Roboparty/RP1_test/hardware/mechanical/手臂胸腔/共用资料/README.md

# 手臂与胸腔共用资料

| 目录 | 内容 |
| --- | --- |
| [manufacturing](manufacturing/) | CNC、型材与钣金的 PDF 加工图和 STEP 模型 |
| [bom](bom/) | 机械采购工作簿及分类采购表 |
| [architecture](architecture/README.md) | 全平台、肢体连接与单支路架构图 |

采购入口为 [机械采购表](bom/mechanical-procurement.csv)。采购以零件号、版本、对应工装与加工图为依据，避免重复统计总装和分类表中的相同零件。不同机器人型号的夹具不直接互换。
