Roboparty/RP1_test/hardware/mechanical/手臂胸腔/手臂测试平台/README.md

# 手臂测试平台

用于手臂总成固定与测试接口集成，采用 LS75 手臂工装。

| 资料 | 入口 |
|---|---|
| 工装加工图 | [PDF](<图纸/YCL.M000438 LS75手臂工装.PDF>) · [STEP](<图纸/YCL.M000438 LS75手臂工装.STEP>) |
| BOM 与通用加工资料 | [共用资料](../共用资料/README.md) |

手臂与胸腔的通用加工资料和采购表位于共用资料目录。安装前核对机器人型号、工装接口、反力矩与运动空间，设置线束固定、支撑和防护。
