Roboparty/RP1_test/hardware/mechanical/手臂胸腔/胸腔测试平台/README.md

# 胸腔测试平台

用于胸腔总成固定与测试接口集成。`图纸/` 包含胸腔底板、航插安装板、立柱及 LOGO 板的 PDF / STEP。

- [BOM 与通用加工资料](../共用资料/README.md)

胸腔与手臂的通用加工资料和采购表位于共用资料目录。安装前核对接口尺寸、总质量、重心、反力路径和布线空间；腰部夹具应按具体总成单独匹配。
