Roboparty/RP1_test/hardware/mechanical/腿部/腿部负载测试平台/README.md

# 腿部负载测试平台

用于腿部总成固定及加载机构集成。本目录提供平台采购工作簿。

| 资料 | 入口 |
| --- | --- |
| 机械 BOM | [腿部老化测试平台 BOM 20260601.xlsx](<bom/腿部老化测试平台 BOM 20260601.xlsx>) |

采购使用工作表 `腿部老化测试平台 项目结构件 BOM`，按零件号和版本核对采购规格。其他工作表不纳入台架采购。

加载装置、测量链、回馈处理、重力支撑与防护应按机器人型号及目标工况配置。连接方式见[机电集成说明](../../../docs/integration.md)。
