Roboparty/RP1_test/hardware/mechanical/手臂胸腔/共用资料/architecture/README.md

# 硬件架构图

| 图 | 内容 |
|---|---|
| [platform-overview.svg](platform-overview.svg) | 上位机、控制柜、机器人总成、机械台架与安全/能量系统 |
| [limb-connection.svg](limb-connection.svg) | 带驱动器总成的供电、CAN 节点及辅助接口 |
| [channel-wiring.svg](channel-wiring.svg) | 单支路保护、固态开关与电压电流采样 |

SVG 为可编辑图源，PNG 用于预览。架构图表达功能关系；施工接线应依据原理图、端子表和机器人厂家的接口定义。
