Roboparty/RP1_test/hardware/SOURCE_LICENSE.md

# 硬件资料许可

RoboParty 自有的测试台架机械、电气设计及对应制造图、原创 BOM 数据采用 [CERN-OHL-W-2.0](LICENSE)。文档、参考模型和第三方素材按以下范围分别处理，不能只根据所在目录判断许可。

## 台架设计

许可覆盖项目贡献者有权授权的台架设计部分，包括手臂、胸腔共用支架、对应工装及腿部负载测试平台设计。主要资料入口：

- [手臂、胸腔共用资料](mechanical/手臂胸腔/共用资料/)：YCL 工装与支架的制造文件、台架采购清单。
- [手臂测试平台](mechanical/手臂胸腔/手臂测试平台/)与[胸腔测试平台](mechanical/手臂胸腔/胸腔测试平台/)：相应工装、底板和安装件图纸。
- [腿部负载测试平台](mechanical/腿部/腿部负载测试平台/)：采购工作簿中记录的平台自有设计部分。
- [电气资料](electrical/)：本项目原创的系统 BOM 数据及随项目提供的自有电气设计。

装配体引用的供应商零件、机器人参考部件、标准件模型及附带素材不因进入上述装配体而改用 CERN 许可。料号或文件名也不能单独证明权利归属；当前未逐件确认所有参考模型和嵌入素材的来源与再分发授权，详见 [第三方资料](../THIRD_PARTY.md)。

设计源资料入口为 [Roboparty/rp1_test](https://github.com/Roboparty/rp1_test/tree/main/hardware)。分发适用 CERN 许可的产品或修改设计时，应按该许可提供相应版本的完整源资料和通知；采用链接提供源资料时，接收者需要能够取得这些资料。架构说明图不能代替实际制造、安装所需的工程源资料。

## 说明文档与既有 MIT 授权

原创 README、搭建说明、测试方法和解释性架构图采用 [CC-BY-SA-4.0](../LICENSES/CC-BY-SA-4.0.txt)。制造图和实际电气设计属于前述硬件设计范围。

此前已获 MIT 授权的本目录原创说明文档、架构图、模板及脚本继续保留该选择。文档和说明图可选 `MIT OR CC-BY-SA-4.0`；脚本可选 `MIT OR Apache-2.0`。[标准 MIT 全文](../LICENSES/MIT.txt)和[原版权通知及范围](../LICENSES/MIT-HARDWARE-NOTICE.txt)随仓库保留，既有授权权益不撤回。

## 参考资料与品牌

供应商 CAD、机器人模型、纹理、厂家手册和 SDK 按原权利人的条款使用。采购工作簿中的外部模板、供应商或客户信息、嵌入图片也不在本项目统一授权范围内。RoboParty 标识及产品名称的商标使用未由上述许可授予。
