Roboparty/RP1_test/LICENSES/MIT-HARDWARE-NOTICE.txt

MIT License

Copyright (c) 2026 Humanoid Module Test Platform contributors

Permission is hereby granted, free of charge, to any person obtaining a copy
of the original documentation, diagrams, templates, and scripts in this
directory (the "Materials"), to deal in the Materials without restriction,
including without limitation the rights to use, copy, modify, merge, publish,
distribute, sublicense, and/or sell copies of the Materials, and to permit
persons to whom the Materials are furnished to do so, subject to these conditions:

The above copyright notice and this permission notice shall be included in
all copies or substantial portions of the Materials.

THE MATERIALS ARE PROVIDED "AS IS", WITHOUT WARRANTY OF ANY KIND, EXPRESS OR
IMPLIED, INCLUDING BUT NOT LIMITED TO THE WARRANTIES OF MERCHANTABILITY,
FITNESS FOR A PARTICULAR PURPOSE AND NONINFRINGEMENT. IN NO EVENT SHALL THE
AUTHORS OR COPYRIGHT HOLDERS BE LIABLE FOR ANY CLAIM, DAMAGES OR OTHER
LIABILITY, WHETHER IN AN ACTION OF CONTRACT, TORT OR OTHERWISE, ARISING FROM,
OUT OF OR IN CONNECTION WITH THE MATERIALS OR THE USE OR OTHER DEALINGS IN
THE MATERIALS.

Third-party source archives, CAD, manufacturing drawings, workbooks, SDKs,
manufacturer documents, and reference assets are excluded. Their original
rights are unchanged. See SOURCE_LICENSE.md before redistribution.
