Roboparty/RP1_test/docs/README.md

# 文档导航

| 任务 | 入口 |
|---|---|
| 了解组件与连接 | [软件模块](../software/README.md) · [架构](architecture.md) |
| 安装、升级、备份、恢复或排障 | [安装与运维](../software/docs/operations.md) |
| 理解记录、归档、核实、审批和统计 | [数据流程](../software/docs/data-workflow.md) |
| 运行或构建上位机 | [HMI](../software/host/README.md) · [构建](../software/host/docs/build.md) |
| 核对 PLC 协议及故障准入 | [PLC 对接](../software/host/docs/plc-integration.md) |
| 开发与测试 | [开发指南](development.md) |
| 制造与搭建台架 | [硬件](../hardware/README.md) |
| 准备测试与执行记录 | [测试用例](../test-cases/README.md) |
| 查找截图、动图与许可 | [媒体](media/README.md) · [许可](../LICENSES.md) |

执行前需要确定的参数见 [参数清单](../test-cases/open-items.md)。
