Roboparty/RP1_test/data-analysis/examples/README.md

# 合成分析样例

[synthetic-run](synthetic-run) 包含 9 行单关节合成遥测、元数据、4 条事件和[独立预期值](synthetic-run/expected.json)。80 ℃和暂停时的 9 rad 误差为核对统计范围设置的合成值。

- 总时间 8 s；active 为 `[0,3)` 和 `[5,8)`，共 6 s。
- active 采样点为 0、1、2、5、6、7 s；6 s 的位置缺失，剩余误差为 0.1、0.2、−0.3、−0.1、0 rad。
- RMS 为 `sqrt((0.01+0.04+0.09+0.01+0)/5)`，约 0.173205 rad；绝对峰值 0.3 rad。
- 暂停时的 9 rad 误差不计入 active 统计；暂停时 80 ℃仍是全程温度峰值。环境温度 25 ℃，温升 55 ℃。
- 4 s 温度缺失；温度有效样本 8 个。NaN 不补零。

运行命令见[分析入口](../README.md)。`expected.json` 保存人工核对的关键指标，测试校验这些预期值及缺失区间、重复时间等边界。

这组样例数据采用 [CC0-1.0](../../LICENSES.md)；脚本和说明文档的许可分别见仓库许可范围。
