Roboparty/RP1_test/data-analysis/docs/README.md

# 数据采集与分析指导

本目录解释从测试目的到分析结论的过程，帮助使用者接入自己的机器人数据。**当前仅有本说明；下列专题文档待编写，文件名为计划。**

## 计划文档

| 文档 | 重点 |
|---|---|
| `architecture.md` | 上位机、Service、PostgreSQL、InfluxDB、Grafana与离线分析的分工 |
| `data-format.md` | 遥测、事件、运行元数据、单位、时间关联和缺失值 |
| `collection-guide.md` | 基线、配置快照、采样、任务区间与异常前后记录 |
| `analysis-guide.md` | 按用例选择指标，同工况比较与结论边界 |
| `platform-integration.md` | 文件导出、Service接入、离线缓存、补传与运行编号关联 |

输入是 [测试用例](../../test-cases/README.md)、机器人配置及采集记录；输出是指标定义、采集要求和结果解释步骤。系统范围见 [software](../../software/README.md)，采集与接入分别见 [上位机](../../software/host/README.md) 和 [Service](../../software/service/README.md)。

## 从用例选指标

| 用例方向 | 重点观察 |
|---|---|
| 001/003站立 | 温升是否收敛、负载如何影响误差、有效时长是否达到目标 |
| 002/016行走 | 相同路线和负载下的温升、误差、保护与试后性能变化 |
| 004～009环境/存储 | 恢复后与基线的差异、异常是否在相同条件重复 |
| 012热保护 | 告警→降额→停机的顺序、触发条件和响应时间 |
| 020/021动态与操作任务 | 中断动作段、成功/失败、重试、人工接管及节拍变化 |

## 共同约定

先确认 active intervals，再计算有效任务时长；换电、检查、冷却和异常暂停分别保留。跟随误差按同动作、负载和阶段的 active 样本比较，报告峰值与均方根。温度统计保留全程，有环境温度时才计算温升。

缺失值保持未知，断采期间不外推正常运行。里程、制动距离和抓取成功率需要对应任务记录；能耗需要电压、电流及时间，不能以关节扭矩代替。异常信号、故障确认、根因和复测结论分开描述；单次运行不推 MTBF，脚本不自动判 PASS。

**完成条件：** 每篇指导均说明必要输入、计算范围、输出和不足条件，并能带读者完成 [合成示例](../examples/README.md)；计划文件发布后再加入直接链接和运行命令。
