Roboparty/RP1_test/software/host/DELIVERY.md

# RP1 TEST HMI 交付入口

本版为 2.0.4、Ubuntu 24.04 amd64。请使用 [完整新机部署说明](../README.md) 和 [当前上位机构建与配置说明](docs/LOCAL_CONTROL_BUILD.md)。

协议模式为 `reliability_v1`；`legacy` 仅保留旧客户端兼容源码，不是本仓库平台协议。测试数据审批尚未实现。
