Roboparty/RP1_test/docs/media/factory-hmi.jpg

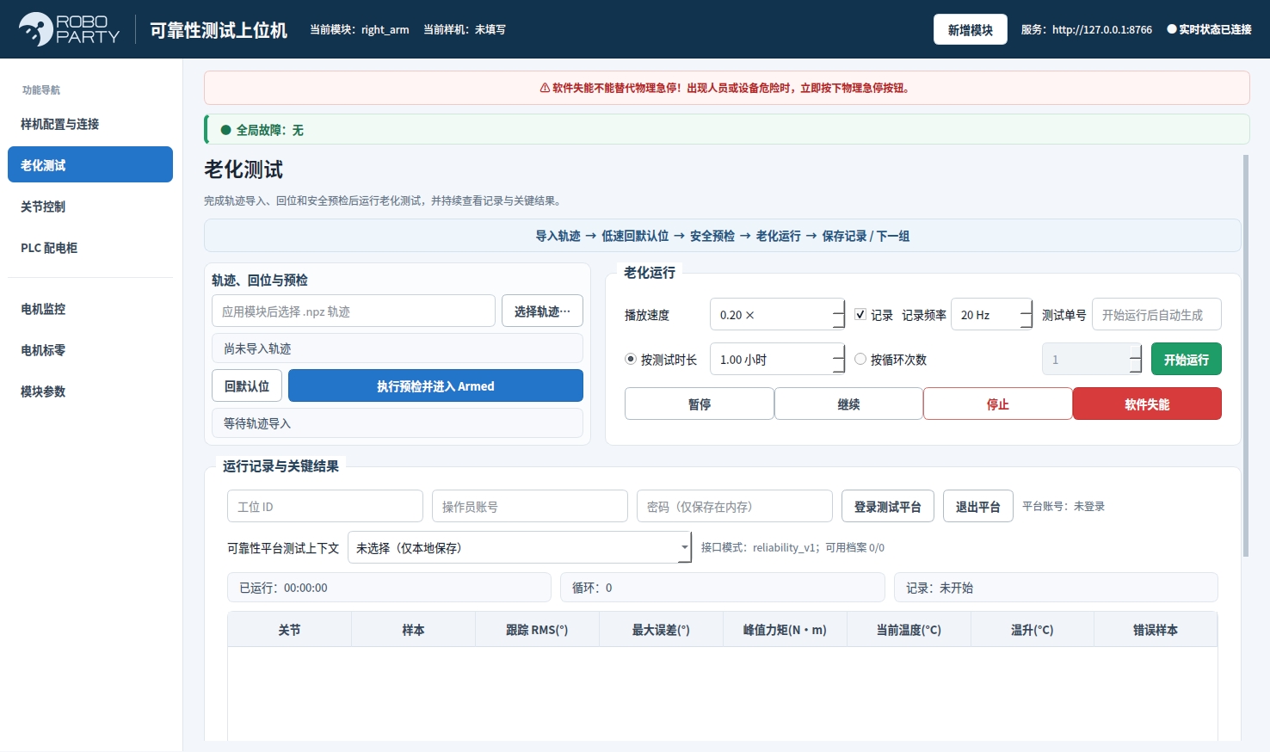
docs/media/factory-hmi.jpg
