Roboparty/RP1_test/docs/media/showcase/upper-body-dynamic-side.gif

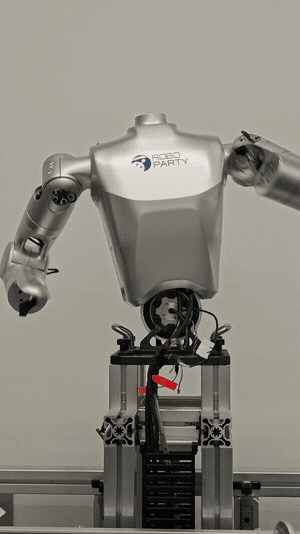
docs/media/showcase/upper-body-dynamic-side.gif
