Roboparty/RP1_test/hardware/mechanical/手臂胸腔/共用资料/cad/solidworks/20260625-103359.png

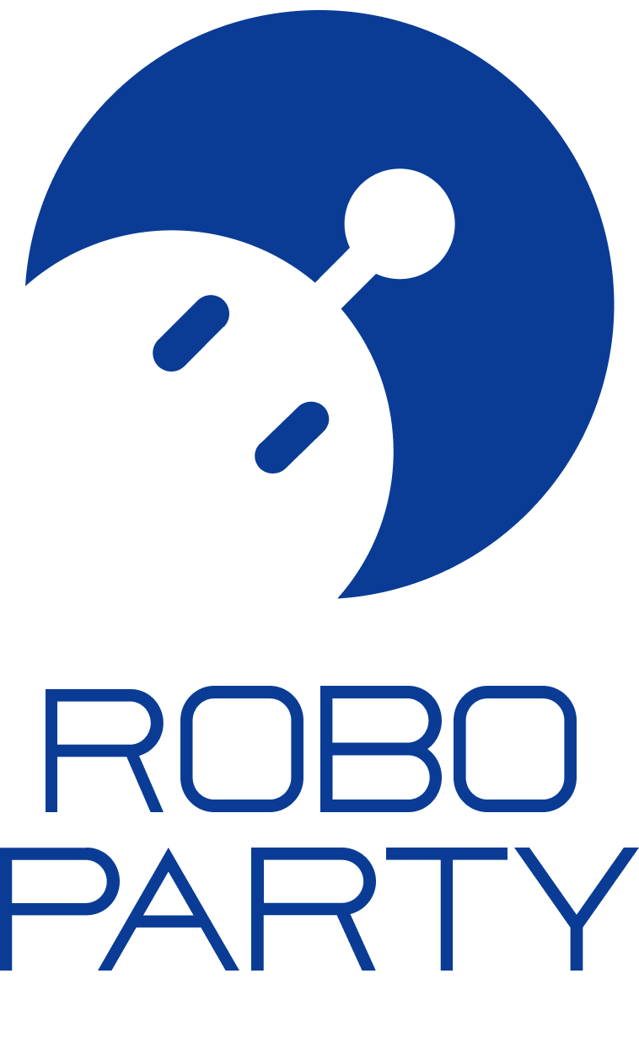
hardware/mechanical/手臂胸腔/共用资料/cad/solidworks/20260625-103359.png
