Roboparty/RP1_test/hardware/mechanical/腿部/腿部负载测试平台/cad/solidworks/grid10.jpg

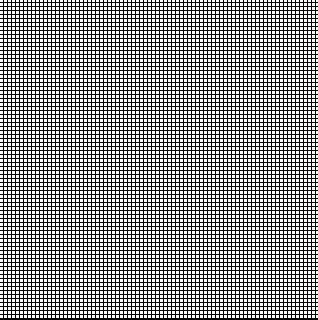
hardware/mechanical/腿部/腿部负载测试平台/cad/solidworks/grid10.jpg
