Roboparty/RP1_test/hardware/mechanical/手臂胸腔/共用资料/bom/standard-parts-procurement.csv

source_workbook | source_worksheet | source_excel_row | classification | item_no | part_no | revision | description | quantity_as_source | quantity_unit | material | heat_treatment | surface_treatment | single_weight_kg | machining_info | design_status_as_source | purchase_status_as_source | notes_as_source | review_flags | order_status | selection_gate
bom/老化简易测试架 标准件清单 20260716.xlsx | 胸腔老化测试架 标准件清单 | 5 | standard-parts | 1 |  |  | 耐高温脚轮C-HTB100-N_ | 8 | TBD-source-not-declared |  |  |  |  |  |  |  |  | supplier-model-only-no-internal-part-number;cached-reference-image-error | source-reference-not-approved-for-order | Confirm rig allocation; drawing revision; quantities; supplier; fit and safety before purchase
bom/老化简易测试架 标准件清单 20260716.xlsx | 胸腔老化测试架 标准件清单 | 6 | standard-parts | 2 |  |  | 脚杯E-LWAD32-D148-M30-L200 | 8 | TBD-source-not-declared |  |  |  |  |  |  |  |  | supplier-model-only-no-internal-part-number;cached-reference-image-error | source-reference-not-approved-for-order | Confirm rig allocation; drawing revision; quantities; supplier; fit and safety before purchase
bom/老化简易测试架 标准件清单 20260716.xlsx | 胸腔老化测试架 标准件清单 | 7 | standard-parts | 3 |  |  | 把手C-NUHFNS66 | 6 | TBD-source-not-declared |  |  |  |  |  |  |  |  | supplier-model-only-no-internal-part-number;cached-reference-image-error | source-reference-not-approved-for-order | Confirm rig allocation; drawing revision; quantities; supplier; fit and safety before purchase
bom/老化简易测试架 标准件清单 20260716.xlsx | 胸腔老化测试架 标准件清单 | 8 | standard-parts | 4 |  |  | 梅花螺丝E-LHAT12-M6-D25-L25 | 4 | TBD-source-not-declared |  |  |  |  |  |  |  |  | supplier-model-only-no-internal-part-number;cached-reference-image-error | source-reference-not-approved-for-order | Confirm rig allocation; drawing revision; quantities; supplier; fit and safety before purchase
bom/老化简易测试架 标准件清单 20260716.xlsx | 胸腔老化测试架 标准件清单 | 9 | standard-parts | 5 |  |  | 把手AKL13-130 | 3 | TBD-source-not-declared |  |  |  |  |  |  |  |  | supplier-model-only-no-internal-part-number;cached-reference-image-error | source-reference-not-approved-for-order | Confirm rig allocation; drawing revision; quantities; supplier; fit and safety before purchase
bom/老化简易测试架 标准件清单 20260716.xlsx | 胸腔老化测试架 标准件清单 | 10 | standard-parts | 6 |  |  | 水平仪BME31-D32 | 1 | TBD-source-not-declared |  |  |  |  |  |  |  |  | supplier-model-only-no-internal-part-number;cached-reference-image-error | source-reference-not-approved-for-order | Confirm rig allocation; drawing revision; quantities; supplier; fit and safety before purchase
bom/老化简易测试架 标准件清单 20260716.xlsx | 胸腔老化测试架 标准件清单 | 11 | standard-parts | 7 |  |  | 型材角码ABC03-5010-80B-40 | 8 | TBD-source-not-declared |  |  |  |  |  |  |  |  | supplier-model-only-no-internal-part-number;cached-reference-image-error | source-reference-not-approved-for-order | Confirm rig allocation; drawing revision; quantities; supplier; fit and safety before purchase
bom/老化简易测试架 标准件清单 20260716.xlsx | 胸腔老化测试架 标准件清单 | 12 | standard-parts | 8 |  |  | 磁铁 直径20厚度8孔6 | 2 | TBD-source-not-declared |  |  |  |  |  |  |  |  | supplier-model-only-no-internal-part-number;cached-reference-image-error | source-reference-not-approved-for-order | Confirm rig allocation; drawing revision; quantities; supplier; fit and safety before purchase
bom/老化简易测试架 标准件清单 20260716.xlsx | 胸腔老化测试架 标准件清单 | 13 | standard-parts | 9 |  |  | 磁铁 长20宽10厚5 | 2 | TBD-source-not-declared |  |  |  |  |  |  |  |  | supplier-model-only-no-internal-part-number;cached-reference-image-error | source-reference-not-approved-for-order | Confirm rig allocation; drawing revision; quantities; supplier; fit and safety before purchase
bom/老化简易测试架 标准件清单 20260716.xlsx | 胸腔老化测试架 标准件清单 | 14 | standard-parts | 10 |  |  | T型螺母 40型-M6 | 200 | TBD-source-not-declared |  |  |  |  |  |  |  |  | supplier-model-only-no-internal-part-number | source-reference-not-approved-for-order | Confirm rig allocation; drawing revision; quantities; supplier; fit and safety before purchase
bom/老化简易测试架 标准件清单 20260716.xlsx | 胸腔老化测试架 标准件清单 | 15 | standard-parts | 11 |  |  | 内六角螺丝M6*16 | 100 | TBD-source-not-declared |  |  |  |  |  |  |  |  | supplier-model-only-no-internal-part-number | source-reference-not-approved-for-order | Confirm rig allocation; drawing revision; quantities; supplier; fit and safety before purchase
bom/老化简易测试架 标准件清单 20260716.xlsx | 胸腔老化测试架 标准件清单 | 16 | standard-parts | 12 |  |  | 内六角螺丝M6*20 | 100 | TBD-source-not-declared |  |  |  |  |  |  |  |  | supplier-model-only-no-internal-part-number | source-reference-not-approved-for-order | Confirm rig allocation; drawing revision; quantities; supplier; fit and safety before purchase
bom/老化简易测试架 标准件清单 20260716.xlsx | 胸腔老化测试架 标准件清单 | 17 | standard-parts | 13 |  |  | 内六角螺丝M6*22 | 100 | TBD-source-not-declared |  |  |  |  |  |  |  |  | supplier-model-only-no-internal-part-number | source-reference-not-approved-for-order | Confirm rig allocation; drawing revision; quantities; supplier; fit and safety before purchase
bom/老化简易测试架 标准件清单 20260716.xlsx | 胸腔老化测试架 标准件清单 | 18 | standard-parts | 14 |  |  | 平圆头内六角螺丝M6*10 | 20 | TBD-source-not-declared |  |  |  |  |  |  |  |  | supplier-model-only-no-internal-part-number | source-reference-not-approved-for-order | Confirm rig allocation; drawing revision; quantities; supplier; fit and safety before purchase
bom/老化简易测试架 标准件清单 20260716.xlsx | 胸腔老化测试架 标准件清单 | 19 | standard-parts | 15 |  |  | 平头内六角螺丝M5*20 | 20 | TBD-source-not-declared |  |  |  |  |  |  |  |  | supplier-model-only-no-internal-part-number | source-reference-not-approved-for-order | Confirm rig allocation; drawing revision; quantities; supplier; fit and safety before purchase
