Roboparty/RP1_test/hardware/electrical/system-bom.csv

id | tag | category | quantity | unit | item | reference_model | use | selection_gate | source | status | notes
B001 | QF0 | project-reference | 1 | 只 | 交流进线剩余电流及过流保护 | Schneider A9DC3625 | 保护交流进线及下游配电 | 核对现场供电制式和可用短路电流及电源厂家要求；型号适用性与额定由工程师复核 | LFD835 V1.9 四通道电气参考配置 | DESIGN_REFERENCE_NOT_PURCHASE_APPROVED | 参考1P+N C25 30mA；供电和保护条件按应用确定
B002 | QF0-AUX | project-reference | 1 | 只 | 总保护器辅助触点 | Schneider A9A26914 | 向PLC提供QF0辅助状态 | 核对与QF0兼容性及低电平触点接线；辅助状态不等于安全隔离证明 | LFD835 V1.9 四通道电气参考配置 | DESIGN_REFERENCE_NOT_PURCHASE_APPROVED | 现参考11COM/12NC/14NO；不同产品不得套用针号
B003 | QF1 | project-reference | 1 | 只 | 直流源交流支路保护 | Schneider A9F18225 | 保护PS1交流输入支路 | 按PS1实际输入电流及冲击电流与线路及上级保护协调 | LFD835 V1.9 四通道电气参考配置 | DESIGN_REFERENCE_NOT_PURCHASE_APPROVED | 参考AC 2P C25；选择性与短路能力应协调
B004 | QF24 | project-reference | 1 | 只 | 控制电源交流支路保护 | Schneider A9F18206 | 保护PS24及H0交流支路 | 核对PS24启动冲击及全部细支线短路耐受；H0单独保护方案待复核 | LFD835 V1.9 四通道电气参考配置 | DESIGN_REFERENCE_NOT_PURCHASE_APPROVED | 参考AC 2P C6；H0细支线需按导线与负载匹配保护
B005 | KM0 | project-reference | 1 | 只 | PS1交流输入主接触器 | Schneider LC1D25BD | 由K0许可控制PS1交流输入并回传辅助反馈 | 核对单相负载使用方式及电源冲击电流及线圈保护；不宣称功能安全 | LFD835 V1.9 四通道电气参考配置 | DESIGN_REFERENCE_NOT_PURCHASE_APPROVED | 24VDC线圈；主接触器断开不证明直流母线已经无电
B006 | PS1 | project-reference | 1 | 台 | 可编程直流源 | 6236-60-60 | 为四工位公共直流母线供电并限制总输出电流 | 取得准确厂家型号及输入条件及0-60V/60A/3600W适用范围；取得回灌能力书面数据并完成DUT预算 | LFD835 V1.9 四通道电气参考配置 | DESIGN_REFERENCE_REGEN_UNVERIFIED | 48V时60A对应2.88kW；60V额定与100V传感器量程都不等于DUT允许电压
B007 | PS24 | project-reference | 1 | 台 | 柜内24V控制电源 | MEAN WELL HDR-100-24N | 供PLC及继电器及柜内变送器与CAN辅助电源 | 按连续及吸合峰值负载预算并核对供货数据表及降额 | LFD835 V1.9 四通道电气参考配置 | DESIGN_REFERENCE_NOT_PURCHASE_APPROVED | 控制电源容量不默认覆盖肢体抱闸或额外逻辑负载；接地端形式按完整型号核对
B008 | PLC1 | project-reference | 1 | 台 | 柜内控制器 | Siemens 6ES7214-1AH50-0XB0 CPU1214C G2 | 通断联锁及状态采集及上位机Modbus TCP | 核对硬件与固件及TIA版本；普通PLC不作为安全PLC | LFD835 V1.9 四通道电气参考配置 | DESIGN_REFERENCE_NOT_PURCHASE_APPROVED | 定义启动、失联与供电恢复时的输出状态；设置防自动重启
B009 | AI1 | project-reference | 1 | 台 | 八路模拟量输入模块 | Siemens 6ES7231-4HF50-0XB0 SM1231 AI8 | 采集VS1-4及IS1-4的0-10V信号 | 核对量程及差分接法及共模限制及硬件地址；每通道独立校准 | LFD835 V1.9 四通道电气参考配置 | DESIGN_REFERENCE_ALL_8_CHANNELS_ALLOCATED | 八路已全部分配；新增扭矩或温度不能默认占用现有空余AI
B010 | CM1 | project-reference | 1 | 块 | RS485通信板 | Siemens 6ES7241-1CA50-0XB0 CB1241 RS485 | PLC与PS1之间Modbus RTU | 核对准确订货号及A/B及信号参考端定义和PS1手册；确认通信参数一致性及超时处理 | LFD835 V1.9 四通道电气参考配置 | DESIGN_REFERENCE_BACKPLANE_POWERED | 背板供电；信号参考端与电源M及屏蔽不得混用
B011 | CAN1 | project-reference | 1 | 台 | 四路USB-CAN接口 | ZLG USBCANFD-400U | Linux主机与四个工位的CAN网络交换报文 | 按供货硬件版本核对端口及Linux/CPU架构SDK与经典CAN/FD及隔离要求 | LFD835 V1.9 四通道电气参考配置 | TBD_HARDWARE_FIRMWARE_AND_SDK_COMPATIBILITY | 不是四只单路适配器；支持CAN FD不等于DUT允许使用FD模式
B012 | K0/K2-K5 | project-reference | 5 | 套 | 中间继电器及底座 | Schneider RXM2AB2BD + RXZE1M2C | K0控制KM0；K2-K5控制四路SSR许可 | 核对24VDC线圈和底座及触点负载及感性抑制附件；避免重复安装保护模块 | LFD835 V1.9 四通道电气参考配置 | DESIGN_REFERENCE_NOT_PURCHASE_APPROVED | K0及K2-K5共五套中间继电器
B013 | QFDC1-4 | project-reference | 4 | 只 | 双极直流支路保护器件 | Schneider A9N18225 | 分断各工位正负两极并保护支路 | 必须取得本项目直流额定及分断能力及极性/方向及两极接法依据；与PS1限流及导线协调 | LFD835 V1.9 四通道电气参考配置 | TBD_DC_APPLICABILITY_AND_POLARITY | 参考DC 2P C25；隔离适用性另行核对；无辅助反馈时不能据电压读数推断机械触点状态
B014 | KD1-4 | project-reference | 4 | 套 | 直流SSR及匹配散热安装附件 | CHINT ZTP-60DD | 按人工许可及PLC许可开关各工位正极 | 核对实际负载及温升降额及漏电及失效短路和厂家接线；不得替代机械隔离 | LFD835 V1.9 四通道电气参考配置 | DESIGN_REFERENCE_THERMAL_VALIDATION_REQUIRED | 针脚按准确厂家图核对；SSR额定电流需结合温升与安装条件
B015 | IS1-4 | project-reference | 4 | 只 | 穿孔式电流变送器 | Vadias VD-D14-15 | 采集每工位直流输入电流 | 核对实际0-50A到0-10V量程及方向及供电及准确针号并用已知电流校准 | LFD835 V1.9 四通道电气参考配置 | DESIGN_REFERENCE_UNIDIRECTIONAL_RANGE | 不能称为双向电流测量；整肢体母线电流不是单关节相电流或直接扭矩
B016 | VS1-4 | project-reference | 4 | 只 | 隔离电压变送器 | Vadias VD-D13U定制规格；完整订货号TBD | 测量各工位输出端电压 | 逐只核对真实量程及三方隔离及耐压与实物针号；同步PLC及通信编码并校准 | LFD835 V1.9 四通道电气参考配置 | TBD_ACTUAL_RANGE_PINOUT_AND_SCALING | 目标规格0-100V到0-10V；实际量程、隔离、针脚、PLC换算与通信编码逐通道一致
B017 | XD24-1 | project-reference | 1 | 只 | 柜内0V分配模块 | 现有1进30出DIN分线模块；准确型号TBD | 分配柜内24V控制0V | 取得额定及导线范围及端口允许导线数量及安装要求 | LFD835 V1.9 四通道电气参考配置 | TBD_PORT_RATING | 0V控制公共端不等于PE或浮地动力DC负极
B018 | XD24-2/3 | project-reference | 2 | 只 | 常供及复位后24V分配模块 | 现有1进8出DIN分线模块；准确型号TBD | 分别分配常供24V和SRESET后PLC/AI供电 | 取得额定与双线端子能力；不允许菊花链双线时重设计分配点 | LFD835 V1.9 四通道电气参考配置 | TBD_PORT_RATING | SRESET后供电范围不得误写为整柜或DUT全断电
B019 | X48+/X48- | project-reference | 2 | 只 | 公共直流大电流分配块 | 1进6出；准确型号TBD | 将PS1公共母线分配至四支路 | 按总连续/峰值电流及导线截面与温升选型；取得额定及接线范围 | LFD835 V1.9 四通道电气参考配置 | TBD_RATING_AND_TERMINALS | 参考设计要求连续至少60A；X48-绿色壳体需永久标DC-/非PE
B020 | XPE | project-reference | 1 | 套 | 保护接地排及屏蔽夹 | 侧装铜排及360度屏蔽夹；准确型号TBD | 柜体及门板及电源机壳等电位与屏蔽连接 | 核对至少20个独立落点及保护连接能力；区分保护接地和屏蔽功能 | LFD835 V1.9 四通道电气参考配置 | TBD_CAPACITY_AND_INSTALLATION | PE不经过QF或SSR；不得以屏蔽代替保护导体
B021 | X1-4 | project-reference | 4 | 套 | 柜侧四线工位出口 | 准确连接器型号TBD | 柜侧约定DC+/DC-/CAN_H/CAN_L | 按整肢体母线电流及电压及线径与防错插要求选型；DUT端针脚另冻结 | LFD835 V1.9 四通道电气参考配置 | TBD_CONNECTOR_RATING | 柜侧1/2/3/4不是机器人通用针脚；不可带载插拔；无PE或CAN参考专用针脚
B022 | S1-4 | project-reference | 4 | 只 | 人工工位许可开关 | 保持型开关；具体型号TBD | 硬接线许可与PLC支路命令形成许可条件 | 核对硬接线许可的实现及触点额定；按控制需求配置辅助反馈 | LFD835 V1.9 四通道电气参考配置 | REFERENCE_HARD_PERMISSION_WITH_SEPARATE_FEEDBACK | 人工硬接线许可与辅助反馈分别设计；未配置反馈时不宣称具备开关位置反馈
B023 | SRESET | project-reference | 1 | 只 | PLC控制供电复位按钮 | 瞬时常闭触点；具体型号TBD | 仅切断PLC/AI控制供电用于重新启动 | 按实际切断范围及触点直流容量接线并加准确标识 | LFD835 V1.9 四通道电气参考配置 | DESIGN_REFERENCE_NOT_EMERGENCY_STOP | 不是急停；PS24及IS/VS及CAN和DUT母线不因此全部隔离
B024 | H0/H1 | project-reference | 1+1 | 套 | 交流存在灯及三色塔灯 | H0为230VAC；H1为24V共阴极；具体型号TBD | 交流状态及软件运行/通信/故障提示 | 核对工作电压及灯电流及H0细支线保护；灯色不作为验电依据 | LFD835 V1.9 四通道电气参考配置 | DESIGN_REFERENCE_NOT_SAFETY_INDICATION | H0位于QF24下游；灯灭不能证明柜内无电
B025 | CABINET | project-reference | 1 | 套 | 柜体及安装板与导轨线槽 | V1.9安装板700x650mm；柜体准确型号TBD | 强弱电分区及器件安装与维护 | 按电源尺寸及风道及SSR损耗及环境和维护间距复核；不直接复制外形 | LFD835 V1.9 四通道电气参考配置 | DESIGN_REFERENCE_THERMAL_VALIDATION_REQUIRED | 布局按器件尺寸、强弱电分区、散热及维护空间确定
B026 | WIRE-CAB | project-reference | TBD | 套 | 柜内导线端头标识及屏蔽通信线 | 参考主干16mm2及支路4mm2；实际规格TBD | 柜内动力控制模拟量PE通信连接 | 按长度及敷设及成束温度及端子及保护校核后统计长度；准确线材规格待冻结 | LFD835 V1.9 四通道电气参考配置 | TBD_CABLE_SELECTION_AND_QUANTITY | 不可把16mm2/4mm2推广为任意60A/25A工况通用选择
B027 | PC1 | required-new | 1 | 台 | Linux上位机 | 型号TBD | 运行柜控制客户端及DUT协议适配与记录 | 确认CPU架构及Linux版本和CAN SDK及Ethernet/USB口数及记录容量；已有合格设备可复用 | docs/hardware-build-manual.md | TBD_HOST_AND_SDK | 不是实时伺服驱动器或安全控制器；不得直接旁路柜内许可
B028 | NET1 | required-new | 1 | 套 | 控制网线及所需网络连接附件 | 型号及长度TBD | Linux与PLC的隔离控制网络 | 确认唯一IP及子网及物理接口与工业环境；多设备时选择合适交换机而非堆叠同IP | docs/hardware-build-manual.md | TBD_NETWORK_PLAN | Modbus TCP不提供认证加密；不得直接暴露公网
B029 | USB1 | required-new | 1 | 根 | PC到CAN接口卡USB线 | 与供货设备匹配的屏蔽成品线；长度TBD | Linux与USBCANFD-400U数据连接 | 核对接口类型及长度和供电要求；固定防拉脱 | docs/hardware-build-manual.md | TBD_CABLE_AND_ROUTE | CAN接口卡辅助电源范围以该供货版本手册为准
B030 | HARNESS1-4 | required-new | 4 | 套 | 柜出口至已带驱动总成的专用线束 | 按DUT接口图定制；型号TBD | 传输各工位DC动力与CAN并按需增加其它独立接口 | 取得双方针脚及电流及CAN线规和屏蔽要求；完成断电逐芯核对及极性检验 | docs/hardware-build-manual.md | TBD_DUT_PINOUT_AND_LOAD | 四工位是示例；不直接再买每关节伺服驱动；POWER与CAN用途标签必须明确
B031 | MATE1-4 | required-new | 4 | 套 | DUT对接插头及护套锁紧应力释放附件 | 按DUT准确连接器订货号采购 | 制作专用线束并防错插及固定线缆 | 冻结公母及触点及额定电压/电流及压接工艺和DUT端针号 | DUT厂家接口图 | TBD_MATING_CONNECTOR | 与HARNESS项属于线束装配分项；汇总采购时避免重复计入整套线束价格或数量
B032 | FIXTURE1-4 | required-new | 4 | 套 | 肢体固定夹具及安装底座 | 按实际总成设计；型号TBD | 固定臂/腿并承受重力及反作用力矩 | 取得质量重心及最大关节转矩及运动范围并完成结构复核；机械限位及防坠独立于软件 | docs/hardware-build-manual.md | TBD_MECHANICAL_DESIGN | 四套只是四工位示例；不得将带电肢体放置在不固定的桌面上运动
B033 | GUARD | required-new | TBD | 套 | 运动区域防护及防坠/支撑措施 | 按风险评估设计；型号TBD | 限制人员接触运动危险区域并防重力坠落 | 运动测试前由专业人员完成风险评估及机械防护和安全功能验收 | docs/hardware-build-manual.md | TBD_RISK_ASSESSMENT | 支撑/防护不能以CAN停止报文或电源断开替代；不声明安全等级
B034 | CAN-REF | conditional | TBD | 套 | CAN信号参考及额外接口线束 | 按两端手册；型号TBD | 在接口共模或厂商要求需要时提供CAN参考 | 若任何一端要求参考导体则必须新增准确接口并校核共模及隔离；不得用屏蔽代替 | DUT厂家手册 | TBD_REFERENCE_REQUIREMENT | 现四芯柜口没有专用CAN参考针脚；不得随意并到DC-或PE
B035 | AUX-DUT | conditional | TBD | 套 | DUT独立逻辑/辅助电源及支路保护 | 额定及型号TBD | 总成需要独立逻辑/传感器供电时使用 | 取得DUT电压电流及隔离/共地要求；重算24V预算或新增供电并保护细支线 | DUT厂家手册 | TBD_AUX_POWER_REQUIREMENT | 不默认可直接从现柜PS24取电；也不默认必须24V
B036 | BRAKE-DUT | conditional | TBD | 套 | 抱闸供电与控制及必要反馈 | 额定及型号TBD | 有外接抱闸或厂家要求独立控制时使用 | 按厂家抱闸电压电流及释放/制动时间和驱动接口设计；与防坠及停机时序协调 | DUT厂家抱闸与驱动手册 | TBD_BRAKE_REQUIREMENT | 失电抱闸及普通驱动DO不自动具有安全保持能力；有些DO不输出电源电压
B037 | SAFE-CHAIN | conditional | TBD | 套 | 独立急停/门联锁及安全控制与输出链 | 按风险评估选安全继电器或安全PLC及配套输出 | 在存在运动或其它危险的工况下实现经过验证的安全功能 | 运动前冻结停机方式及STO/能量切断/抱闸策略和故障检测并专业验收 | docs/hardware-build-manual.md | TBD_SAFETY_DESIGN_REQUIRED_BEFORE_MOTION | conditional表示具体架构依风险选择不是可以省略安全；现柜SRESET不承担此功能
B038 | PRECHARGE | conditional | TBD | 套 | 预充/上电冲击限制模块 | 按DUT厂家要求选型；型号TBD | 多个内置驱动或大输入电容导致冲击时限制启动电流 | 取得总电容及允许充电曲线和上电时序；校核开关额定与旁路和失败处理 | DUT及PS1厂家手册 | TBD_INRUSH_AND_CAPACITANCE | 不得假定SSR可以代替合规预充或允许任意热插拔
B039 | REGEN | conditional | TBD | 套 | 反向能量吸收/消纳系统 | 再生电源或经确认的制动吸收系统；型号TBD | 测试工况产生回灌且现电源能力不足或未知时处理能量 | 冻结最大反向电流及功率及单次能量/占空比和过压阈值；完成热与电气安全设计 | DUT回馈工况与PS1厂家吸收能力参数 | TBD_REGEN_CAPABILITY | 反灌阻断不等于吸收；在关闭此门禁前禁止回灌加载工况
B040 | LIMB-DIST | conditional | TBD | 套 | 柜外总成动力分配及子支路保护盒 | 按总成接口及内部配电设计；型号TBD | 总成没有已核验内部配电时分配到多个驱动节点 | 确认每条细支线的保护与总成电流及接插件能力；公共C25不能直接证明内部细线受保护 | DUT配电图 | TBD_INTERNAL_DISTRIBUTION | 已带驱动器不等于已具备符合测试工况的总成配电
B041 | DUT-GW | conditional | TBD | 台 | 与DUT协议匹配的通信接口或网关 | 按OEM接口；型号TBD | 总成不是CAN入口或含专用控制器时适配通信 | 确认EtherCAT/Ethernet/串口等真实入口与Linux接口及实时要求；不得猜测CAN报文 | DUT通信协议 | TBD_TRANSPORT_AND_PROTOCOL | CAN口不是所有已带驱动肢体的通用入口；可能需更换测试对象侧通信架构
B042 | DAQ-EXT | optional | TBD | 台 | 性能测量采集与信号调理模块 | 量程及采样率与接口TBD | 扩展扭矩/位置/温度等独立测量链 | 按同步误差及带宽及电压/电桥/编码器接口和隔离选型并校准 | docs/hardware-build-manual.md | TBD_PERFORMANCE_TEST_SPEC | PLC慢速V/I监测不等于高速功率或转矩波形采集
B043 | TORQUE | optional | TBD | 套 | 校准扭矩或末端力/力矩测量链 | 传感器与匹配评价器；量程TBD | 测实际机械输出而不是用母线电流直接推算 | 按工位最大转矩及速度及过载及带宽与机械接口选择；取得校准与调理要求 | https://www.kistler.com.cn/en/testing-electric-motors/testing-electric-motors/C00000159 | TBD_MEASUREMENT_ARCHITECTURE | 旋转单轴与多关节肢体需不同加载/测量结构；不默认0-10V可接现AI
B044 | LOAD-RIG | optional | TBD | 套 | 机械加载装置及其驱动/电源 | 测功机或末端加载机构；参数TBD | 受控加载及效率/耐久性能测试 | 按转矩速度功率及运动行程和能量去向设计；完成防护与同步测量 | docs/hardware-build-manual.md | TBD_LOAD_AND_ENERGY_DESIGN | 电子电阻负载不能直接给肢体机械输出施加受控转矩
B045 | POSITION | optional | TBD | 套 | 独立位置/转速与温度测量链 | 传感器及采集接口TBD | 需要独立验证精度/热状态时使用 | 按量程及安装与带宽及校准决定；先评估OEM回传是否满足目标 | docs/hardware-build-manual.md | TBD_ACCURACY_AND_SAMPLING | OEM角度/电流遥测不是已校准的独立真值；柜内AI无空余
B046 | TEST-TOOLS | required-new | 1 | 套 | 装配检验及校准测试工具 | 工具量程及类别TBD | 逐芯/极性/保护连接检查及已知点对比和故障检验 | 由专业人员选择适用仪表及测试方法；绝缘测试须隔离不耐压电子器件 | docs/hardware-build-manual.md | TBD_TEST_PLAN_AND_QUALIFICATION | 至少覆盖电压/电流对比及接线检查；不提供未经核对的绝缘试验电压或直接短路试验
