Roboparty/RP1_test/hardware/mechanical/手臂胸腔/共用资料/bom/profiles-procurement.csv

source_workbook | source_worksheet | source_excel_row | classification | item_no | part_no | revision | description | quantity_as_source | quantity_unit | material | heat_treatment | surface_treatment | single_weight_kg | machining_info | design_status_as_source | purchase_status_as_source | notes_as_source | review_flags | order_status | selection_gate
manufacturing/profiles/老化简易测试架 型材件清单 20260716.xlsx | 胸腔老化测试架 型材件清单 | 5 | profiles | 1 | YCL.M000689 | 01 | 测试底座支架 | 2 | TBD-source-not-declared |  |  |  |  |  |  |  | 见图纸 | cached-reference-image-error | source-reference-not-approved-for-order | Confirm rig allocation; drawing revision; quantities; supplier; fit and safety before purchase
manufacturing/profiles/老化简易测试架 型材件清单 20260716.xlsx | 胸腔老化测试架 型材件清单 | 6 | profiles | 2 | YCL.M000691 | 01 | 80立柱 | 1 | TBD-source-not-declared |  |  |  |  |  |  |  | 见图纸 | cached-reference-image-error | source-reference-not-approved-for-order | Confirm rig allocation; drawing revision; quantities; supplier; fit and safety before purchase
manufacturing/profiles/老化简易测试架 型材件清单 20260716.xlsx | 胸腔老化测试架 型材件清单 | 7 | profiles | 3 | YCL.M000696 | 01 | 胸腔立柱 | 1 | TBD-source-not-declared |  |  |  |  |  |  |  | 见图纸 | cached-reference-image-error | source-reference-not-approved-for-order | Confirm rig allocation; drawing revision; quantities; supplier; fit and safety before purchase
