Roboparty/RP1_test/hardware/mechanical/手臂胸腔/共用资料/bom/sheet-metal-procurement.csv

source_workbook | source_worksheet | source_excel_row | classification | item_no | part_no | revision | description | quantity_as_source | quantity_unit | material | heat_treatment | surface_treatment | single_weight_kg | machining_info | design_status_as_source | purchase_status_as_source | notes_as_source | review_flags | order_status | selection_gate
manufacturing/sheet-metal/老化简易测试架 钣金件加工清单 20260716.xlsx | 老化简易测试架 CNC件加工清单 | 5 | sheet-metal | 1 | YCL.M000692 | 01 | 支架L件 | 8 | TBD-source-not-declared | Q235 |  | 烤漆白色 |  |  |  |  |  | cached-reference-image-error | source-reference-not-approved-for-order | Confirm rig allocation; drawing revision; quantities; supplier; fit and safety before purchase
manufacturing/sheet-metal/老化简易测试架 钣金件加工清单 20260716.xlsx | 老化简易测试架 CNC件加工清单 | 6 | sheet-metal | 2 | YCL.M000694 | 01 | LOGO板 | 1 | TBD-source-not-declared | Q235 |  | 烤漆白色 |  |  |  |  |  | cached-reference-image-error | source-reference-not-approved-for-order | Confirm rig allocation; drawing revision; quantities; supplier; fit and safety before purchase
manufacturing/sheet-metal/老化简易测试架 钣金件加工清单 20260716.xlsx | 老化简易测试架 CNC件加工清单 | 7 | sheet-metal | 3 | YCL.M000699 | 01 | LOGO板（胸腔） | 1 | TBD-source-not-declared | Q235 |  | 烤漆白色 |  |  |  |  |  | cached-reference-image-error | source-reference-not-approved-for-order | Confirm rig allocation; drawing revision; quantities; supplier; fit and safety before purchase
manufacturing/sheet-metal/老化简易测试架 钣金件加工清单 20260716.xlsx | 老化简易测试架 CNC件加工清单 | 8 | sheet-metal | 4 | YCL.M000701 | 01 | 罩壳 | 1 | TBD-source-not-declared | AL6061 |  | 烤漆白色 |  |  |  |  |  | cached-reference-image-error | source-reference-not-approved-for-order | Confirm rig allocation; drawing revision; quantities; supplier; fit and safety before purchase
