Roboparty/RP1_test/software/database/imports/test_cases_202609181013.csv

id | name | module | priority | preconditions | expected_result | pass_criteria | owner | enabled | source | created_at | updated_at
SYS-REL-001 | 整机站立老化测试 | SYS 整机 | P0 |  |  |  |  | 1 | csv-import | 2026-08-04T23:16:19.838717+08:00 | 2026-08-04T23:16:19.838717+08:00
SYS-REL-002 | 整机行走循环老化测试 | SYS 整机 | P0 |  |  |  |  | 1 | csv-import | 2026-08-04T23:16:19.846727+08:00 | 2026-08-04T23:16:19.846727+08:00
SYS-REL-003 | 整机额定速度MTBF测试 | SYS 整机 | P0 |  |  |  |  | 1 | csv-import | 2026-08-04T23:16:19.853818+08:00 | 2026-08-04T23:16:19.853818+08:00
SYS-REL-004 | 整机高温运行测试 | SYS 整机 | P0 |  |  |  |  | 1 | csv-import | 2026-08-04T23:16:19.859857+08:00 | 2026-08-04T23:16:19.859857+08:00
SYS-REL-005 | 整机低温启动测试 | SYS 整机 | P0 |  |  |  |  | 1 | csv-import | 2026-08-04T23:16:19.866339+08:00 | 2026-08-04T23:16:19.866339+08:00
SYS-REL-006 | 整机高低温循环测试 | SYS 整机 | P0 |  |  |  |  | 1 | csv-import | 2026-08-04T23:16:19.873745+08:00 | 2026-08-04T23:16:19.873745+08:00
SYS-REL-007 | 整机湿热测试 | SYS 整机 | P0 |  |  |  |  | 1 | csv-import | 2026-08-04T23:16:19.879762+08:00 | 2026-08-04T23:16:19.879762+08:00
SYS-REL-008 | 整机高温存储后功能复测 | SYS 整机 | P1 |  |  |  |  | 1 | csv-import | 2026-08-04T23:16:19.885676+08:00 | 2026-08-04T23:16:19.885676+08:00
SYS-REL-009 | 整机低温存储后功能复测 | SYS 整机 | P1 |  |  |  |  | 1 | csv-import | 2026-08-04T23:16:19.891665+08:00 | 2026-08-04T23:16:19.891665+08:00
SYS-REL-010 | 整机振动测试 | SYS 整机 | P0 |  |  |  |  | 1 | csv-import | 2026-08-04T23:16:19.897935+08:00 | 2026-08-04T23:16:19.897935+08:00
SYS-REL-011 | 整机冲击测试 | SYS 整机 | P0 |  |  |  |  | 1 | csv-import | 2026-08-04T23:16:19.904711+08:00 | 2026-08-04T23:16:19.904711+08:00
REL-SARM-001 | 单臂模块空载连续摆动老化测试 | MOD 模块 | P0 | 单臂测试支架、可调直流源、自动化动作脚本、温度/电流采集、模拟负载、螺丝扭矩工具、视频记录设备 | 无结构损坏、无过温、无异常噪声、无通信丢包和紧固件松动。 | 无结构损坏、无过温、无异常噪声、无通信丢包和紧固件松动。 |  | 1 | csv-import | 2026-08-04T23:16:19.912011+08:00 | 2026-08-05 08:09:30.735528+00
REL-SARM-002 | 单臂模块带载连续摆动老化测试 | MOD 模块 | P0 | 单臂测试支架、末端模拟负载/砝码、法兰转接板、自动化动作脚本、温度/电流采集、模拟负载、螺丝扭矩工具、视频记录设备 | 无结构损坏、无过温、无异常噪声、无通信丢包和紧固件松动。 | 无结构损坏、无过温、无异常噪声、无通信丢包和紧固件松动。 |  | 1 | csv-import | 2026-08-04T23:16:19.918685+08:00 | 2026-08-05 08:09:30.735528+00
REL-SARM-003 | 单臂高温运行测试 | MOD 模块 | P0 | 高低温试验箱、单臂测试支架、末端模拟负载、法兰转接板、温度传感器、可调直流源、视频记录设备 | 高温下可启动/运行,温升受控,无热保护误触发或不可恢复故障。 | 高温下可启动/运行,温升受控,无热保护误触发或不可恢复故障。 |  | 1 | csv-import | 2026-08-04T23:16:19.924808+08:00 | 2026-08-05 08:09:30.735528+00
REL-SARM-004 | 单臂低温启动测试 | MOD 模块 | P0 | 高低温试验箱、单臂测试支架、末端模拟负载、法兰转接板、温度传感器、可调直流源、视频记录设备 | 低温可启动,动作无严重卡滞,恢复常温后无功能退化。 | 低温可启动,动作无严重卡滞,恢复常温后无功能退化。 |  | 1 | csv-import | 2026-08-04T23:16:19.931837+08:00 | 2026-08-05 08:09:30.735528+00
REL-SARM-005 | 单臂高低温循环测试 | MOD 模块 | P0 | 高低温试验箱、单臂测试支架、末端模拟负载、法兰转接板、温度传感器、可调直流源、视频记录设备 | 无开裂、松动、凝露导致的短路或不可恢复功能异常。 | 无开裂、松动、凝露导致的短路或不可恢复功能异常。 |  | 1 | csv-import | 2026-08-04T23:16:19.937893+08:00 | 2026-08-05 08:09:30.735528+00
REL-SARM-006 | 单臂湿热测试 | MOD 模块 | P0 | 高低温试验箱、单臂测试支架、末端模拟负载、法兰转接板、温湿度记录仪、可调直流源、视频记录设备 | 无进水/凝露导致的短路,无明显腐蚀,功能复测通过。 | 无进水/凝露导致的短路,无明显腐蚀,功能复测通过。 |  | 1 | csv-import | 2026-08-04T23:16:19.943900+08:00 | 2026-08-05 08:09:30.735528+00
REL-SARM-007 | 单臂高温存储后功能复测 | MOD 模块 | P1 |  |  |  |  | 1 | csv-import | 2026-08-04T23:16:19.949780+08:00 | 2026-08-05 08:09:30.735528+00
REL-SARM-008 | 单臂低温存储后功能复测 | MOD 模块 | P1 |  |  |  |  | 1 | csv-import | 2026-08-04T23:16:19.954640+08:00 | 2026-08-05 08:09:30.735528+00
REL-SARM-009 | 单臂振动测试 | MOD 模块 | P0 |  |  |  |  | 1 | csv-import | 2026-08-04T23:16:19.960698+08:00 | 2026-08-05 08:09:30.735528+00
REL-SARM-010 | 单臂冲击测试 | MOD 模块 | P0 |  |  |  |  | 1 | csv-import | 2026-08-04T23:16:19.968508+08:00 | 2026-08-05 08:09:30.735528+00
REL-SLEG-001 | 单腿模块空载连续摆动老化测试 | MOD 模块 | P0 | 单腿刚性测试台架、脚底力传感器、配重/电子负载、自动化动作脚本、温度/电流采集、模拟负载、螺丝扭矩工具、视频记录设备 | 无结构损坏、无过温、无异常噪声、无通信丢包和紧固件松动。 | 无结构损坏、无过温、无异常噪声、无通信丢包和紧固件松动。 |  | 1 | csv-import | 2026-08-04T23:16:19.975651+08:00 | 2026-08-05 08:09:30.735528+00
REL-SLEG-002 | 单腿模块带载连续摆动老化测试 | MOD 模块 | P0 | 单腿刚性测试台架、脚底力传感器、配重/电子负载、自动化动作脚本、温度/电流采集、模拟负载、螺丝扭矩工具、视频记录设备 | 无结构损坏、无过温、无异常噪声、无通信丢包和紧固件松动。 | 无结构损坏、无过温、无异常噪声、无通信丢包和紧固件松动。 |  | 1 | csv-import | 2026-08-04T23:16:19.981791+08:00 | 2026-08-05 08:09:30.735528+00
REL-SLEG-003 | 单腿高温运行测试 | MOD 模块 | P0 |  |  |  |  | 1 | csv-import | 2026-08-04T23:16:19.987943+08:00 | 2026-08-05 08:09:30.735528+00
REL-SLEG-004 | 单腿低温启动测试 | MOD 模块 | P0 |  |  |  |  | 1 | csv-import | 2026-08-04T23:16:19.994708+08:00 | 2026-08-05 08:09:30.735528+00
REL-SLEG-005 | 单腿高低温循环测试 | MOD 模块 | P0 |  |  |  |  | 1 | csv-import | 2026-08-04T23:16:20.000989+08:00 | 2026-08-05 08:09:30.735528+00
REL-SLEG-006 | 单腿湿热测试 | MOD 模块 | P0 |  |  |  |  | 1 | csv-import | 2026-08-04T23:16:20.006700+08:00 | 2026-08-05 08:09:30.735528+00
REL-SLEG-007 | 单腿高温存储后功能复测 | MOD 模块 | P1 |  |  |  |  | 1 | csv-import | 2026-08-04T23:16:20.011512+08:00 | 2026-08-05 08:09:30.735528+00
REL-SLEG-008 | 单腿低温存储后功能复测 | MOD 模块 | P1 |  |  |  |  | 1 | csv-import | 2026-08-04T23:16:20.018171+08:00 | 2026-08-05 08:09:30.735528+00
REL-SLEG-009 | 单腿振动测试 | MOD 模块 | P0 |  |  |  |  | 1 | csv-import | 2026-08-04T23:16:20.024846+08:00 | 2026-08-05 08:09:30.735528+00
REL-SLEG-010 | 单腿冲击测试 | MOD 模块 | P0 |  |  |  |  | 1 | csv-import | 2026-08-04T23:16:20.030699+08:00 | 2026-08-05 08:09:30.735528+00
REL-CHEST-005 | 胸腔高低温循环测试 | MOD 模块 | P0 |  |  |  |  | 1 | csv-import | 2026-08-04T23:16:20.057661+08:00 | 2026-09-11T16:51:24.951687+08:00
REL-UPPER-001 | 上肢模块（腰部+双臂）空载连续摆动老化测试 | MOD 模块 | P0 | 单臂测试支架、可调直流源、自动化动作脚本、温度/电流采集、模拟负载、螺丝扭矩工具、视频记录设备 | 无结构损坏、无过温、无异常噪声、无通信丢包和紧固件松动。 | 无结构损坏、无过温、无异常噪声、无通信丢包和紧固件松动。 |  | 1 | platform-migration | 2026-08-05 08:09:30.735528+00 | 2026-08-05 08:09:30.735528+00
REL-UPPER-002 | 上肢模块（腰部+双臂）带载连续摆动老化测试 | MOD 模块 | P0 | 单臂测试支架、末端模拟负载/砝码、法兰转接板、自动化动作脚本、温度/电流采集、模拟负载、螺丝扭矩工具、视频记录设备 | 无结构损坏、无过温、无异常噪声、无通信丢包和紧固件松动。 | 无结构损坏、无过温、无异常噪声、无通信丢包和紧固件松动。 |  | 1 | platform-migration | 2026-08-05 08:09:30.735528+00 | 2026-08-05 08:09:30.735528+00
REL-UPPER-003 | 上肢高温运行测试 | MOD 模块 | P0 | 高低温试验箱、单臂测试支架、末端模拟负载、法兰转接板、温度传感器、可调直流源、视频记录设备 | 高温下可启动/运行,温升受控,无热保护误触发或不可恢复故障。 | 高温下可启动/运行,温升受控,无热保护误触发或不可恢复故障。 |  | 1 | platform-migration | 2026-08-05 08:09:30.735528+00 | 2026-08-05 08:09:30.735528+00
REL-UPPER-004 | 上肢低温启动测试 | MOD 模块 | P0 | 高低温试验箱、单臂测试支架、末端模拟负载、法兰转接板、温度传感器、可调直流源、视频记录设备 | 低温可启动,动作无严重卡滞,恢复常温后无功能退化。 | 低温可启动,动作无严重卡滞,恢复常温后无功能退化。 |  | 1 | platform-migration | 2026-08-05 08:09:30.735528+00 | 2026-08-05 08:09:30.735528+00
REL-UPPER-005 | 上肢高低温循环测试 | MOD 模块 | P0 | 高低温试验箱、单臂测试支架、末端模拟负载、法兰转接板、温度传感器、可调直流源、视频记录设备 | 无开裂、松动、凝露导致的短路或不可恢复功能异常。 | 无开裂、松动、凝露导致的短路或不可恢复功能异常。 |  | 1 | platform-migration | 2026-08-05 08:09:30.735528+00 | 2026-08-05 08:09:30.735528+00
REL-UPPER-006 | 上肢湿热测试 | MOD 模块 | P0 | 高低温试验箱、单臂测试支架、末端模拟负载、法兰转接板、温湿度记录仪、可调直流源、视频记录设备 | 无进水/凝露导致的短路,无明显腐蚀,功能复测通过。 | 无进水/凝露导致的短路,无明显腐蚀,功能复测通过。 |  | 1 | platform-migration | 2026-08-05 08:09:30.735528+00 | 2026-08-05 08:09:30.735528+00
REL-UPPER-007 | 上肢高温存储后功能复测 | MOD 模块 | P1 |  |  |  |  | 1 | platform-migration | 2026-08-05 08:09:30.735528+00 | 2026-08-05 08:09:30.735528+00
REL-UPPER-008 | 上肢低温存储后功能复测 | MOD 模块 | P1 |  |  |  |  | 1 | platform-migration | 2026-08-05 08:09:30.735528+00 | 2026-08-05 08:09:30.735528+00
REL-UPPER-009 | 上肢振动测试 | MOD 模块 | P0 |  |  |  |  | 1 | platform-migration | 2026-08-05 08:09:30.735528+00 | 2026-08-05 08:09:30.735528+00
REL-UPPER-010 | 上肢冲击测试 | MOD 模块 | P0 |  |  |  |  | 1 | platform-migration | 2026-08-05 08:09:30.735528+00 | 2026-08-05 08:09:30.735528+00
REL-LOWER-001 | 下肢模块（双腿+腰部）空载连续摆动老化测试 | MOD 模块 | P0 | 单腿刚性测试台架、脚底力传感器、配重/电子负载、自动化动作脚本、温度/电流采集、模拟负载、螺丝扭矩工具、视频记录设备 | 无结构损坏、无过温、无异常噪声、无通信丢包和紧固件松动。 | 无结构损坏、无过温、无异常噪声、无通信丢包和紧固件松动。 |  | 1 | platform-migration | 2026-08-05 08:09:30.735528+00 | 2026-08-05 08:09:30.735528+00
REL-LOWER-002 | 下肢模块（双腿+腰部）带载连续摆动老化测试 | MOD 模块 | P0 | 单腿刚性测试台架、脚底力传感器、配重/电子负载、自动化动作脚本、温度/电流采集、模拟负载、螺丝扭矩工具、视频记录设备 | 无结构损坏、无过温、无异常噪声、无通信丢包和紧固件松动。 | 无结构损坏、无过温、无异常噪声、无通信丢包和紧固件松动。 |  | 1 | platform-migration | 2026-08-05 08:09:30.735528+00 | 2026-08-05 08:09:30.735528+00
REL-LOWER-003 | 下肢高温运行测试 | MOD 模块 | P0 |  |  |  |  | 1 | platform-migration | 2026-08-05 08:09:30.735528+00 | 2026-08-05 08:09:30.735528+00
REL-LOWER-004 | 下肢低温启动测试 | MOD 模块 | P0 |  |  |  |  | 1 | platform-migration | 2026-08-05 08:09:30.735528+00 | 2026-08-05 08:09:30.735528+00
REL-LOWER-005 | 下肢高低温循环测试 | MOD 模块 | P0 |  |  |  |  | 1 | platform-migration | 2026-08-05 08:09:30.735528+00 | 2026-08-05 08:09:30.735528+00
REL-LOWER-006 | 下肢湿热测试 | MOD 模块 | P0 |  |  |  |  | 1 | platform-migration | 2026-08-05 08:09:30.735528+00 | 2026-08-05 08:09:30.735528+00
REL-LOWER-007 | 下肢高温存储后功能复测 | MOD 模块 | P1 |  |  |  |  | 1 | platform-migration | 2026-08-05 08:09:30.735528+00 | 2026-08-05 08:09:30.735528+00
REL-LOWER-008 | 下肢低温存储后功能复测 | MOD 模块 | P1 |  |  |  |  | 1 | platform-migration | 2026-08-05 08:09:30.735528+00 | 2026-08-05 08:09:30.735528+00
REL-LOWER-009 | 下肢振动测试 | MOD 模块 | P0 |  |  |  |  | 1 | platform-migration | 2026-08-05 08:09:30.735528+00 | 2026-08-05 08:09:30.735528+00
REL-LOWER-010 | 下肢冲击测试 | MOD 模块 | P0 |  |  |  |  | 1 | platform-migration | 2026-08-05 08:09:30.735528+00 | 2026-08-05 08:09:30.735528+00
REL-CHEST-001 | 胸腔连续摆动老化测试 | MOD 模块 | P0 |  |  |  |  | 1 | csv-import | 2026-08-04T23:16:20.037892+08:00 | 2026-09-11T16:51:24.951687+08:00
REL-CHEST-003 | 胸腔高温运行测试 | MOD 模块 | P0 |  |  |  |  | 1 | csv-import | 2026-08-04T23:16:20.044782+08:00 | 2026-09-11T16:51:24.951687+08:00
REL-CHEST-004 | 胸腔低温启动测试 | MOD 模块 | P0 |  |  |  |  | 1 | csv-import | 2026-08-04T23:16:20.052081+08:00 | 2026-09-11T16:51:24.951687+08:00
REL-CHEST-006 | 胸腔湿热测试 | MOD 模块 | P0 |  |  |  |  | 1 | csv-import | 2026-08-04T23:16:20.063768+08:00 | 2026-09-11T16:51:24.951687+08:00
REL-CHEST-007 | 胸腔高温存储后功能复测 | MOD 模块 | P1 |  |  |  |  | 1 | csv-import | 2026-08-04T23:16:20.070732+08:00 | 2026-09-11T16:51:24.951687+08:00
REL-CHEST-008 | 胸腔低温存储后功能复测 | MOD 模块 | P1 |  |  |  |  | 1 | csv-import | 2026-08-04T23:16:20.076589+08:00 | 2026-09-11T16:51:24.951687+08:00
REL-CHEST-009 | 胸腔振动测试 | MOD 模块 | P0 |  |  |  |  | 1 | csv-import | 2026-08-04T23:16:20.084775+08:00 | 2026-09-11T16:51:24.951687+08:00
REL-CHEST-010 | 胸腔冲击测试 | MOD 模块 | P0 |  |  |  |  | 1 | csv-import | 2026-08-04T23:16:20.090818+08:00 | 2026-09-11T16:51:24.951687+08:00
