Roboparty/RP1_test/hardware/mechanical/腿部/腿部负载测试平台/cad/solidworks/LS97腿部工装装配体.SLDASM

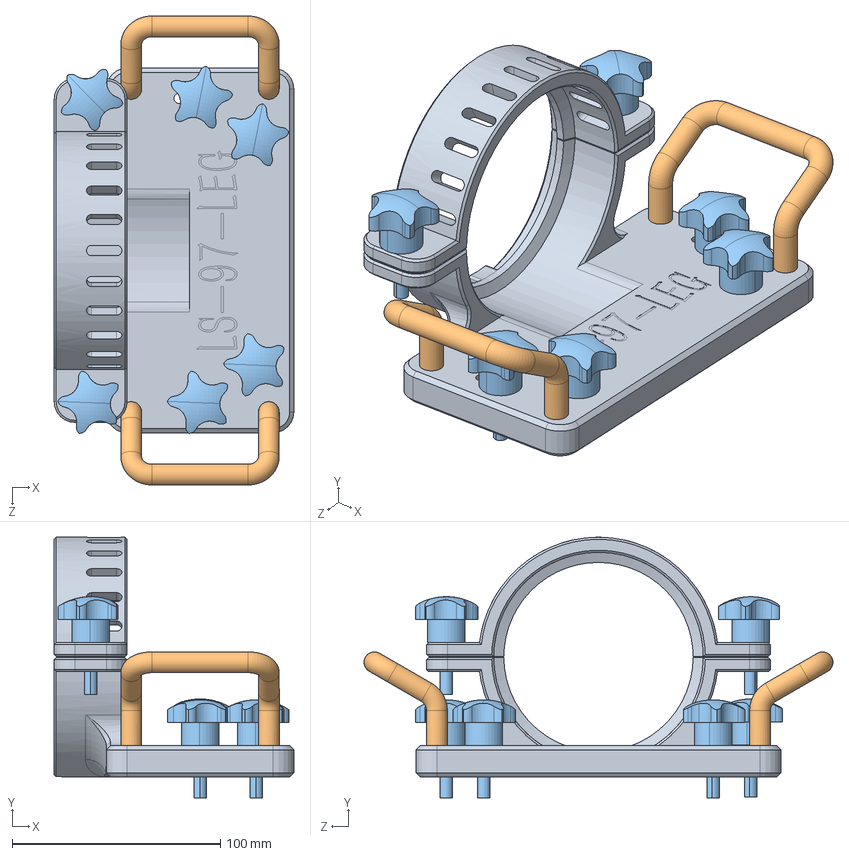
[picture p23: CAD file, 2026-10-06]
hardware/mechanical/腿部/腿部负载测试平台/cad/solidworks/LS97腿部工装装配体.SLDASM
115.0 x 125.0 x 225.0 mm
RB000365 LS97腿部工装
把手C-NUHFNS66 x 2
E-LHAT12-M6-D25-L25 x 6
