Roboparty/RP1_test/hardware/mechanical/手臂胸腔/共用资料/cad/solidworks/框架装配体.SLDASM

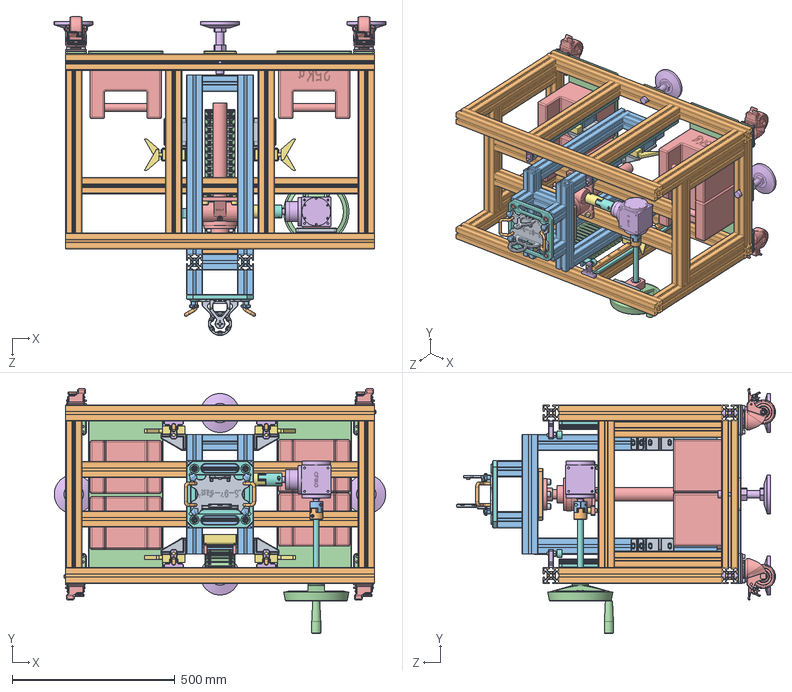
[picture p24: CAD file, 2026-10-06]
hardware/mechanical/手臂胸腔/共用资料/cad/solidworks/框架装配体.SLDASM
1020.0 x 754.0 x 981.5 mm
内六角圆柱头螺钉 M8x12 x 16
内六角圆柱头螺钉 M6x8 x 32
内六角圆柱头螺钉 M6x15 x 16
内六角圆柱头螺钉 M3x30 x 4
内六角圆柱头螺钉 M12x16 x 4
内六角圆柱头螺钉 M5x12 x 6
内六角圆柱头螺钉 M12x20 x 4
内六角圆柱头螺钉 M6x12 x 4
内六角圆柱头螺钉 M12x25 x 4
RB000406 型材主框架
RB000407 型材升降架
RB000408 脚轮安装板 x 4
E-CLHS75-N x 4
E-LWAD32-D120-M24-L200 x 4
RB000409 脚杯安装板 x 4
RB000416 直线导轨安装板 x 4
RB000418 滑块连接 x 4
GUIDE_C-ELG25-500 x 4
SLIDER_C-ELG25-500 x 4
PART_C-ELG25-500 x 4
SWL2.5-1AⅡ-250-CZ
HD090-(CD)(1)
BODY-L_E-LMPJC40L55-16-18
BODY-R_E-LMPJC40L55-16-18
NEZI-L_E-LMPJC40L55-16-18
NEZI-R_E-LMPJC40L55-16-18
BODY1_E-LMPJC40L55-16-18
双辐条型标准握柄手轮[CTH302A-200]
E-BHF56-6004DD-h50-001
E-BHF56-6004DD-h50-003 x 2
E-BHF56-6004DD-h50-002
RB000419 轴1
RB000420 轴承座安装板
BODY-L_E-LMPJC40L55-18-18
BODY-R_E-LMPJC40L55-18-18
NEZI-L_E-LMPJC40L55-18-18
NEZI-R_E-LMPJC40L55-18-18
BODY1_E-LMPJC40L55-18-18
EGH25钳制器 x 4
RB000421 工装底板
RB000422 钳制器连接块 x 4
RB000423 丝杆顶升板
VBW11-2280-R35-N30-VEW11-005
VBW11-2280-R35-N30-VEW11-003 x 37
VBW11-2280-R35-N30-VEW11-001
VBW11-2280-R35-N30-VEW11-007 x 2
RB000424 拖链钣金
RB000425 拖链钣金2
RB000426 LS-97-Waist工装
把手C-NUHFNS66 x 2
E-LHAT12-M5-D25-L20 x 4
RB000427 型材底板 x 2
25Kg砝码 x 4
RB000428 缓冲器安装座 x 4
NEZI_C-UNCH10-30 x 4
CUP_C-UNCH10-30 x 4
NAT_C-UNCH10-30 x 4
