Roboparty/RP1_test/hardware/mechanical/腿部/腿部负载测试平台/cad/solidworks/J-WJG12-1425.SLDASM

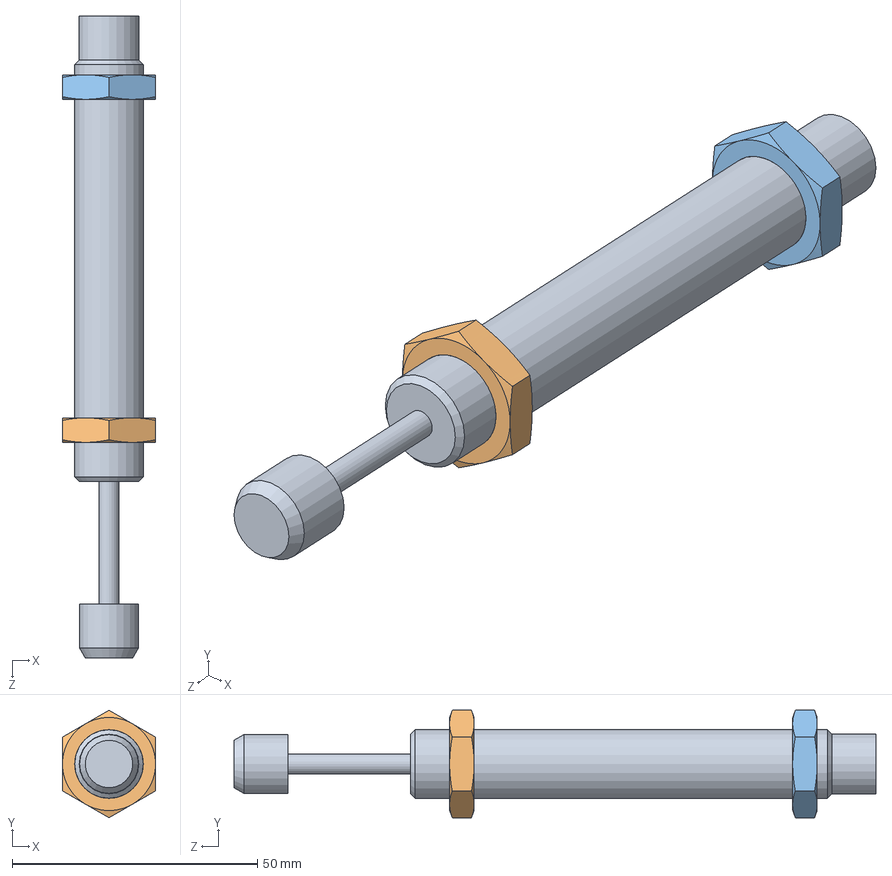
[picture p25: CAD file, 2026-10-06]
hardware/mechanical/腿部/腿部负载测试平台/cad/solidworks/J-WJG12-1425.SLDASM
19.0 x 21.9 x 131.0 mm
J-WJG12-1425-001
J-WJG12-1425-002
J-WJG12-1425-003
