Roboparty/RP1_test/hardware/mechanical/腿部/腿部负载测试平台/cad/solidworks/C-HLGW30-1400（左）.SLDASM

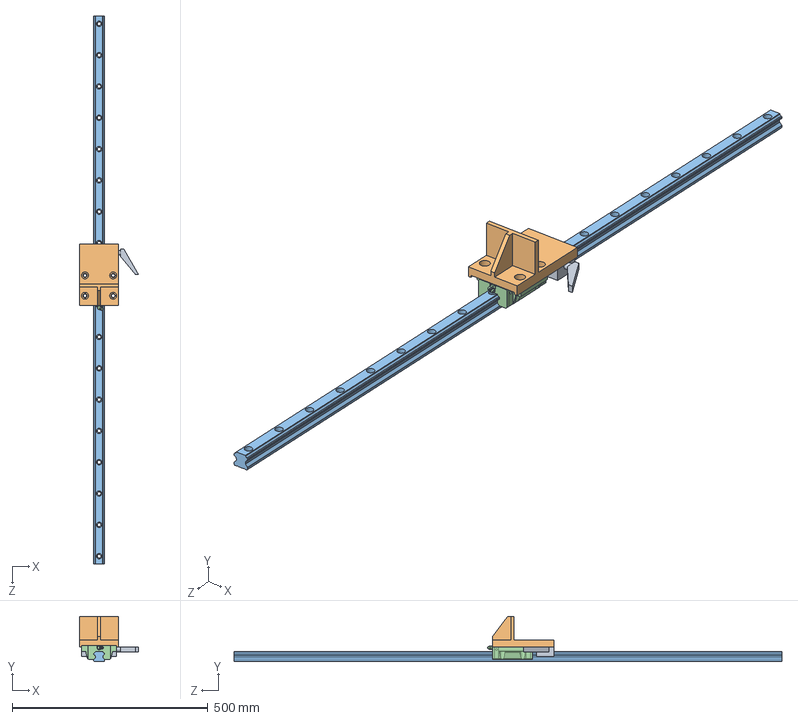
[picture p26: CAD file, 2026-10-06]
hardware/mechanical/腿部/腿部负载测试平台/cad/solidworks/C-HLGW30-1400（左）.SLDASM
150.5 x 116.0 x 1400.0 mm
HGW30钳制器
滑块安装板
C-HLGW30-1400_r
C-HLGWB30
