Roboparty/RP1_test/hardware/mechanical/腿部/腿部负载测试平台/cad/solidworks/大腿下装配体-测试.SLDASM

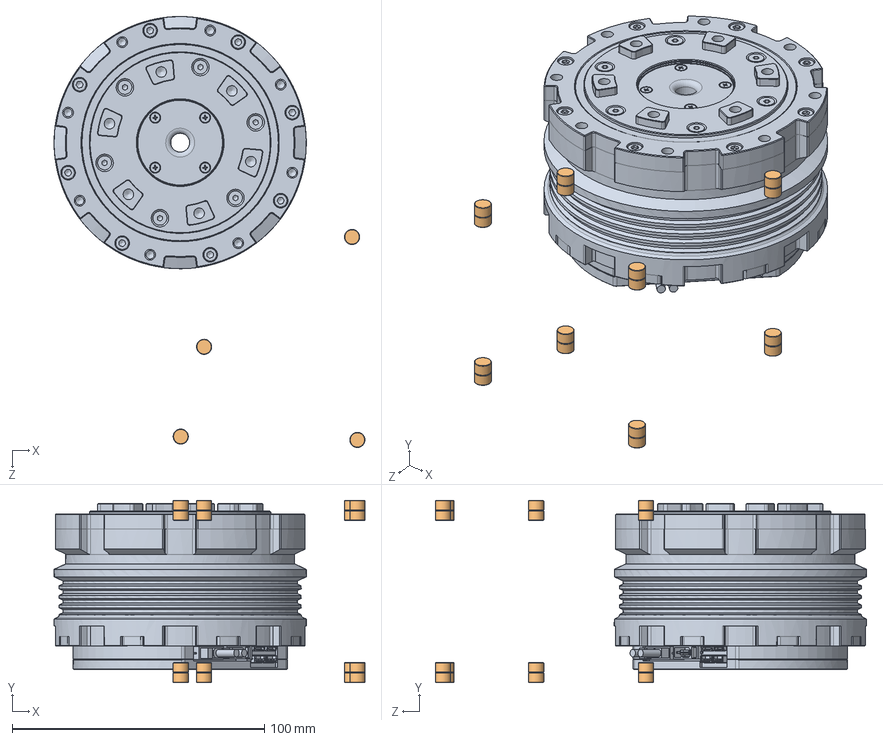
[picture p28: CAD file, 2026-10-06]
hardware/mechanical/腿部/腿部负载测试平台/cad/solidworks/大腿下装配体-测试.SLDASM
123.2 x 72.3 x 170.8 mm
钕磁铁-测试 x 16
PJ3-97-8-测试
