Roboparty/RP1_test/hardware/mechanical/腿部/腿部负载测试平台/cad/solidworks/VBW21-2850-R55-N70-VEW21.SLDASM

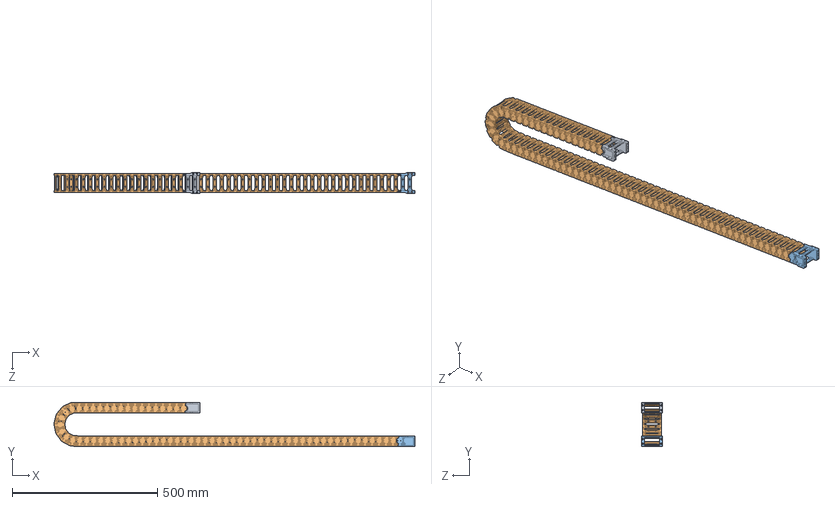
[picture p29: CAD file, 2026-10-06]
hardware/mechanical/腿部/腿部负载测试平台/cad/solidworks/VBW21-2850-R55-N70-VEW21.SLDASM
1244.3 x 153.2 x 74.0 mm
VBW21-2850-R55-N70-VEW21-005
VBW21-2850-R55-N70-VEW21-003 x 69
VBW21-2850-R55-N70-VEW21-001
VBW21-2850-R55-N70-VEW21-007 x 2
