Roboparty/RP1_test/hardware/mechanical/腿部/腿部负载测试平台/cad/solidworks/上框架装配体.SLDASM

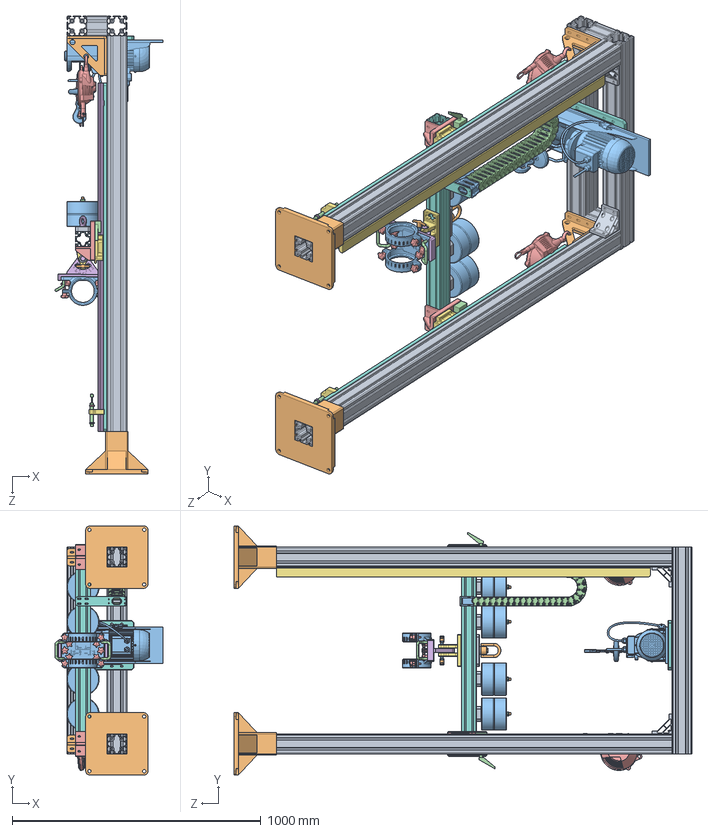
[picture p30: CAD file, 2026-10-06]
hardware/mechanical/腿部/腿部负载测试平台/cad/solidworks/上框架装配体.SLDASM
434.8 x 1000.0 x 1840.0 mm
型材架
AFT15-TY-80260 x 2
电动葫芦
HGW30钳制器 x 2
滑块安装板 x 2
C-HLGW30-1400_r x 2
C-HLGWB30 x 2
直线导轨安装板 x 2
BRACKET_LBLUS8080B-70 x 2
型材钣金支架 x 2
RB000365 LS97腿部工装 x 2
把手C-NUHFNS66 x 4
E-LHAT12-M6-D25-L25 x 12
旋转主板1
旋转主板2
60型材
吊环板
TCC16-0_7T
VBW21-2850-R55-N70-VEW21-005
VBW21-2850-R55-N70-VEW21-003 x 69
VBW21-2850-R55-N70-VEW21-001
VBW21-2850-R55-N70-VEW21-007 x 2
拖链槽
拖链钣金
交叉滚子轴承RBH208UUCC0P4 x 2
ZAU40-M12-d6-S9-001 x 2
ZAU40-12-6-9-002 x 2
J-WJG12-1425-001 x 2
J-WJG12-1425-002 x 2
J-WJG12-1425-003 x 2
缓冲器安装座 x 2
电动葫芦安装板
砝码座 x 6
M10螺杆 x 4
圆饼砝码5KG x 8
六角螺母 M10 x 4
平衡器 x 2
TBF07-M10 x 2
