Roboparty/RP1_test/hardware/mechanical/腿部/腿部负载测试平台/cad/solidworks/腿部老化测试平台总装.SLDASM

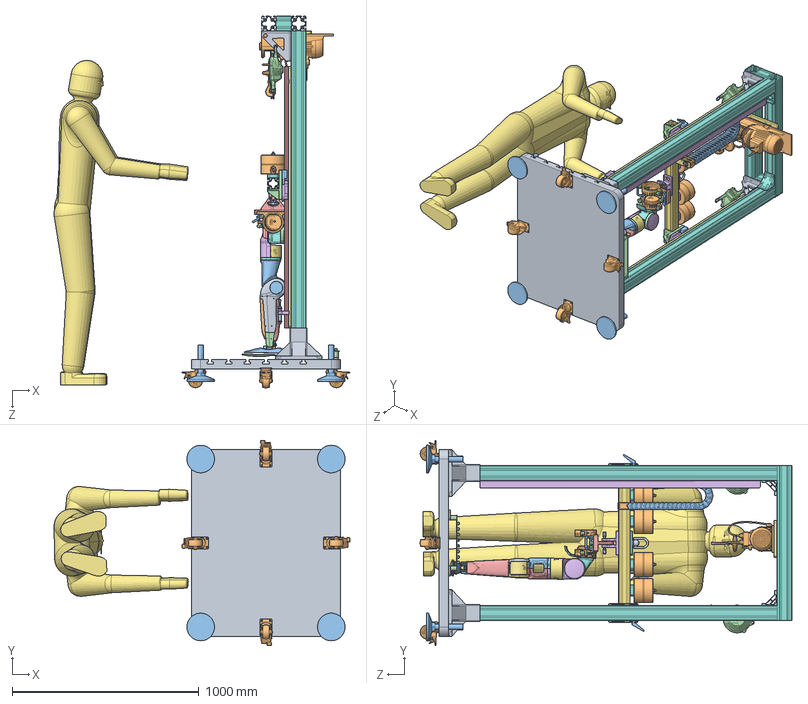
[picture p31: CAD file, 2026-10-06]
hardware/mechanical/腿部/腿部负载测试平台/cad/solidworks/腿部老化测试平台总装.SLDASM
1586.5 x 1100.5 x 1991.5 mm
RB000377 铁平台
E-CLHS75-N x 4
E-LWAD32-D148-M30-L200 x 4
接地铜排
接地铜排支架 x 2
RB000272 脚底十字轴-测试
RB000273 脚底固定一号-测试
RB000274 脚底固定二号-测试
铜轴套2-测试
铜轴套3-测试
RB000276 脚面-测试
RB000277 鞋垫-测试
RB000245 大腿橡胶垫-测试
RB000246 大腿本体-测试
RB000247 大腿抱箍-测试
RB000248 Roll限位-测试
RB000249 Yaw限位3-测试
RB000250 压线块1-测试
钕磁铁4×4-测试 x 6
RB000251 大腿下本体右-测试
RB000252 大腿卡箍右-测试
RB000253 大腿下电机抱箍-测试
RB000254 大腿卡箍左-测试
RB000255 大腿下盖板左-测试
RB000256 大腿下盖板右-测试
RB000257 大腿下本体左-测试
RB000259 Yaw限位4-测试
钕磁铁-测试 x 16
RB000292 膝盖轴承座-测试
RB000260 小腿电机分离块-测试
RB000261 小腿本体右-测试
RB000262 小腿本体左-测试
RB000263 小腿前盖板-测试
RB000264 小腿盖板-测试
RB000265 小腿脚踝分离块-测试
RB000266 小腿后盖板-测试
RB000267 脚踝输出法兰-测试 x 2
RB000268 长连杆-测试
球轴承GE8C-测试 x 4
RB000269 短连杆-测试
圆柱销 5×45-测试
铜轴套（65）-测试 x 2
两面带密封圈（接触式）的深沟球轴承[60000-2RS]61804-2RS]_0224-测试
RB000270 小腿压线块2-测试
孔用钢丝挡圈16-测试 x 2
RB000231_02_髋关节左（LS版）
RB000239_01_髋关节左抱箍
PJ3-97-8 x 2
RB000234_02_髋关节限位环（LS版）
RB000237_02_髋关节电机盖板
M_CAP_V1.0
RB000290_01_髋关节橡胶盖板
假人
型材架
AFT15-TY-80260 x 2
电动葫芦
HGW30钳制器 x 2
滑块安装板 x 2
C-HLGW30-1400_r x 2
C-HLGWB30 x 2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
