Roboparty/RP1_test/hardware/mechanical/腿部/腿部负载测试平台/cad/solidworks/下平台装配体.SLDASM

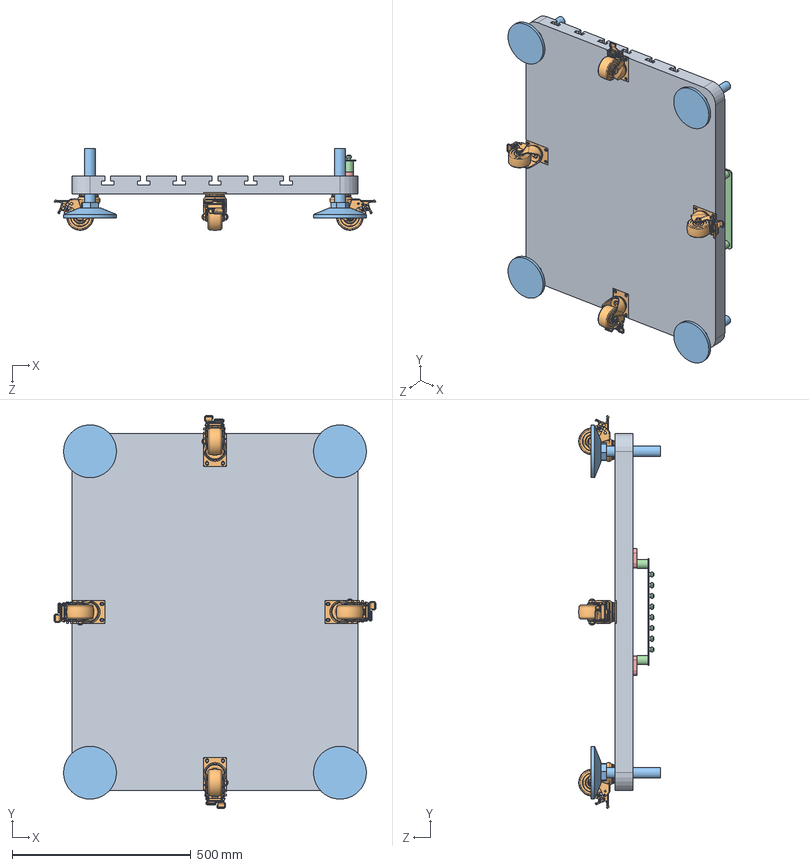
[picture p32: CAD file, 2026-10-06]
hardware/mechanical/腿部/腿部负载测试平台/cad/solidworks/下平台装配体.SLDASM
900.5 x 1100.5 x 228.5 mm
RB000377 铁平台
E-CLHS75-N x 4
E-LWAD32-D148-M30-L200 x 4
接地铜排
接地铜排支架 x 2
