Roboparty/RP1_test/hardware/mechanical/腿部/腿部负载测试平台/cad/solidworks/LBLUS8080B-70.SLDASM

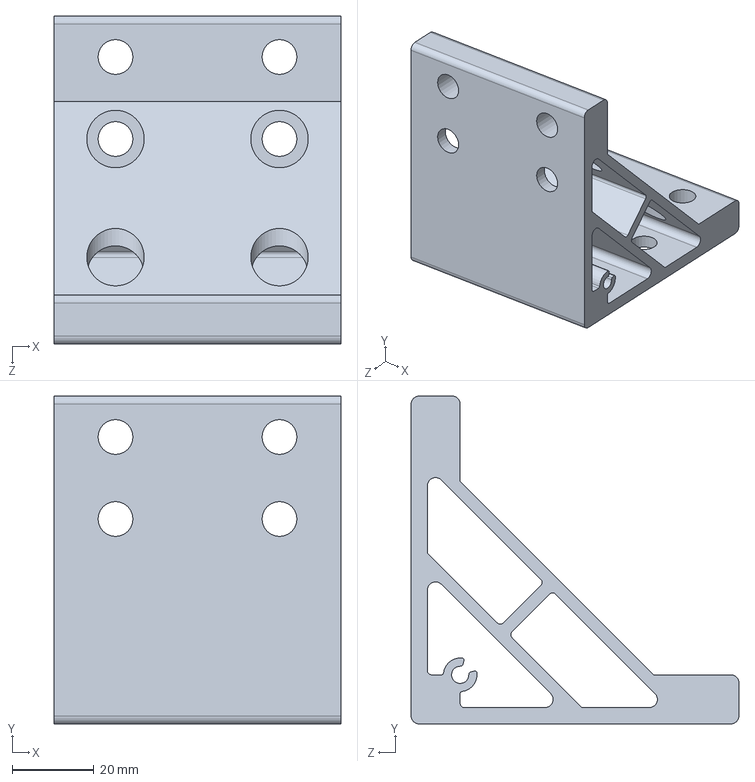
[picture p33: CAD file, 2026-10-06]
hardware/mechanical/腿部/腿部负载测试平台/cad/solidworks/LBLUS8080B-70.SLDASM
70.0 x 80.0 x 80.0 mm
