Roboparty/RP1_test/hardware/mechanical/手臂胸腔/共用资料/cad/solidworks/磁铁（长方形）.SLDPRT

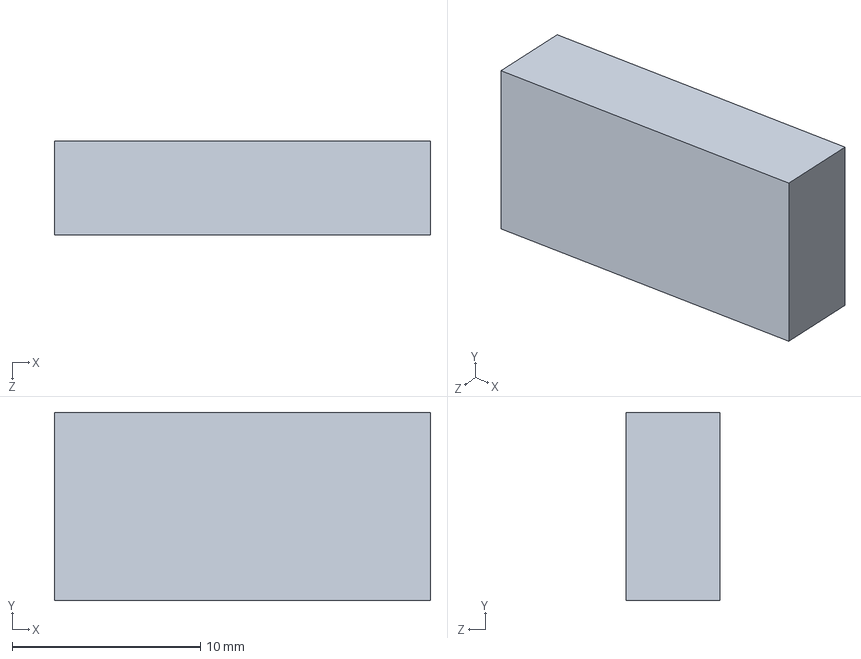
[picture p34: CAD file, 2026-10-06]
hardware/mechanical/手臂胸腔/共用资料/cad/solidworks/磁铁（长方形）.SLDPRT
20.0 x 10.0 x 5.00 mm
