Roboparty/RP1_test/hardware/mechanical/手臂胸腔/共用资料/manufacturing/cnc/YCL.M000426 LS-97-Waist工装.STEP

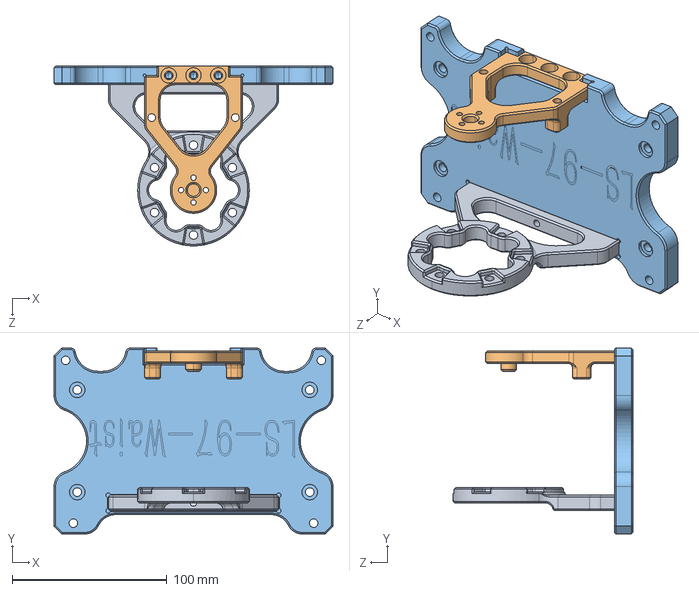
[picture p35: CAD file, 2026-10-06]
hardware/mechanical/手臂胸腔/共用资料/manufacturing/cnc/YCL.M000426 LS-97-Waist工装.STEP
180.0 x 120.0 x 116.0 mm
