Roboparty/RP1_test/hardware/mechanical/手臂胸腔/共用资料/manufacturing/profiles/YCL.M000691 80立柱.STEP

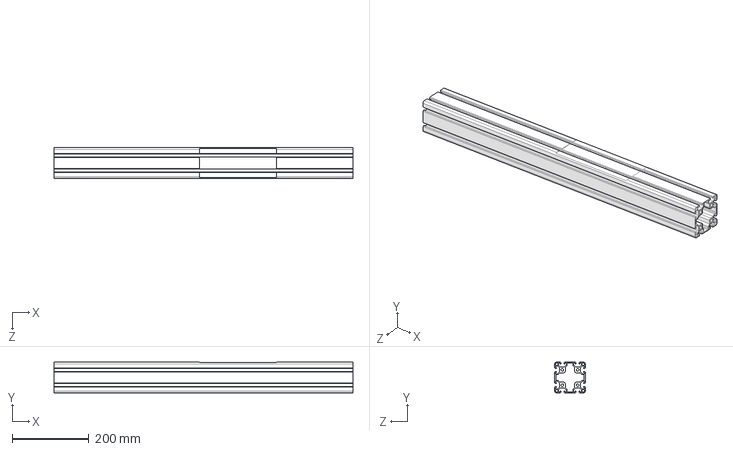
[picture p36: CAD file, 2026-10-06]
hardware/mechanical/手臂胸腔/共用资料/manufacturing/profiles/YCL.M000691 80立柱.STEP
780.0 x 80.0 x 80.0 mm
