Roboparty/RP1_test/hardware/mechanical/手臂胸腔/共用资料/manufacturing/sheet-metal/YCL.M000694 LOGO板.STEP

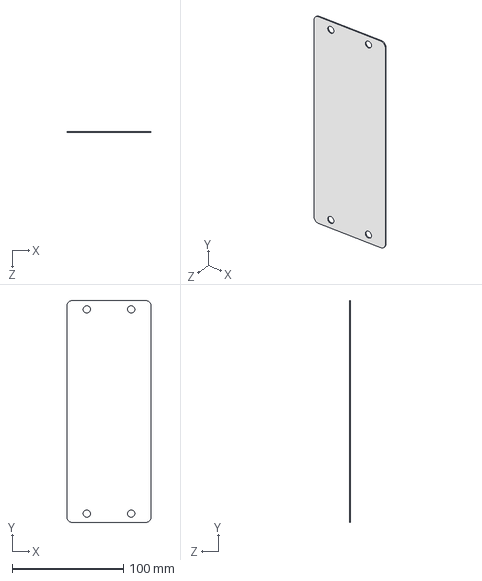
[picture p37: CAD file, 2026-10-06]
hardware/mechanical/手臂胸腔/共用资料/manufacturing/sheet-metal/YCL.M000694 LOGO板.STEP
76.0 x 200.0 x 1.00 mm
