Roboparty/RP1_test/hardware/mechanical/手臂胸腔/手臂测试平台/图纸/YCL.M000438 LS75手臂工装.STEP

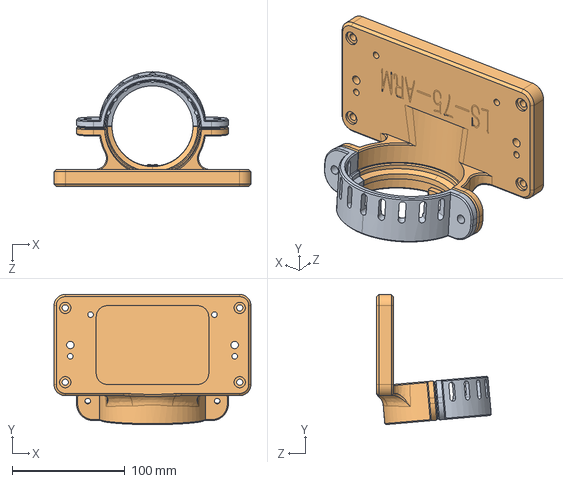
[picture p38: CAD file, 2026-10-06]
hardware/mechanical/手臂胸腔/手臂测试平台/图纸/YCL.M000438 LS75手臂工装.STEP
175.0 x 115.7 x 101.8 mm
