Roboparty/RP1_test/hardware/mechanical/手臂胸腔/胸腔测试平台/图纸/YCL.M000700 航插安装板（胸腔）.STEP

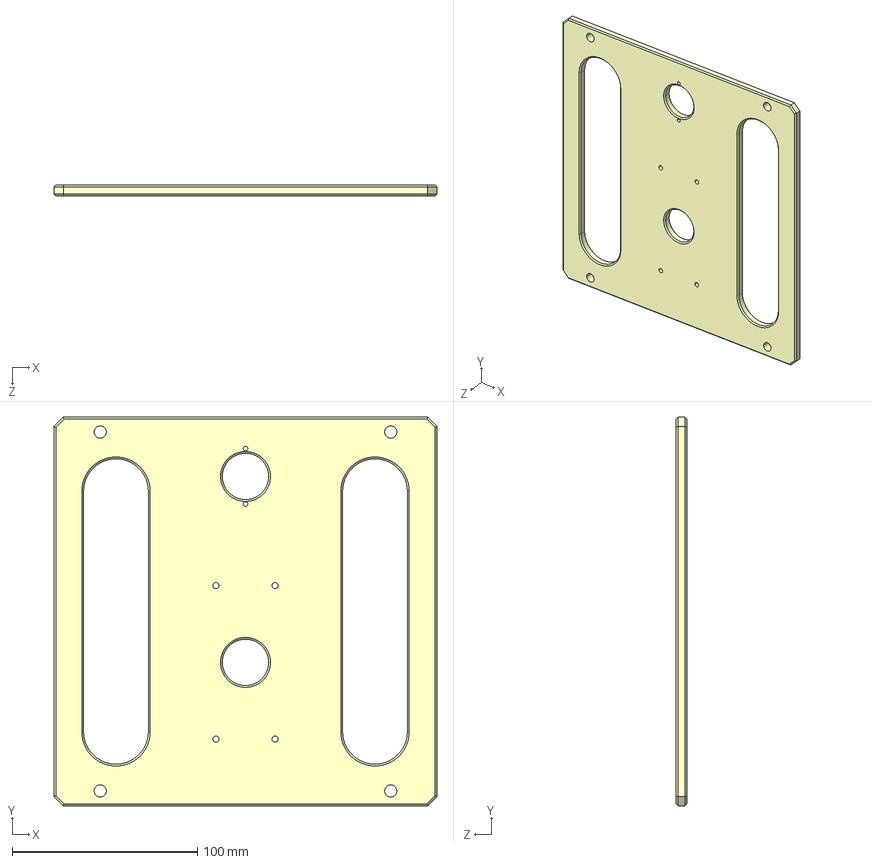
[picture p39: CAD file, 2026-10-06]
hardware/mechanical/手臂胸腔/胸腔测试平台/图纸/YCL.M000700 航插安装板（胸腔）.STEP
207.0 x 210.0 x 6.00 mm
