Roboparty/RP1_test/hardware/mechanical/手臂胸腔/共用资料/cad/solidworks/YCL.M000698 接线盒安装板.SLDPRT

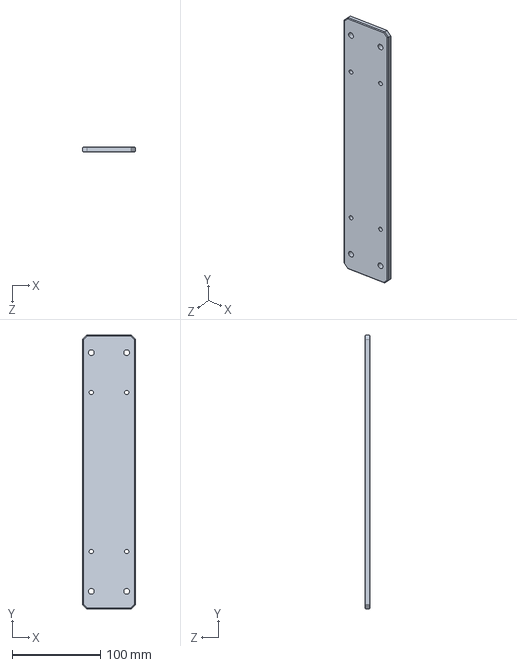
[picture p40: CAD file, 2026-10-06]
hardware/mechanical/手臂胸腔/共用资料/cad/solidworks/YCL.M000698 接线盒安装板.SLDPRT
60.0 x 310.0 x 6.00 mm
