Roboparty/RP1_test/hardware/mechanical/手臂胸腔/共用资料/manufacturing/cnc/YCL.M000421 工装底板.STEP

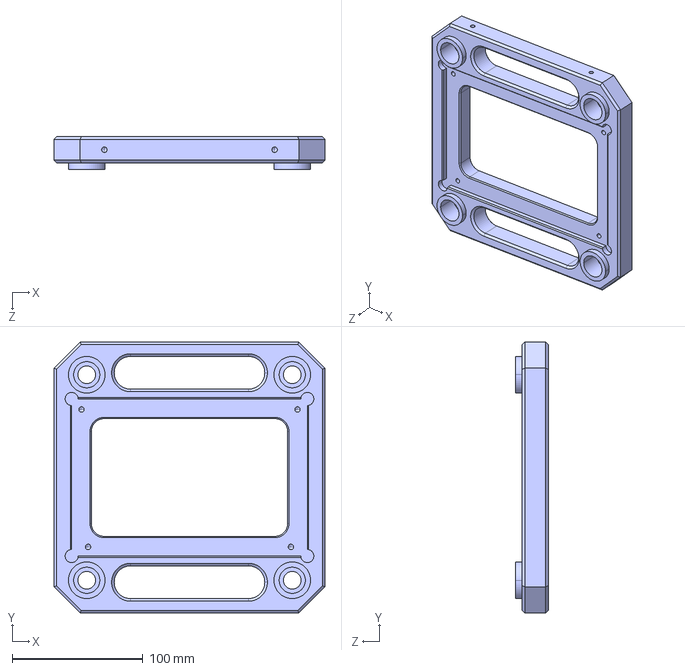
[picture p41: CAD file, 2026-10-06]
hardware/mechanical/手臂胸腔/共用资料/manufacturing/cnc/YCL.M000421 工装底板.STEP
207.0 x 207.0 x 25.0 mm
