Roboparty/RP1_test/hardware/mechanical/手臂胸腔/共用资料/manufacturing/profiles/YCL.M000689 测试底座支架.STEP

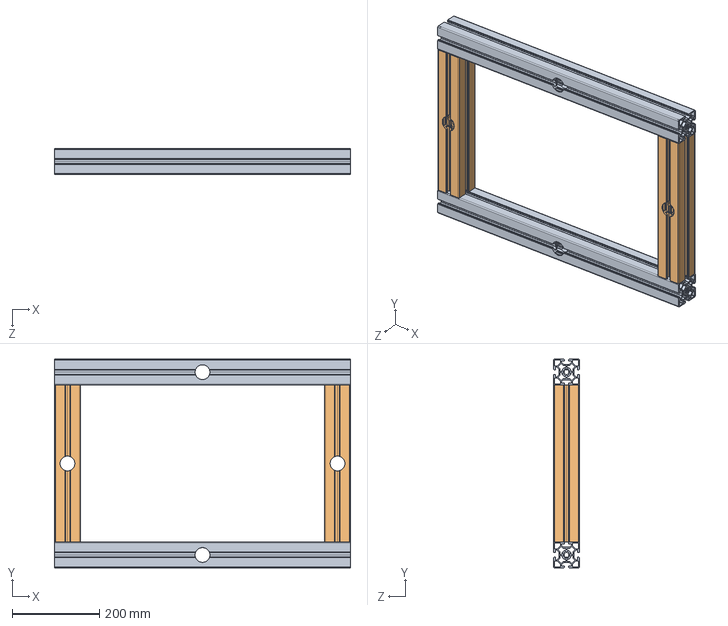
[picture p42: CAD file, 2026-10-06]
hardware/mechanical/手臂胸腔/共用资料/manufacturing/profiles/YCL.M000689 测试底座支架.STEP
680.0 x 480.0 x 60.0 mm
