Roboparty/RP1_test/hardware/mechanical/手臂胸腔/共用资料/manufacturing/sheet-metal/YCL.M000692 支架L件.STEP

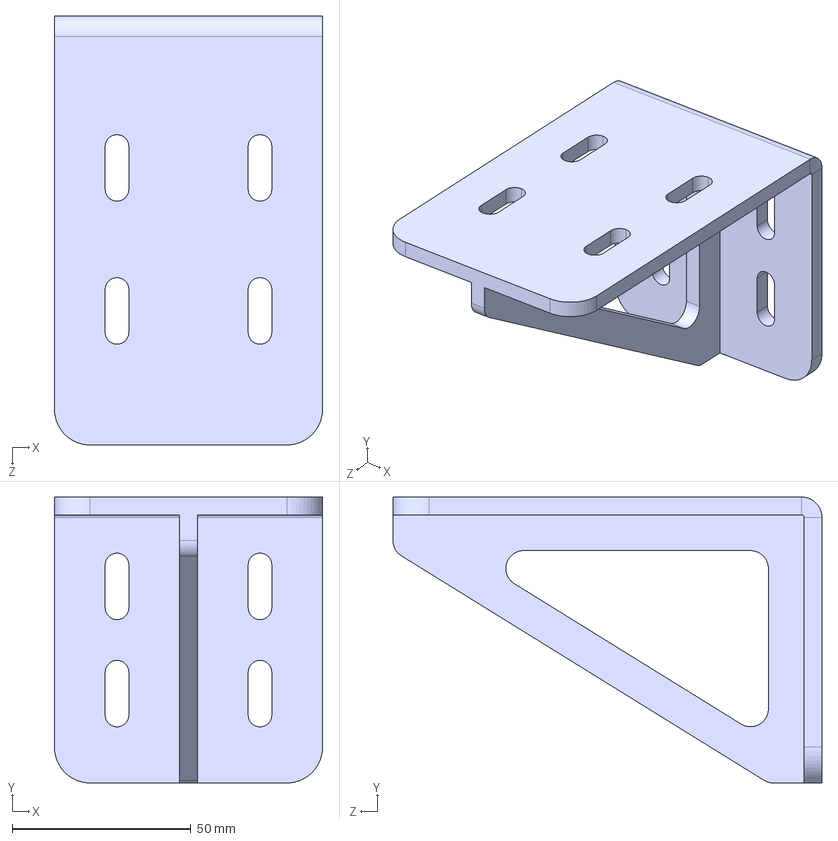
[picture p43: CAD file, 2026-10-06]
hardware/mechanical/手臂胸腔/共用资料/manufacturing/sheet-metal/YCL.M000692 支架L件.STEP
75.0 x 80.0 x 120.0 mm
