Roboparty/RP1_test/hardware/mechanical/手臂胸腔/胸腔测试平台/图纸/YCL.M000697 胸腔底板.STEP

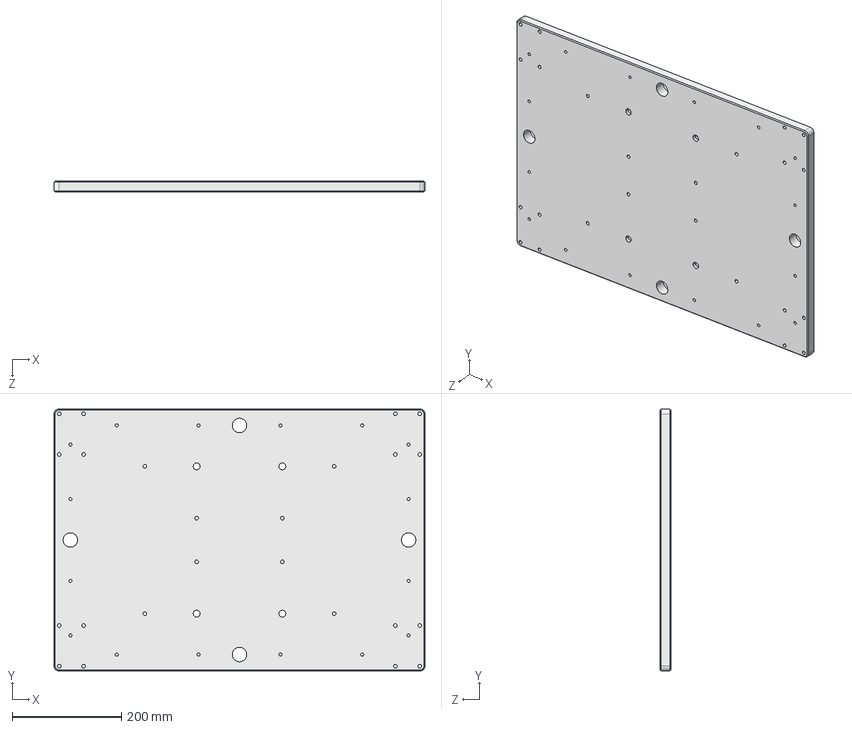
[picture p44: CAD file, 2026-10-06]
hardware/mechanical/手臂胸腔/胸腔测试平台/图纸/YCL.M000697 胸腔底板.STEP
680.0 x 480.0 x 20.0 mm
