Roboparty/RP1_test/hardware/mechanical/手臂胸腔/共用资料/cad/solidworks/YCL.M000426 LS-97-Waist工装.SLDPRT

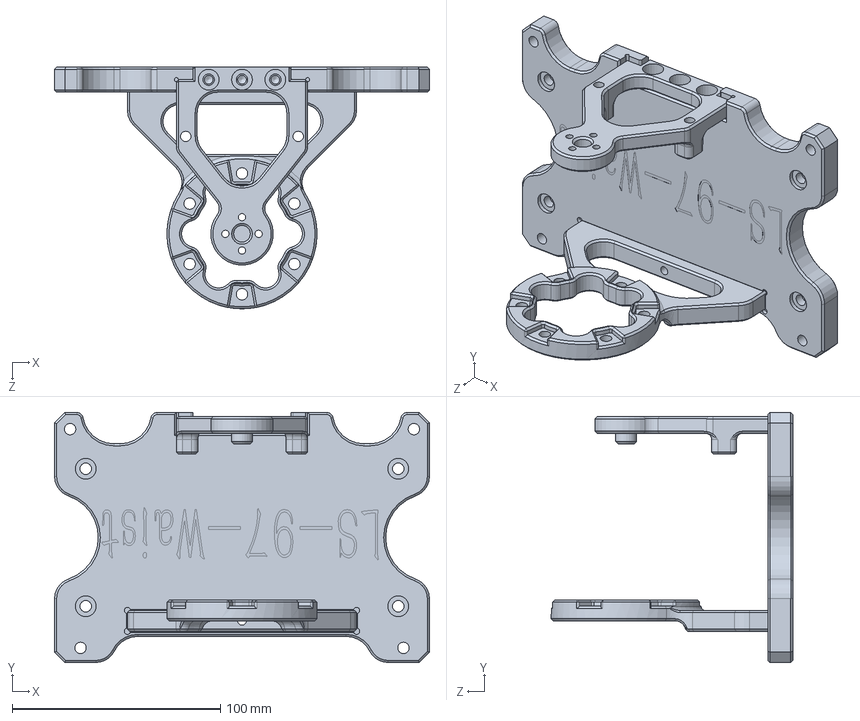
[picture p46: CAD file, 2026-10-06]
hardware/mechanical/手臂胸腔/共用资料/cad/solidworks/YCL.M000426 LS-97-Waist工装.SLDPRT
180.0 x 120.0 x 116.0 mm
