Roboparty/RP1_test/hardware/mechanical/手臂胸腔/共用资料/manufacturing/cnc/YCL.M000693 上工装.STEP

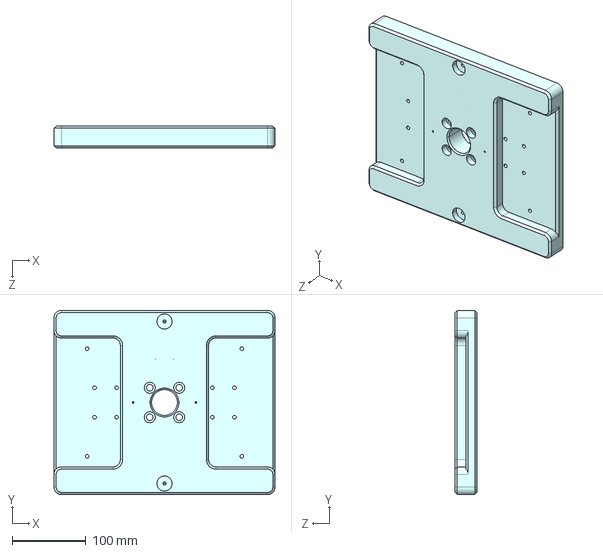
[picture p47: CAD file, 2026-10-06]
hardware/mechanical/手臂胸腔/共用资料/manufacturing/cnc/YCL.M000693 上工装.STEP
300.0 x 250.0 x 30.0 mm
