Roboparty/RP1_test/hardware/mechanical/手臂胸腔/共用资料/manufacturing/sheet-metal/YCL.M000701 罩壳.STEP

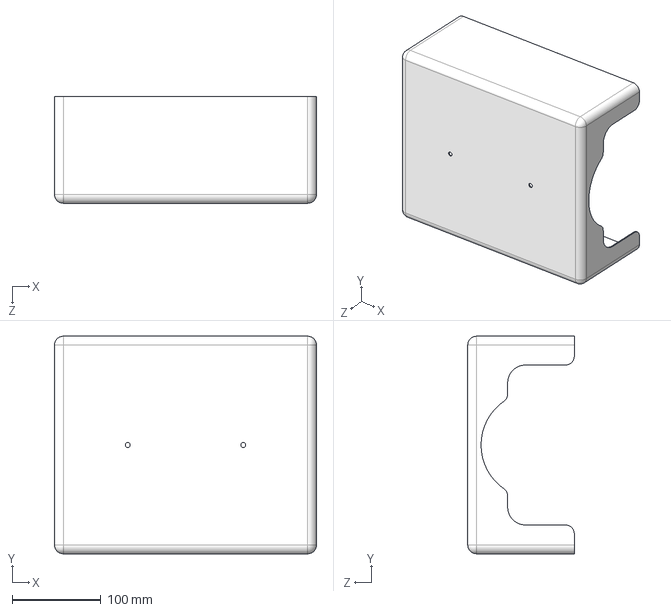
[picture p48: CAD file, 2026-10-06]
hardware/mechanical/手臂胸腔/共用资料/manufacturing/sheet-metal/YCL.M000701 罩壳.STEP
295.0 x 245.0 x 120.0 mm
