Roboparty/RP1_test/hardware/mechanical/手臂胸腔/胸腔测试平台/图纸/YCL.M000699 LOGO板（胸腔）.STEP

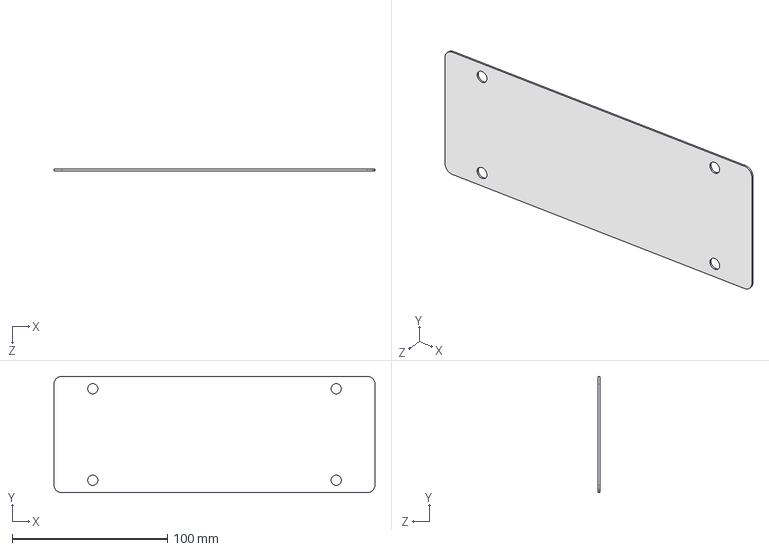
[picture p49: CAD file, 2026-10-06]
hardware/mechanical/手臂胸腔/胸腔测试平台/图纸/YCL.M000699 LOGO板（胸腔）.STEP
207.0 x 75.0 x 1.00 mm
