Roboparty/RP1_test/hardware/mechanical/腿部/腿部负载测试平台/cad/solidworks/C-HLGWB30.sldprt

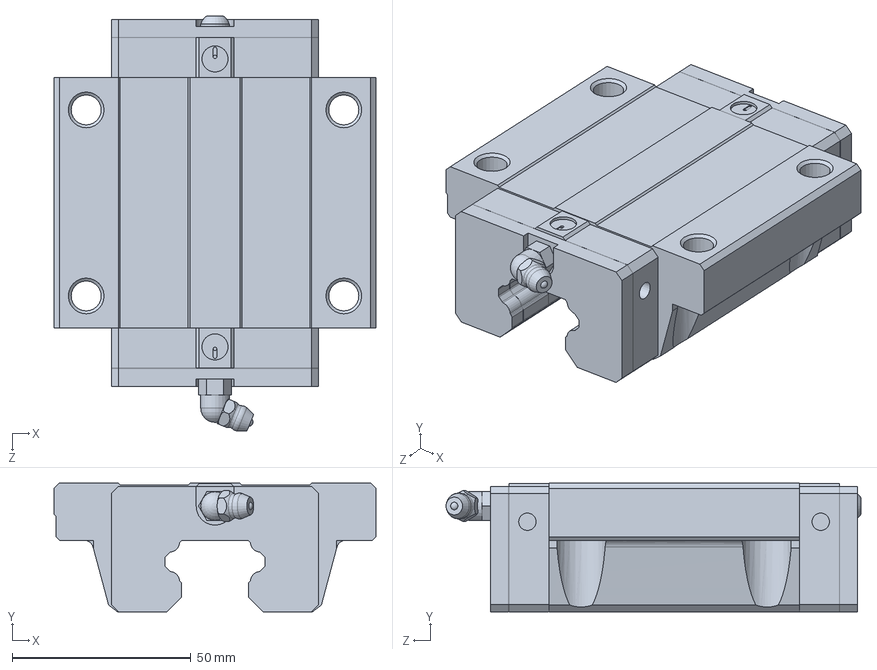
[picture p50: CAD file, 2026-10-06]
hardware/mechanical/腿部/腿部负载测试平台/cad/solidworks/C-HLGWB30.sldprt
90.0 x 36.0 x 116.0 mm
