Roboparty/RP1_test/hardware/mechanical/手臂胸腔/共用资料/cad/solidworks/C-HTB100-N_214.SLDPRT

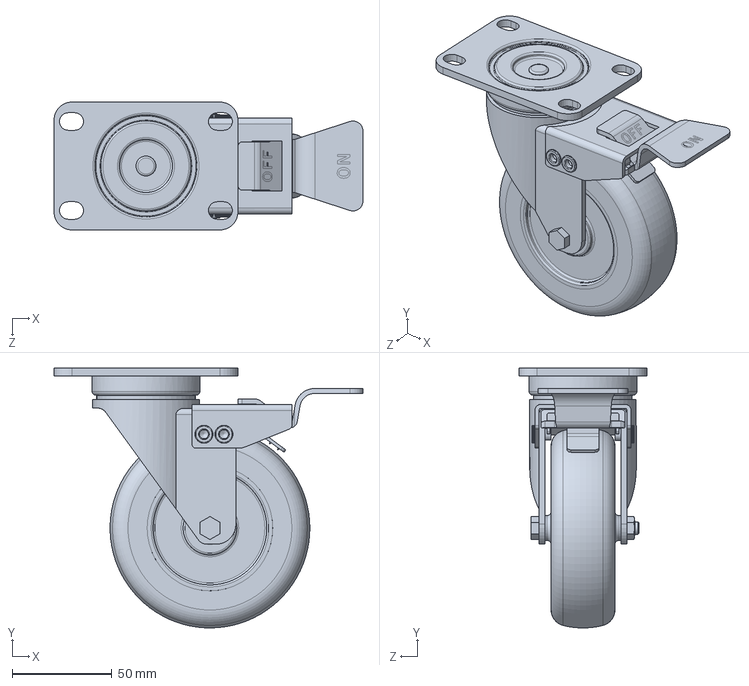
[picture p51: CAD file, 2026-10-06]
hardware/mechanical/手臂胸腔/共用资料/cad/solidworks/C-HTB100-N_214.SLDPRT
154.5 x 130.0 x 64.0 mm
