Roboparty/RP1_test/hardware/mechanical/手臂胸腔/共用资料/manufacturing/cnc/YCL.M000695 航插安装板.STEP

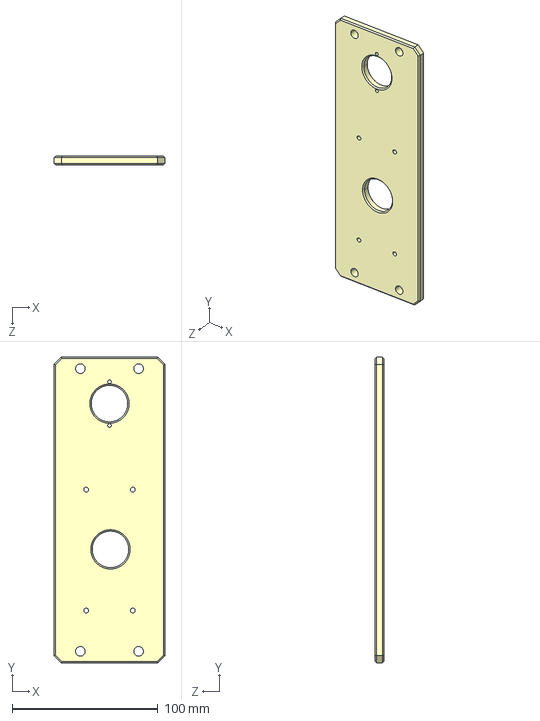
[picture p52: CAD file, 2026-10-06]
hardware/mechanical/手臂胸腔/共用资料/manufacturing/cnc/YCL.M000695 航插安装板.STEP
76.0 x 210.0 x 6.00 mm
