Roboparty/RP1_test/hardware/mechanical/手臂胸腔/胸腔测试平台/图纸/YCL.M000696 胸腔立柱.STEP

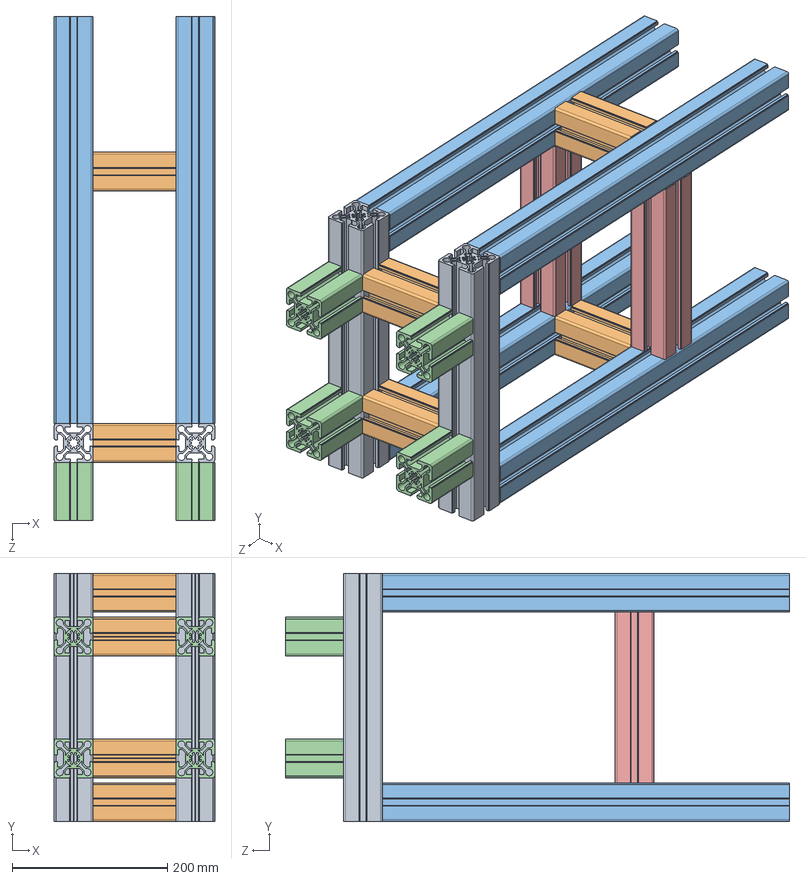
[picture p53: CAD file, 2026-10-06]
hardware/mechanical/手臂胸腔/胸腔测试平台/图纸/YCL.M000696 胸腔立柱.STEP
207.0 x 320.0 x 650.0 mm
