Roboparty/RP1_test/hardware/mechanical/手臂胸腔/共用资料/cad/solidworks/YCL.M000438 LS75手臂工装.SLDPRT

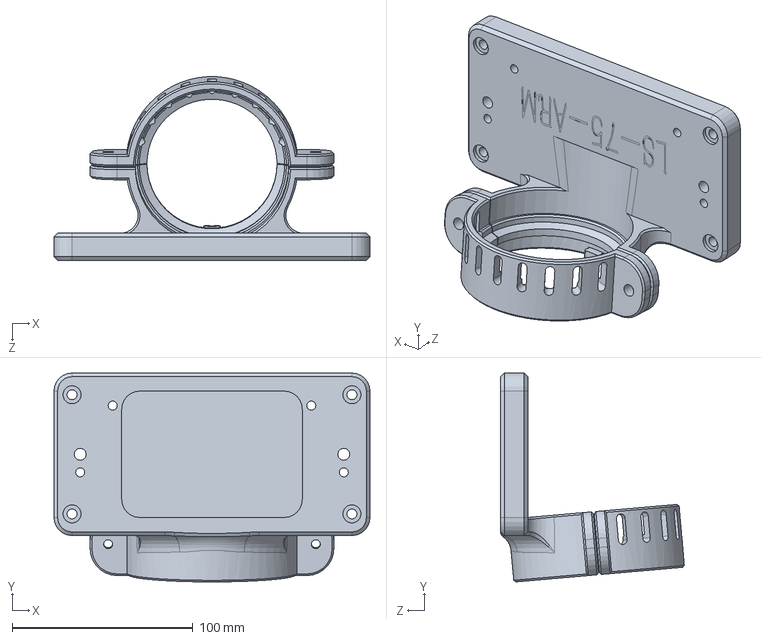
[picture p54: CAD file, 2026-10-06]
hardware/mechanical/手臂胸腔/共用资料/cad/solidworks/YCL.M000438 LS75手臂工装.SLDPRT
175.0 x 115.7 x 101.7 mm
