Roboparty/RP1_test/hardware/mechanical/手臂胸腔/共用资料/manufacturing/cnc/YCL.M000365 LS97腿部工装.STEP

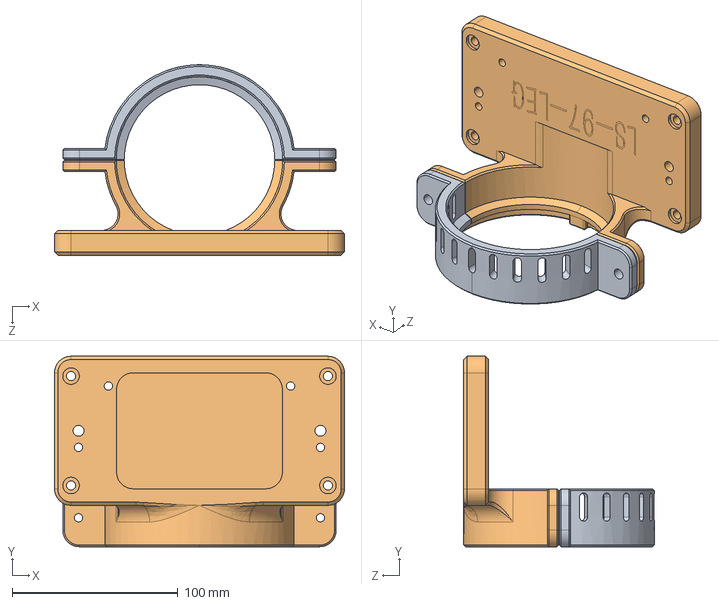
[picture p55: CAD file, 2026-10-06]
hardware/mechanical/手臂胸腔/共用资料/manufacturing/cnc/YCL.M000365 LS97腿部工装.STEP
175.0 x 115.0 x 115.0 mm
