Roboparty/RP1_test/hardware/mechanical/腿部/腿部负载测试平台/cad/solidworks/两面带密封圈（接触式）的深沟球轴承[60000-2RS]61804-2RS]_0224-测试.SLDPRT

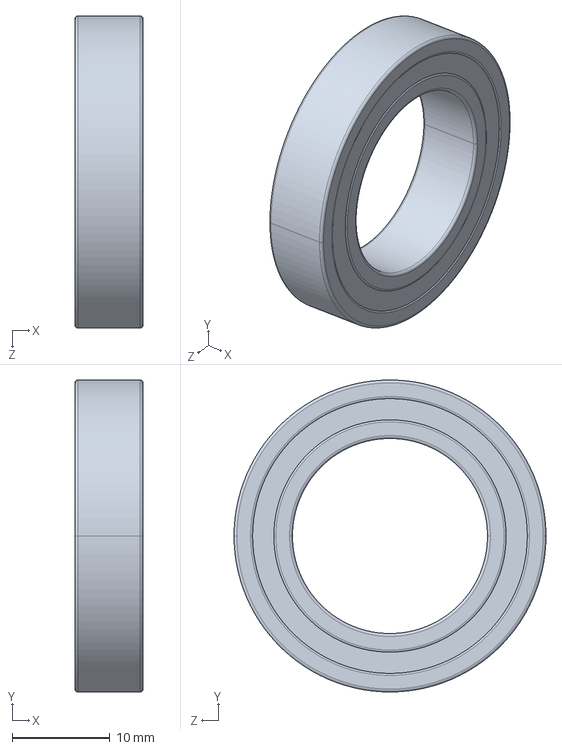
[picture p56: CAD file, 2026-10-06]
hardware/mechanical/腿部/腿部负载测试平台/cad/solidworks/两面带密封圈（接触式）的深沟球轴承[60000-2RS]61804-2RS]_0224-测试.SLDPRT
7.00 x 32.0 x 32.0 mm
