Roboparty/RP1_test/hardware/mechanical/手臂胸腔/共用资料/manufacturing/cnc/YCL.M000690 手腿底板.STEP

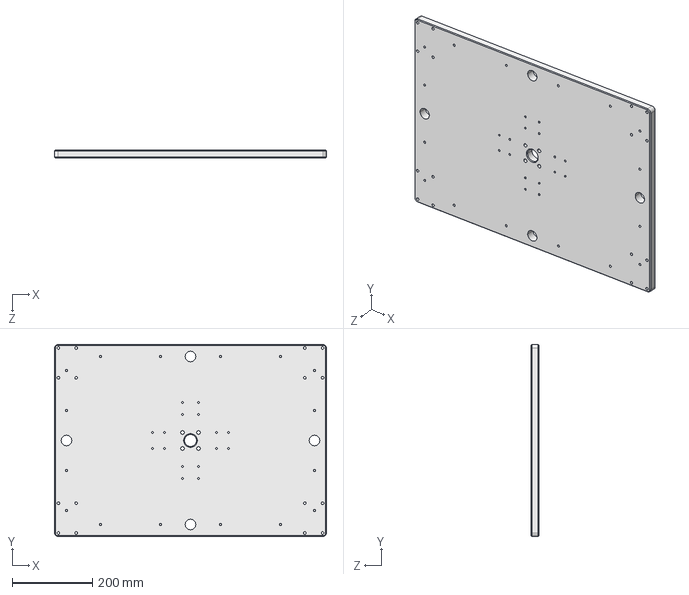
[picture p57: CAD file, 2026-10-06]
hardware/mechanical/手臂胸腔/共用资料/manufacturing/cnc/YCL.M000690 手腿底板.STEP
680.0 x 480.0 x 20.0 mm
