Roboparty/RP1_test/hardware/mechanical/手臂胸腔/共用资料/cad/solidworks/顶出上壳.SLDPRT

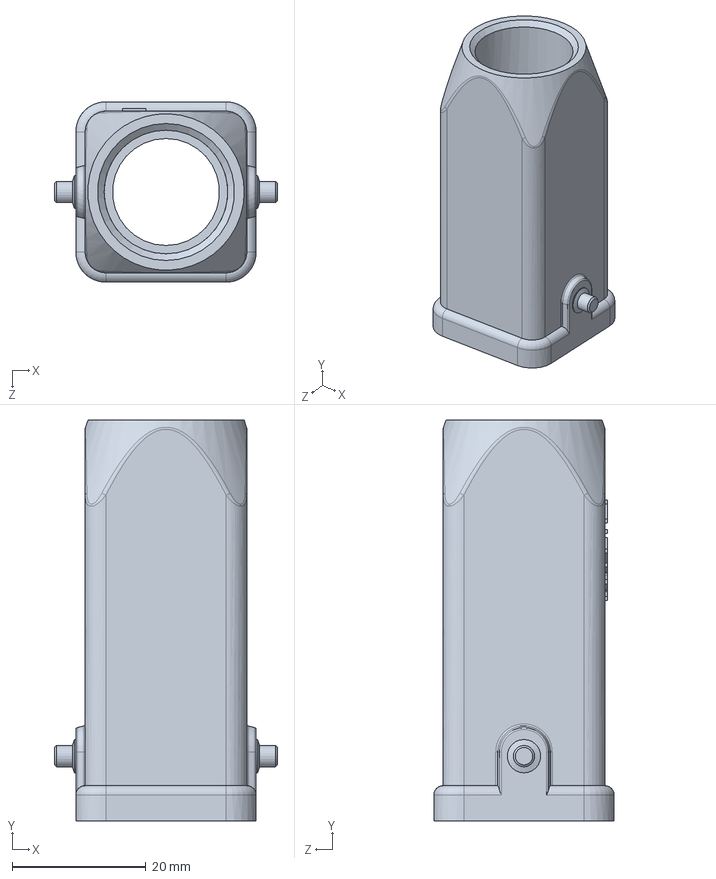
[picture p59: CAD file, 2026-10-06]
hardware/mechanical/手臂胸腔/共用资料/cad/solidworks/顶出上壳.SLDPRT
33.4 x 60.0 x 27.0 mm
