Roboparty/RP1_test/hardware/mechanical/腿部/腿部负载测试平台/cad/solidworks/吊环板.SLDPRT

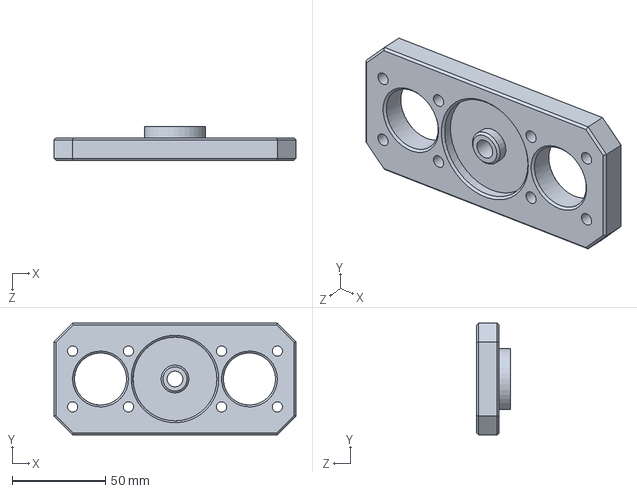
[picture p60: CAD file, 2026-10-06]
hardware/mechanical/腿部/腿部负载测试平台/cad/solidworks/吊环板.SLDPRT
130.0 x 60.0 x 18.0 mm
