Roboparty/RP1_test/hardware/mechanical/手臂胸腔/共用资料/cad/solidworks/25Kg砝码.SLDPRT

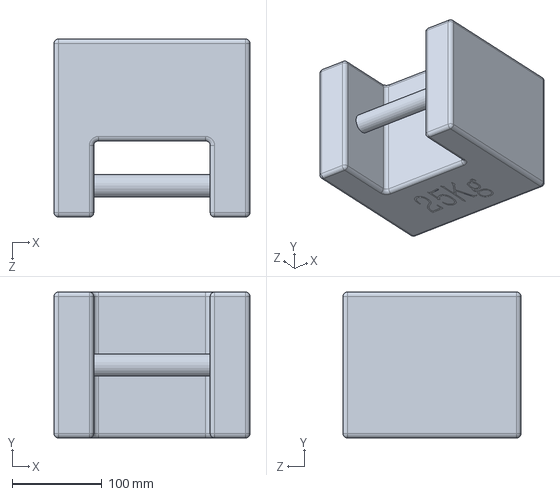
[picture p61: CAD file, 2026-10-06]
hardware/mechanical/手臂胸腔/共用资料/cad/solidworks/25Kg砝码.SLDPRT
219.0 x 163.0 x 199.0 mm
