Roboparty/RP1_test/hardware/mechanical/腿部/腿部负载测试平台/cad/solidworks/圆饼砝码5KG.SLDPRT

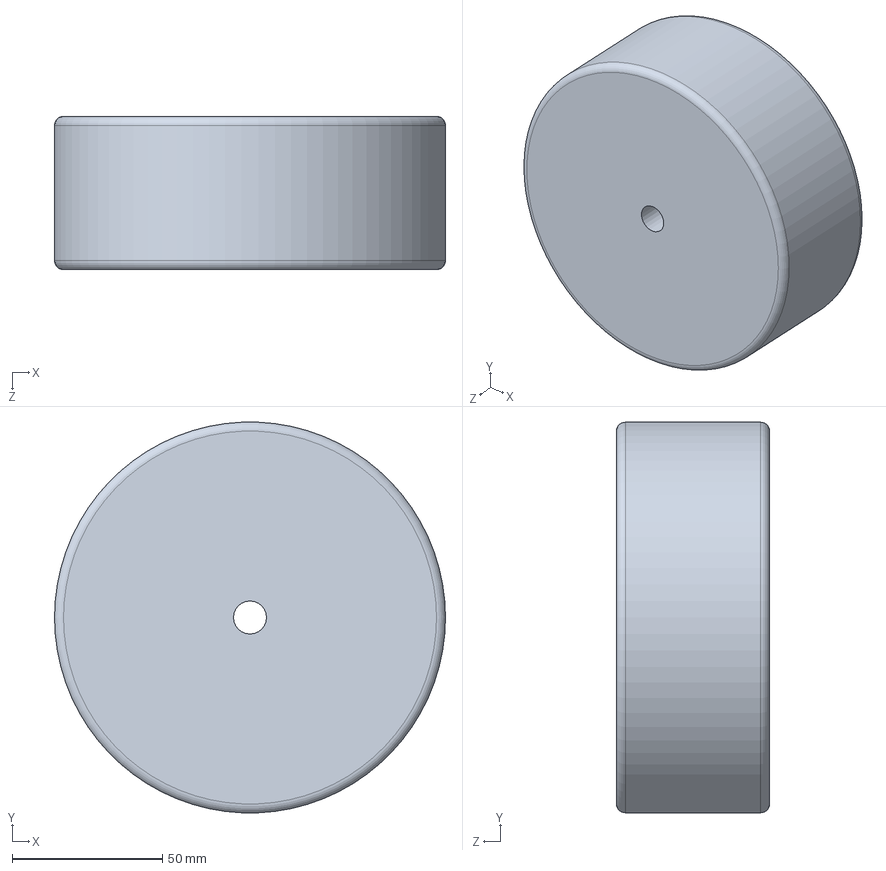
[picture p62: CAD file, 2026-10-06]
hardware/mechanical/腿部/腿部负载测试平台/cad/solidworks/圆饼砝码5KG.SLDPRT
130.0 x 129.9 x 51.0 mm
