Roboparty/RP1_test/hardware/mechanical/手臂胸腔/共用资料/cad/solidworks/E-LHAT12-M6-D25-L25.SLDPRT

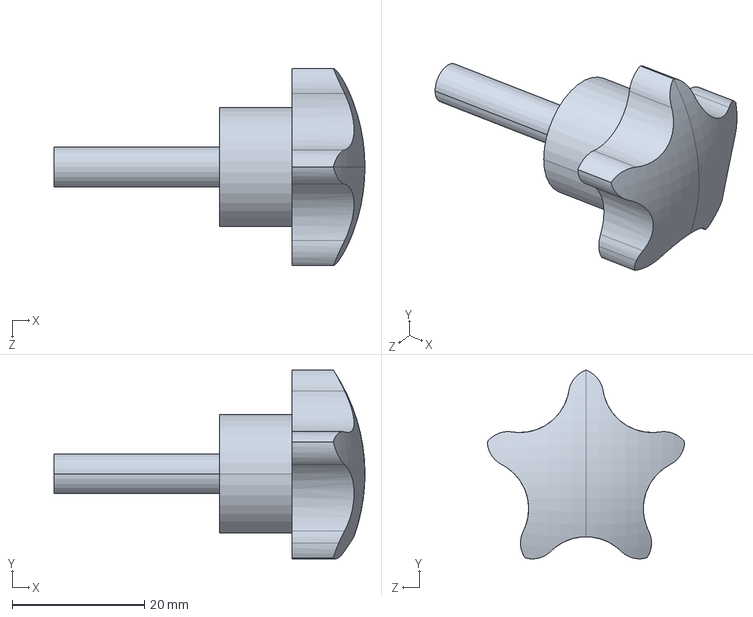
[picture p63: CAD file, 2026-10-06]
hardware/mechanical/手臂胸腔/共用资料/cad/solidworks/E-LHAT12-M6-D25-L25.SLDPRT
47.0 x 28.5 x 29.8 mm
