Roboparty/RP1_test/hardware/mechanical/腿部/腿部负载测试平台/cad/solidworks/拖链钣金.SLDPRT

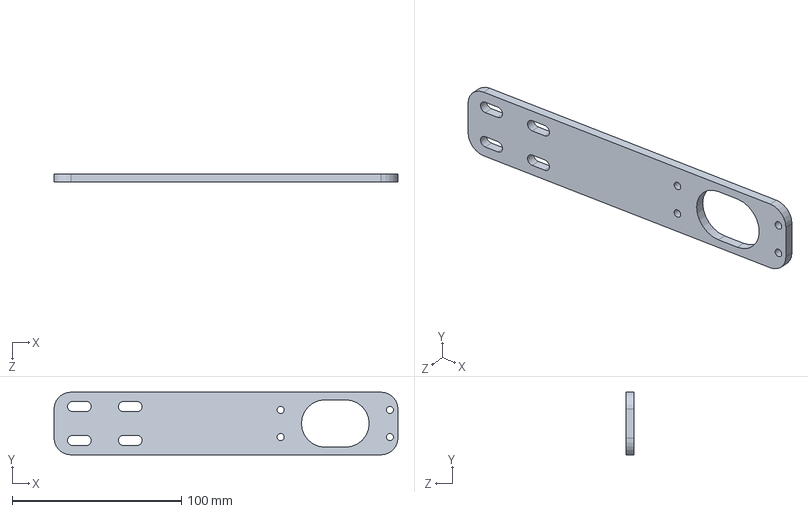
[picture p64: CAD file, 2026-10-06]
hardware/mechanical/腿部/腿部负载测试平台/cad/solidworks/拖链钣金.SLDPRT
203.0 x 37.0 x 5.00 mm
