Roboparty/RP1_test/hardware/mechanical/手臂胸腔/共用资料/cad/solidworks/磁铁（圆）.SLDPRT

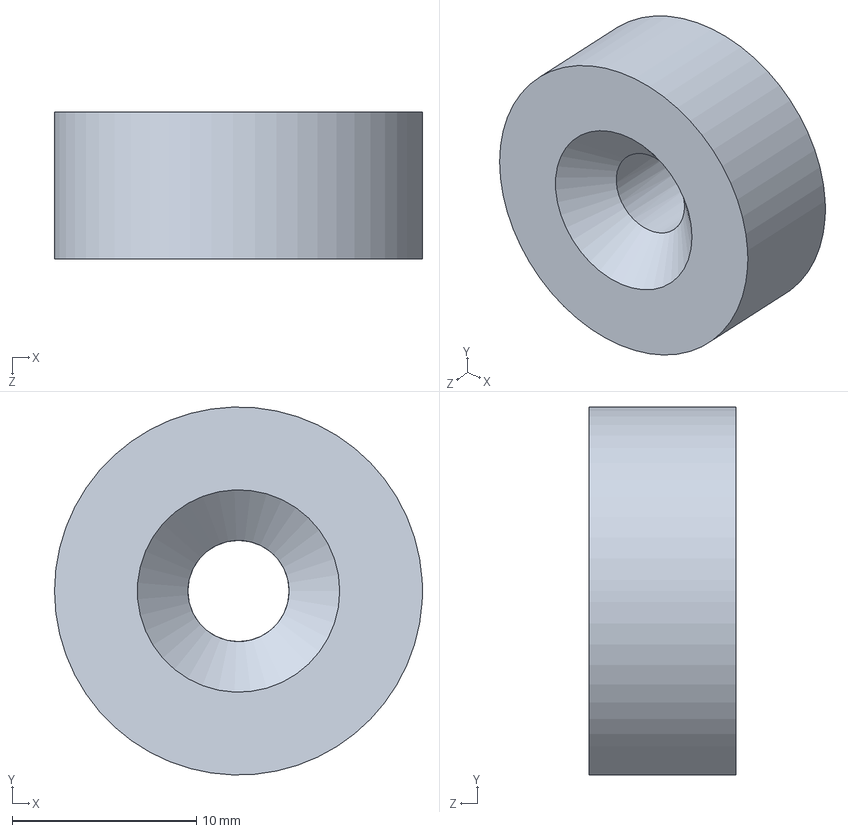
[picture p66: CAD file, 2026-10-06]
hardware/mechanical/手臂胸腔/共用资料/cad/solidworks/磁铁（圆）.SLDPRT
20.0 x 20.0 x 8.00 mm
