Roboparty/RP1_test/hardware/mechanical/手臂胸腔/共用资料/cad/solidworks/ABC03-5010-80B-40_001.sldprt

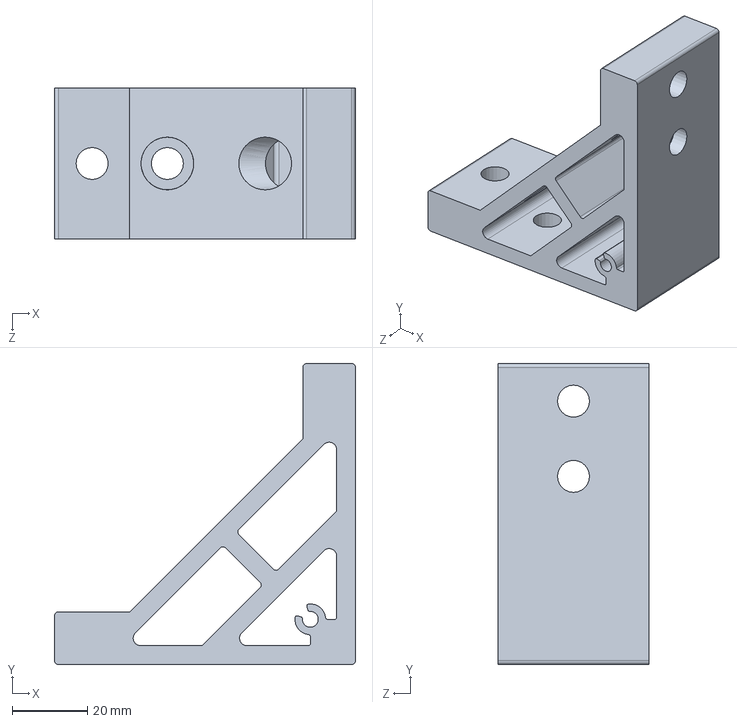
[picture p67: CAD file, 2026-10-06]
hardware/mechanical/手臂胸腔/共用资料/cad/solidworks/ABC03-5010-80B-40_001.sldprt
80.0 x 80.0 x 40.0 mm
