Roboparty/RP1_test/hardware/mechanical/腿部/腿部负载测试平台/cad/solidworks/交叉滚子轴承RBH208UUCC0P4.SLDPRT

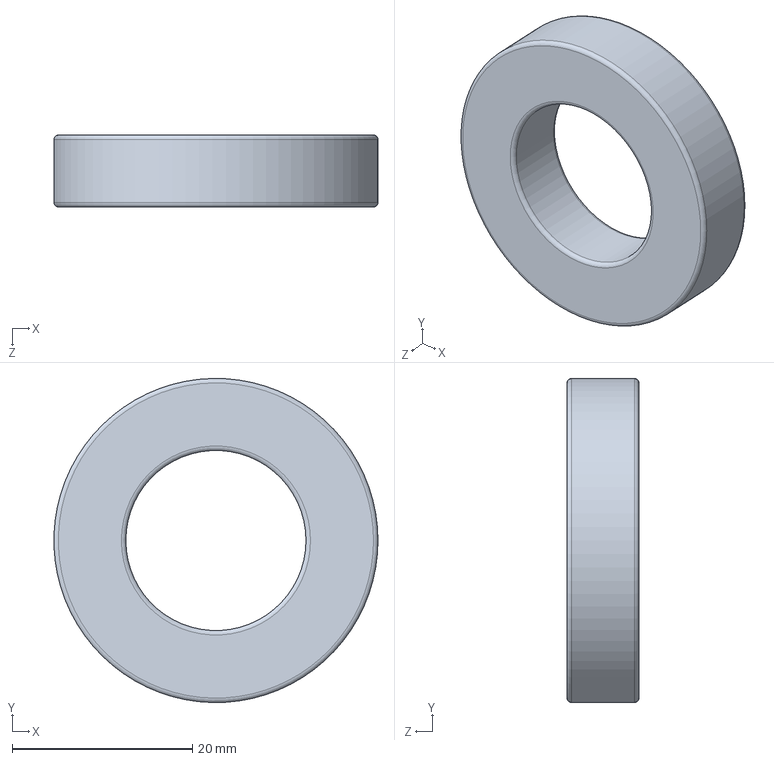
[picture p68: CAD file, 2026-10-06]
hardware/mechanical/腿部/腿部负载测试平台/cad/solidworks/交叉滚子轴承RBH208UUCC0P4.SLDPRT
36.0 x 36.0 x 8.00 mm
