Roboparty/RP1_test/hardware/mechanical/手臂胸腔/共用资料/cad/solidworks/160x160x90带耳.SLDPRT

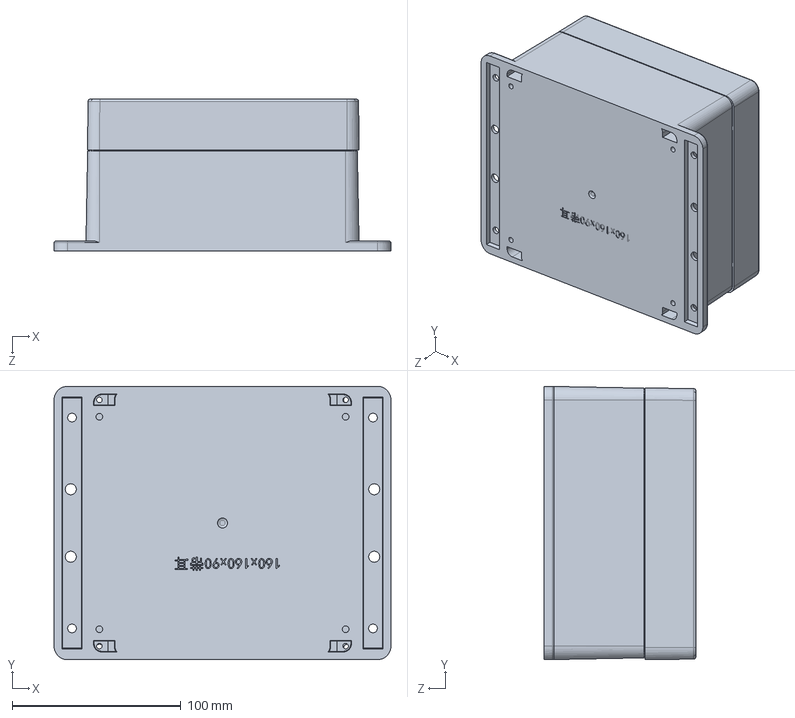
[picture p69: CAD file, 2026-10-06]
hardware/mechanical/手臂胸腔/共用资料/cad/solidworks/160x160x90带耳.SLDPRT
199.9 x 162.2 x 90.2 mm
