Roboparty/RP1_test/hardware/mechanical/腿部/腿部负载测试平台/cad/solidworks/TBF07-M10.SLDPRT

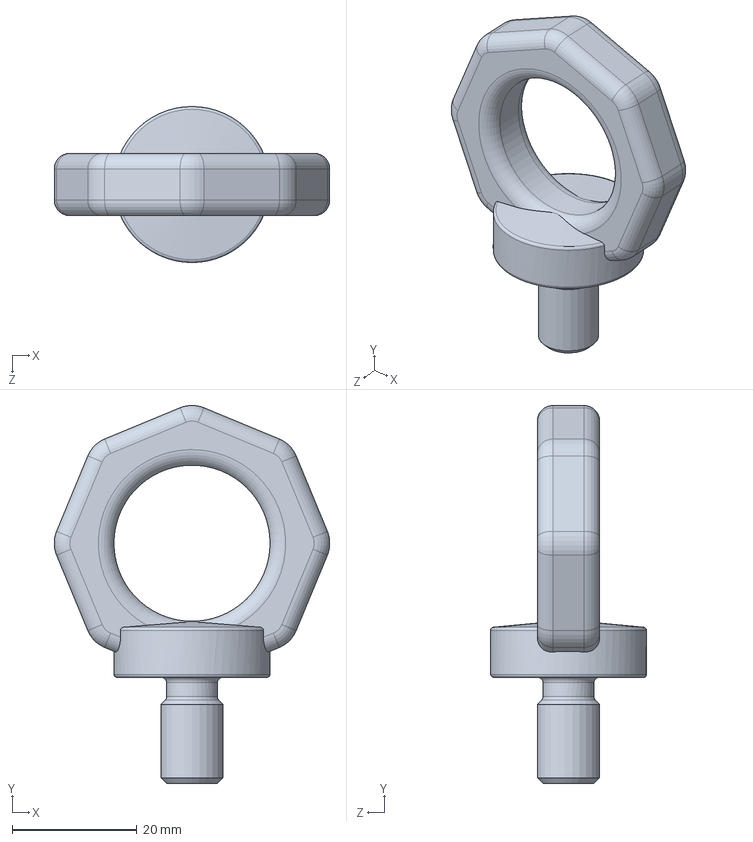
[picture p70: CAD file, 2026-10-06]
hardware/mechanical/腿部/腿部负载测试平台/cad/solidworks/TBF07-M10.SLDPRT
44.1 x 60.6 x 25.0 mm
