Roboparty/RP1_test/hardware/mechanical/腿部/腿部负载测试平台/cad/solidworks/型材架.SLDPRT

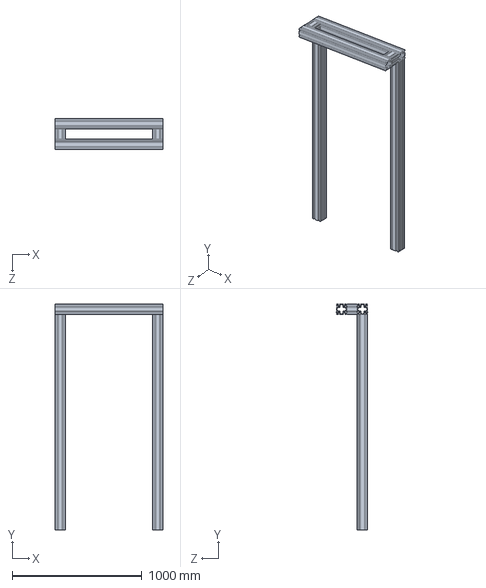
[picture p71: CAD file, 2026-10-06]
hardware/mechanical/腿部/腿部负载测试平台/cad/solidworks/型材架.SLDPRT
830.0 x 1740.0 x 240.0 mm
