Roboparty/RP1_test/hardware/mechanical/手臂胸腔/共用资料/cad/solidworks/AKL13-130.sldprt

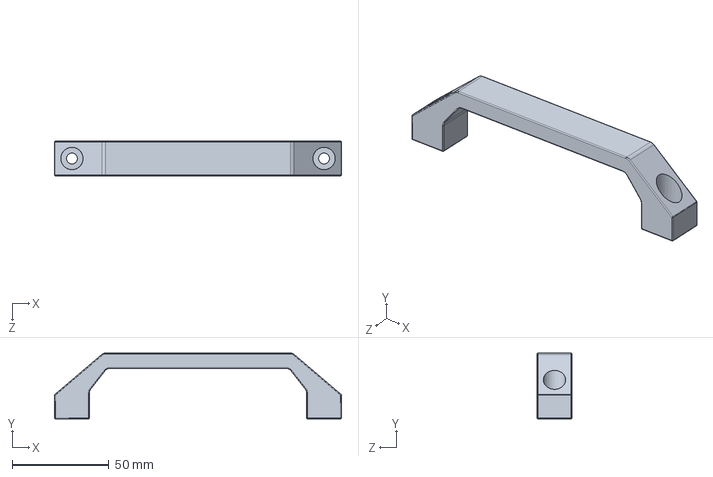
[picture p72: CAD file, 2026-10-06]
hardware/mechanical/手臂胸腔/共用资料/cad/solidworks/AKL13-130.sldprt
148.0 x 34.0 x 18.0 mm
