Roboparty/RP1_test/hardware/mechanical/手臂胸腔/共用资料/cad/solidworks/RP1.3上肢总装（LS75版）.SLDPRT

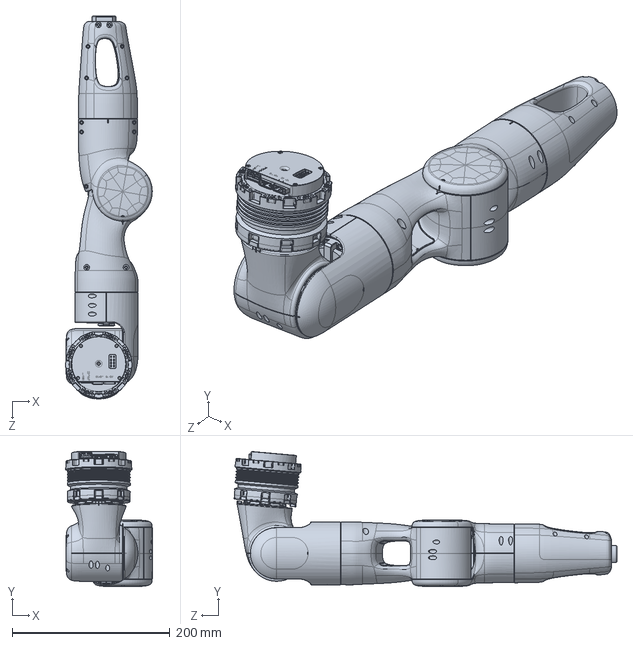
[picture p74: CAD file, 2026-10-06]
hardware/mechanical/手臂胸腔/共用资料/cad/solidworks/RP1.3上肢总装（LS75版）.SLDPRT
109.8 x 171.4 x 485.8 mm
