Roboparty/RP1_test/hardware/mechanical/腿部/腿部负载测试平台/cad/solidworks/钕磁铁-测试.SLDPRT

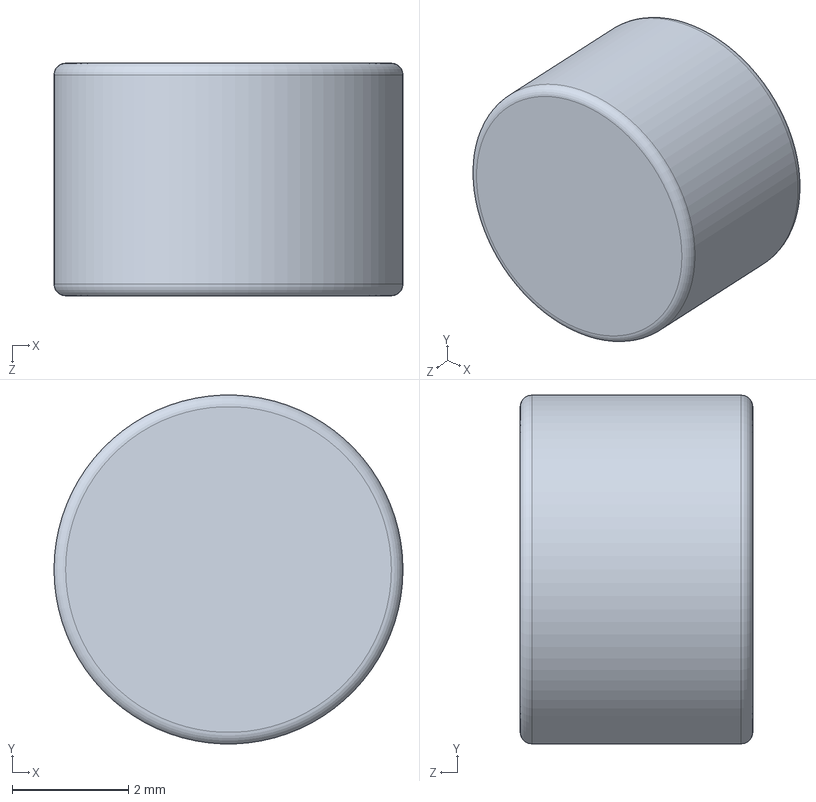
[picture p76: CAD file, 2026-10-06]
hardware/mechanical/腿部/腿部负载测试平台/cad/solidworks/钕磁铁-测试.SLDPRT
6.00 x 6.00 x 4.00 mm
