Roboparty/RP1_test/hardware/mechanical/手臂胸腔/共用资料/cad/solidworks/H10B-TG-4B-PG16（新）.SLDPRT

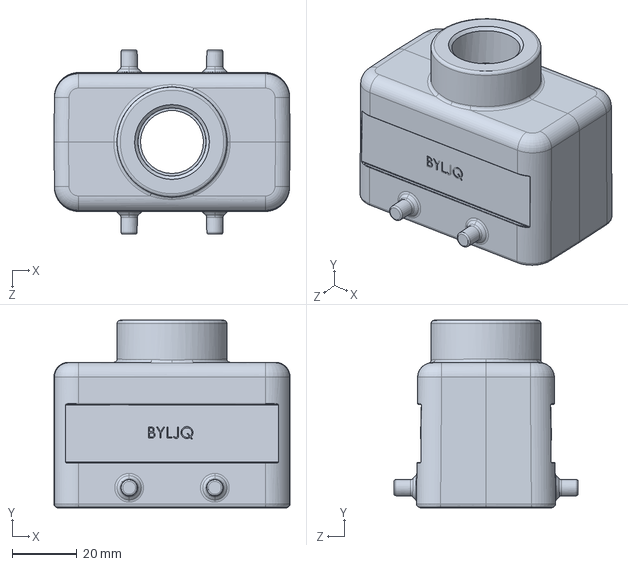
[picture p77: CAD file, 2026-10-06]
hardware/mechanical/手臂胸腔/共用资料/cad/solidworks/H10B-TG-4B-PG16（新）.SLDPRT
73.0 x 58.0 x 57.0 mm
