Roboparty/RP1_test/hardware/mechanical/手臂胸腔/共用资料/cad/solidworks/YCL.M000693 上工装.SLDPRT

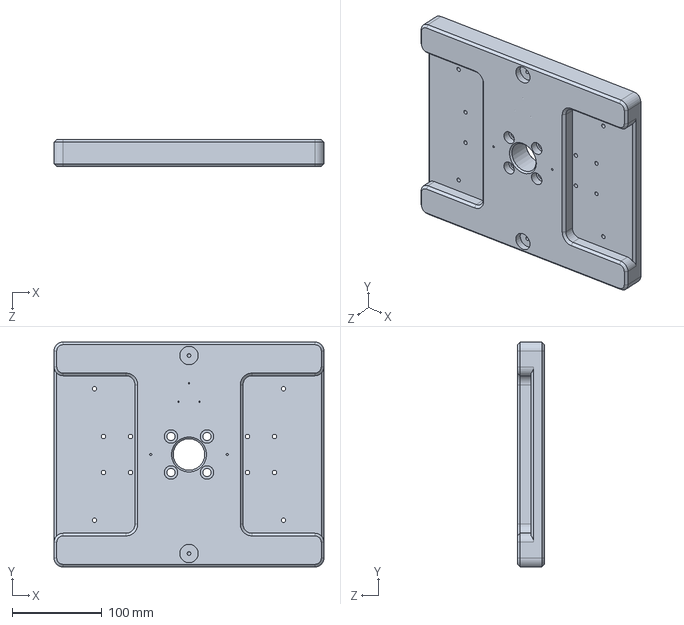
[picture p78: CAD file, 2026-10-06]
hardware/mechanical/手臂胸腔/共用资料/cad/solidworks/YCL.M000693 上工装.SLDPRT
300.0 x 250.0 x 30.0 mm
