Roboparty/RP1_test/hardware/mechanical/手臂胸腔/共用资料/cad/solidworks/开孔底座.SLDPRT

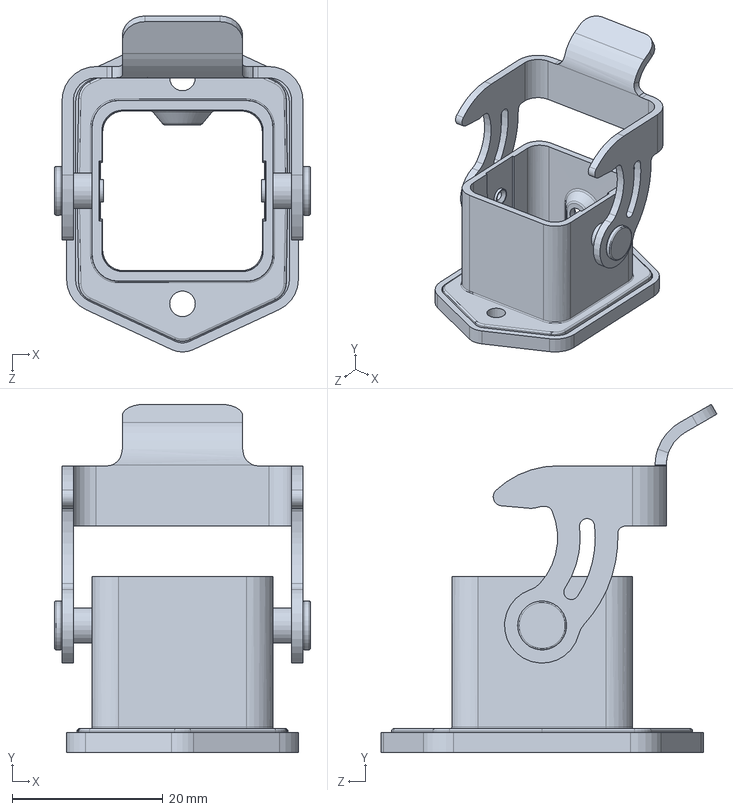
[picture p79: CAD file, 2026-10-06]
hardware/mechanical/手臂胸腔/共用资料/cad/solidworks/开孔底座.SLDPRT
34.0 x 46.3 x 44.6 mm
