Roboparty/RP1_test/hardware/mechanical/腿部/腿部负载测试平台/cad/solidworks/圆柱销 5×45-测试.SLDPRT

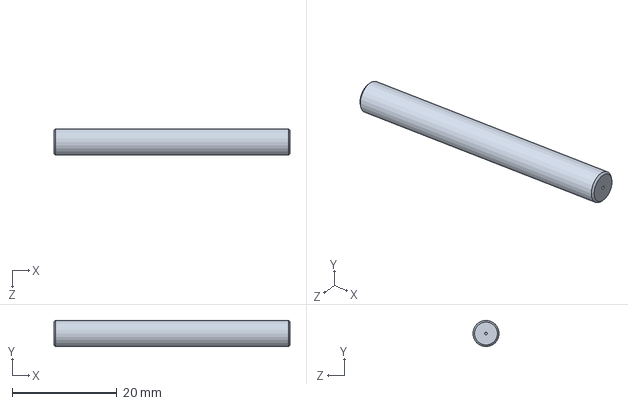
[picture p80: CAD file, 2026-10-06]
hardware/mechanical/腿部/腿部负载测试平台/cad/solidworks/圆柱销 5×45-测试.SLDPRT
45.0 x 5.00 x 5.00 mm
