Roboparty/RP1_test/hardware/mechanical/手臂胸腔/共用资料/cad/solidworks/H10B-AG-2L（新）.SLDPRT

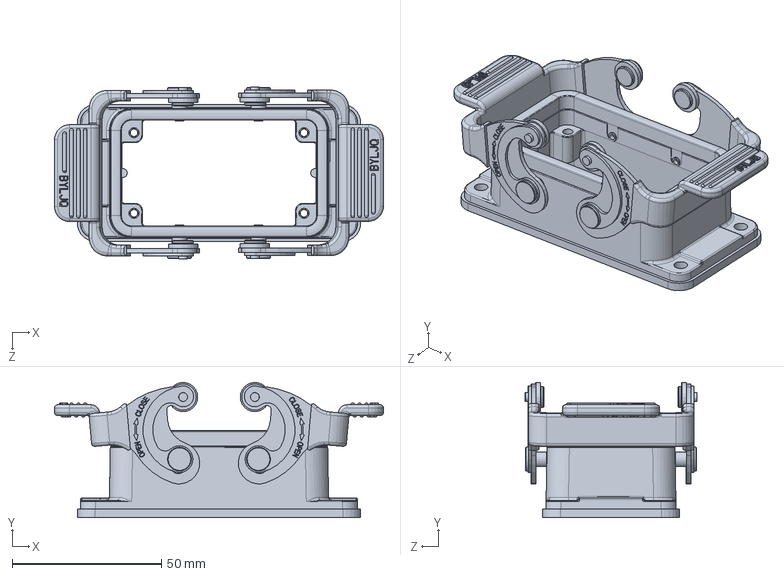
[picture p81: CAD file, 2026-10-06]
hardware/mechanical/手臂胸腔/共用资料/cad/solidworks/H10B-AG-2L（新）.SLDPRT
110.3 x 45.3 x 57.5 mm
