Roboparty/RP1_test/hardware/mechanical/腿部/腿部负载测试平台/cad/solidworks/VBW21-2850-R55-N70-VEW21-005.sldprt

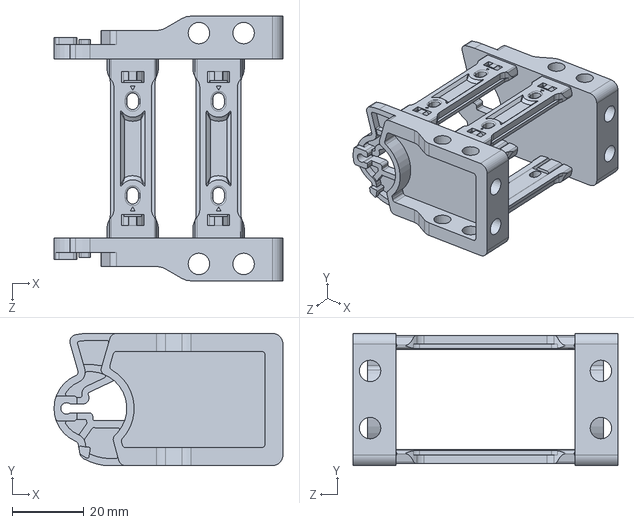
[picture p82: CAD file, 2026-10-06]
hardware/mechanical/腿部/腿部负载测试平台/cad/solidworks/VBW21-2850-R55-N70-VEW21-005.sldprt
64.0 x 37.0 x 74.0 mm
