Roboparty/RP1_test/hardware/mechanical/手臂胸腔/共用资料/cad/solidworks/把手C-NUHFNS66.SLDPRT

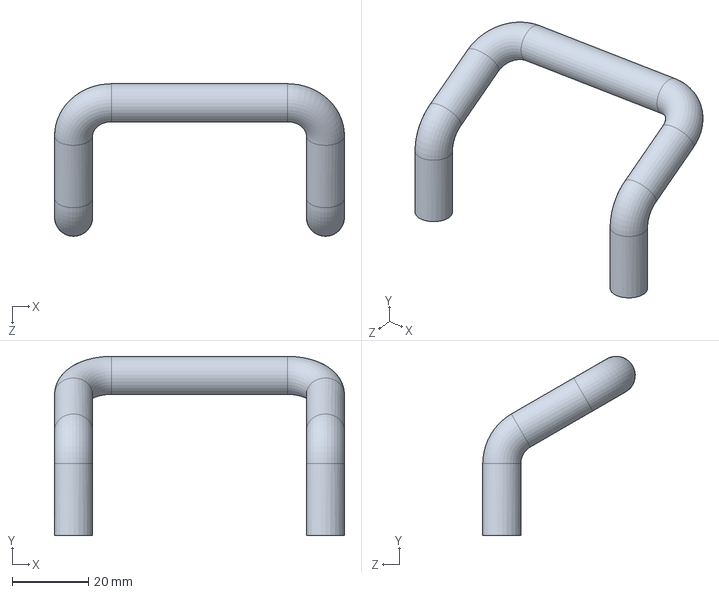
[picture p83: CAD file, 2026-10-06]
hardware/mechanical/手臂胸腔/共用资料/cad/solidworks/把手C-NUHFNS66.SLDPRT
76.0 x 47.0 x 40.0 mm
