Roboparty/RP1_test/hardware/mechanical/腿部/腿部负载测试平台/cad/solidworks/拖链槽.SLDPRT

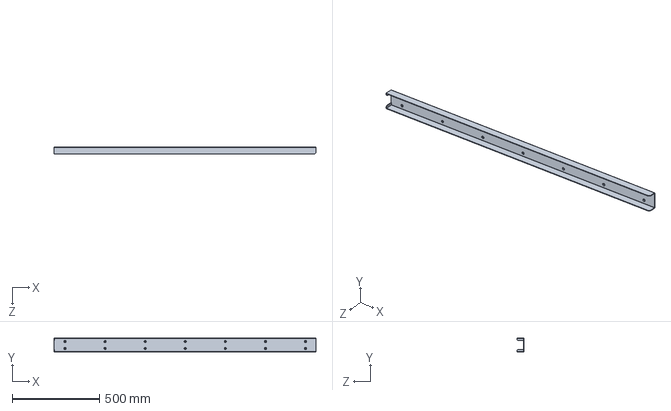
[picture p84: CAD file, 2026-10-06]
hardware/mechanical/腿部/腿部负载测试平台/cad/solidworks/拖链槽.SLDPRT
1503.0 x 80.0 x 40.0 mm
