Roboparty/RP1_test/hardware/mechanical/腿部/腿部负载测试平台/cad/solidworks/电动葫芦安装板.SLDPRT

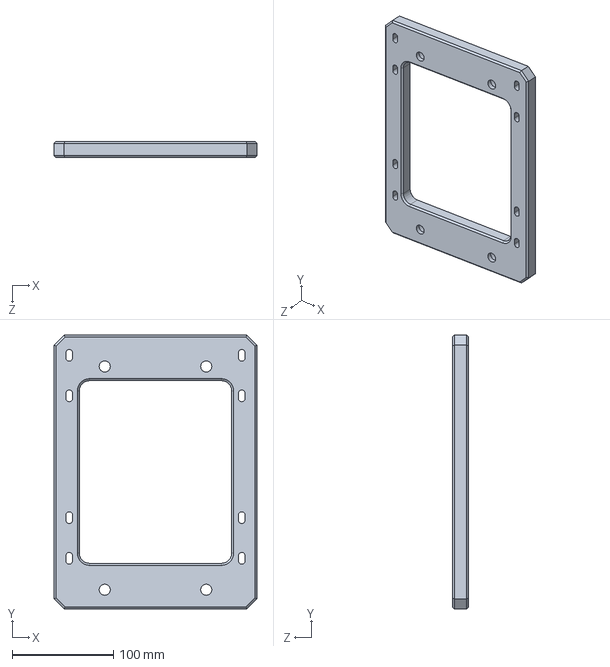
[picture p85: CAD file, 2026-10-06]
hardware/mechanical/腿部/腿部负载测试平台/cad/solidworks/电动葫芦安装板.SLDPRT
200.0 x 270.0 x 16.0 mm
