Roboparty/RP1_test/hardware/mechanical/腿部/腿部负载测试平台/cad/solidworks/小腿8-测试.SLDPRT

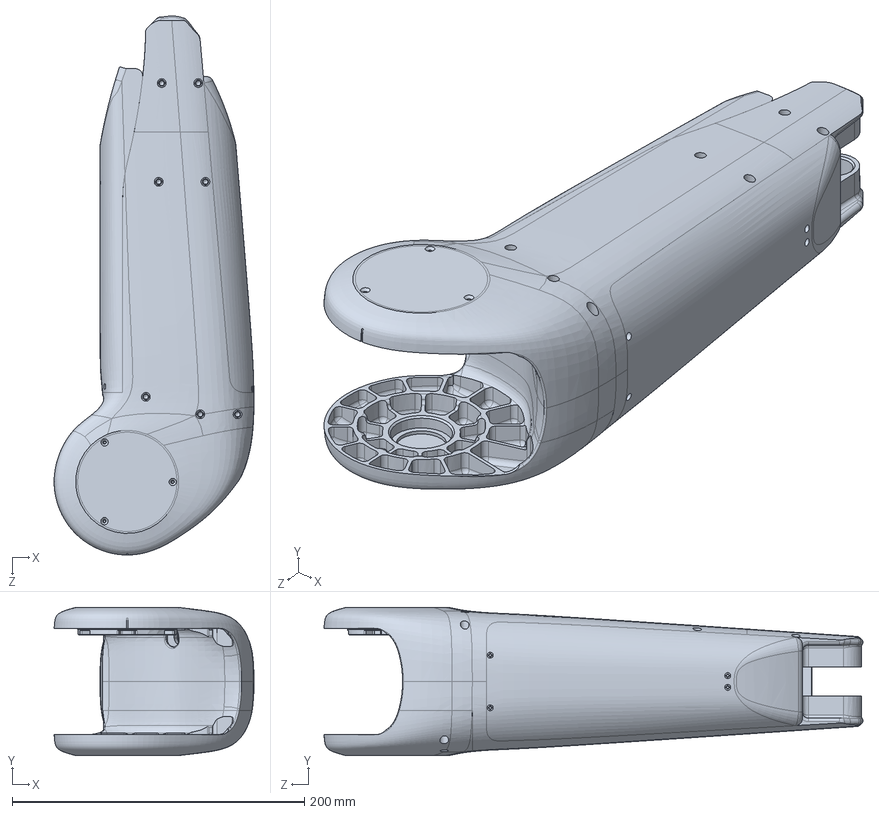
[picture p86: CAD file, 2026-10-06]
hardware/mechanical/腿部/腿部负载测试平台/cad/solidworks/小腿8-测试.SLDPRT
136.7 x 101.4 x 368.7 mm
