Roboparty/RP1_test/hardware/mechanical/手臂胸腔/共用资料/cad/solidworks/水平仪BME31-D32.sldprt

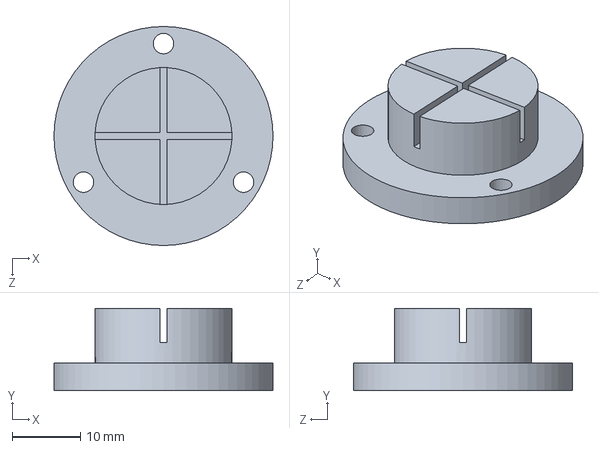
[picture p87: CAD file, 2026-10-06]
hardware/mechanical/手臂胸腔/共用资料/cad/solidworks/水平仪BME31-D32.sldprt
32.0 x 12.0 x 32.0 mm
