Roboparty/RP1_test/hardware/mechanical/腿部/腿部负载测试平台/cad/solidworks/大腿3-测试.SLDPRT

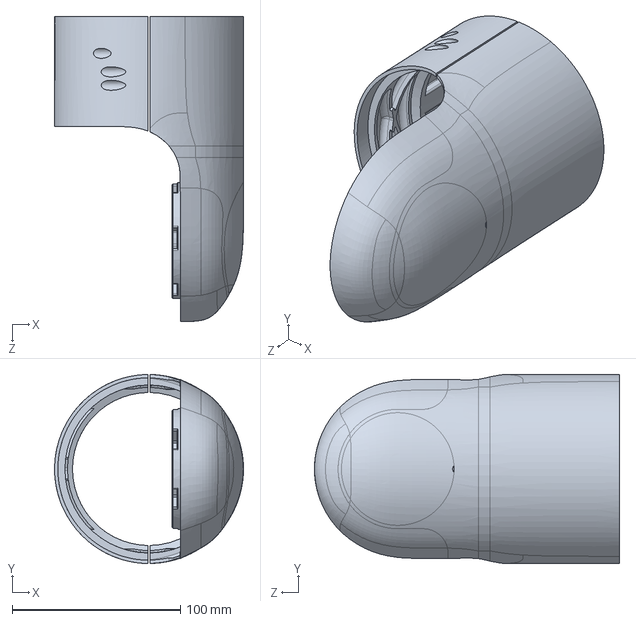
[picture p88: CAD file, 2026-10-06]
hardware/mechanical/腿部/腿部负载测试平台/cad/solidworks/大腿3-测试.SLDPRT
112.4 x 112.4 x 181.6 mm
