Roboparty/RP1_test/hardware/mechanical/腿部/腿部负载测试平台/cad/solidworks/孔用钢丝挡圈16-测试.SLDPRT

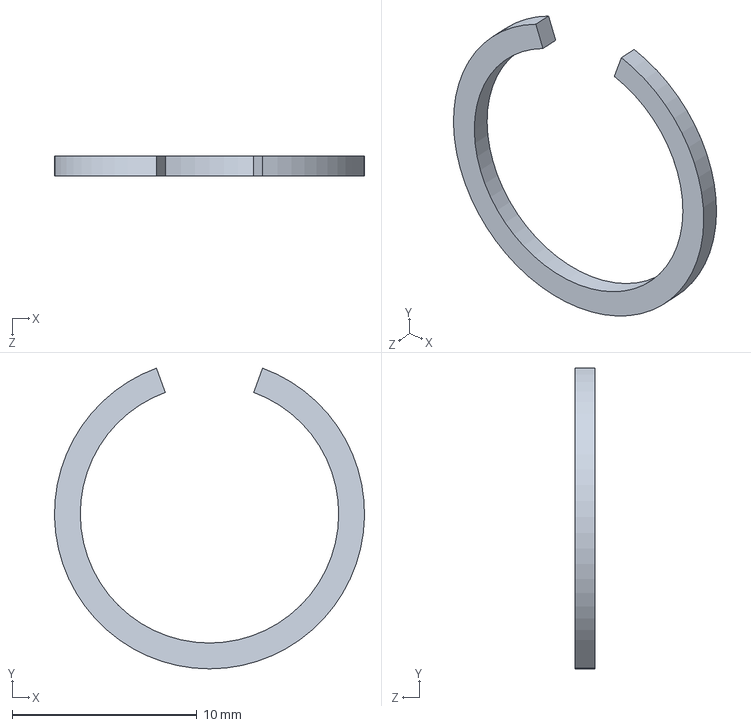
[picture p89: CAD file, 2026-10-06]
hardware/mechanical/腿部/腿部负载测试平台/cad/solidworks/孔用钢丝挡圈16-测试.SLDPRT
16.8 x 16.3 x 1.10 mm
