Roboparty/RP1_test/hardware/mechanical/手臂胸腔/共用资料/cad/solidworks/YCL.M000365 LS97腿部工装.SLDPRT

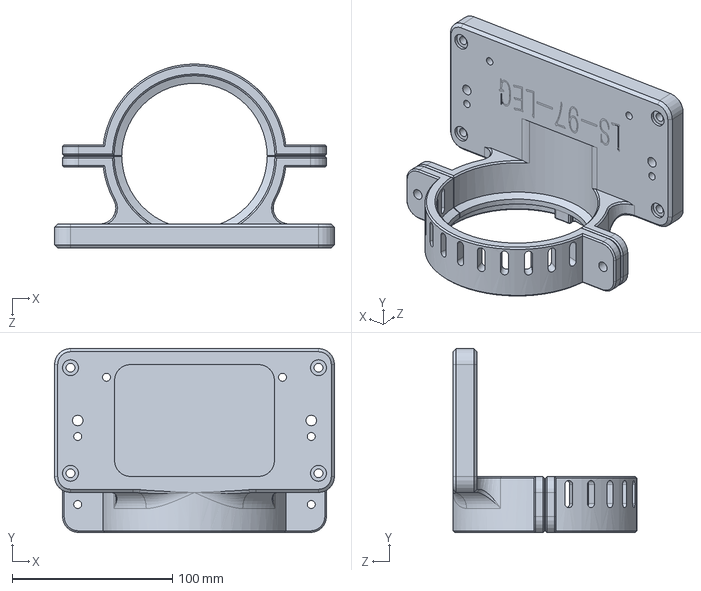
[picture p90: CAD file, 2026-10-06]
hardware/mechanical/手臂胸腔/共用资料/cad/solidworks/YCL.M000365 LS97腿部工装.SLDPRT
175.0 x 115.0 x 115.0 mm
