Roboparty/RP1_test/hardware/mechanical/手臂胸腔/共用资料/cad/solidworks/E-LWAD32-D148-M30-L200.SLDPRT

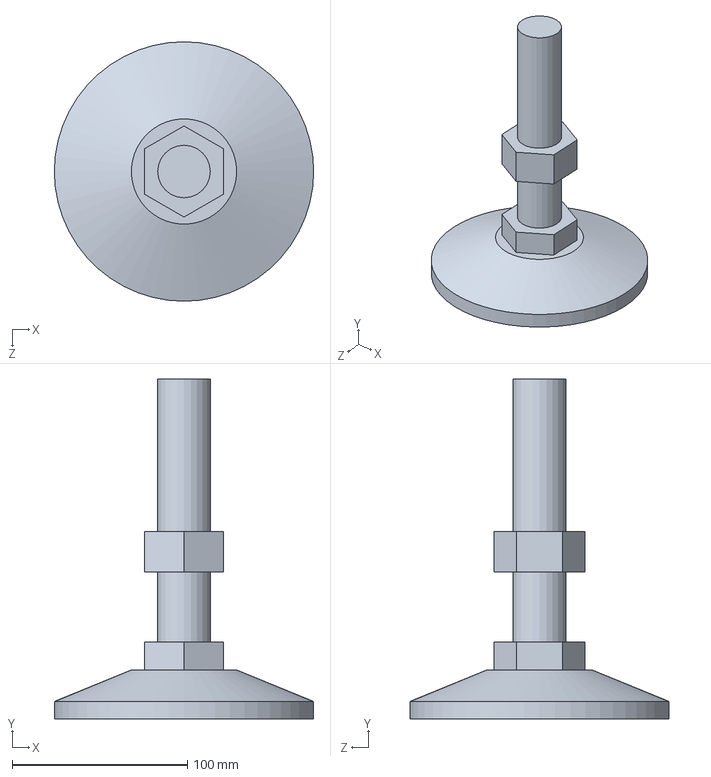
[picture p91: CAD file, 2026-10-06]
hardware/mechanical/手臂胸腔/共用资料/cad/solidworks/E-LWAD32-D148-M30-L200.SLDPRT
148.0 x 194.0 x 148.0 mm
