Roboparty/RP1_test/hardware/mechanical/腿部/腿部负载测试平台/cad/solidworks/平衡器.SLDPRT

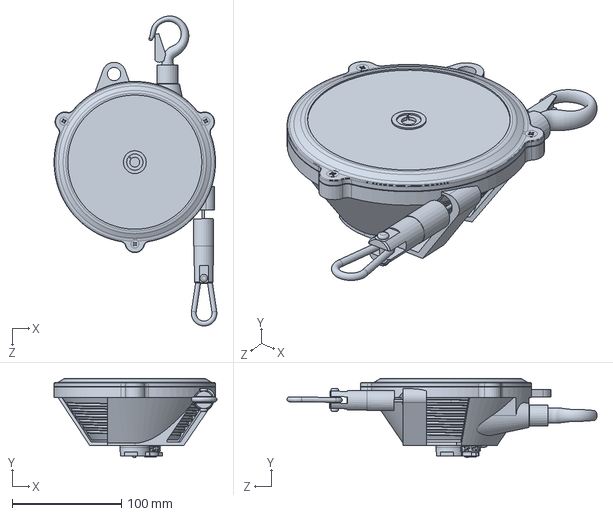
[picture p92: CAD file, 2026-10-06]
hardware/mechanical/腿部/腿部负载测试平台/cad/solidworks/平衡器.SLDPRT
149.3 x 72.7 x 284.2 mm
