Roboparty/RP1_test/hardware/mechanical/腿部/腿部负载测试平台/cad/solidworks/PJ3-97-8.SLDPRT

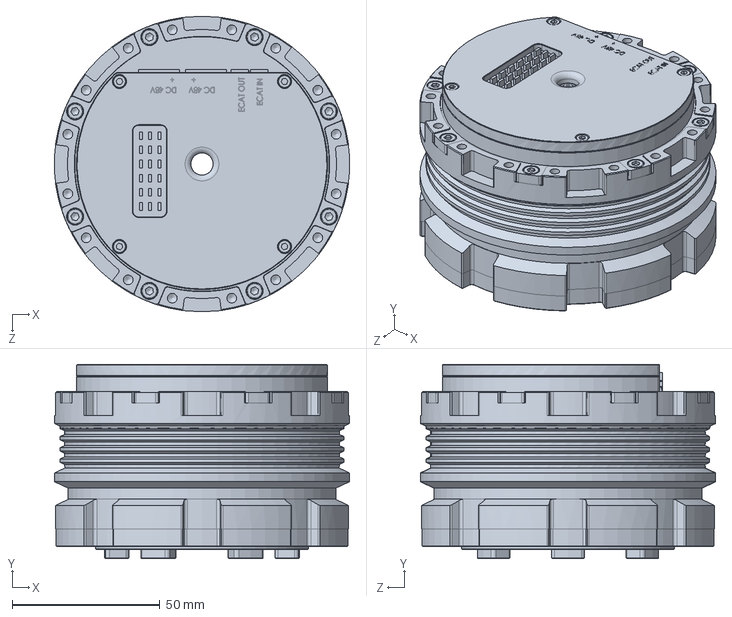
[picture p93: CAD file, 2026-10-06]
hardware/mechanical/腿部/腿部负载测试平台/cad/solidworks/PJ3-97-8.SLDPRT
99.9 x 65.7 x 100.0 mm
