Roboparty/RP1_test/hardware/mechanical/腿部/腿部负载测试平台/cad/solidworks/型材钣金支架.SLDPRT

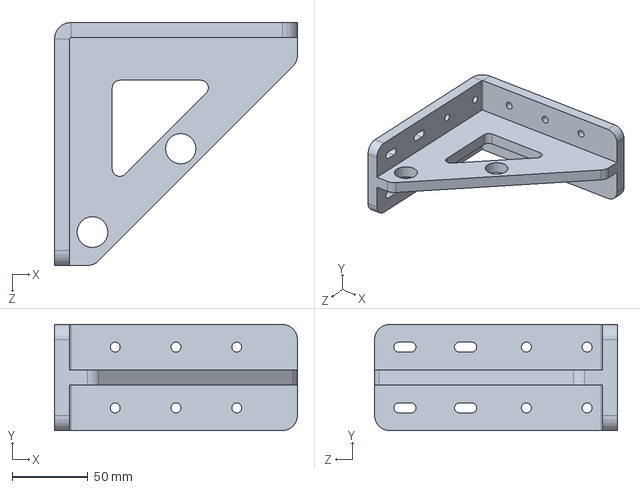
[picture p94: CAD file, 2026-10-06]
hardware/mechanical/腿部/腿部负载测试平台/cad/solidworks/型材钣金支架.SLDPRT
160.0 x 70.0 x 160.0 mm
