Roboparty/RP1_test/hardware/mechanical/腿部/腿部负载测试平台/cad/solidworks/接地铜排.SLDPRT

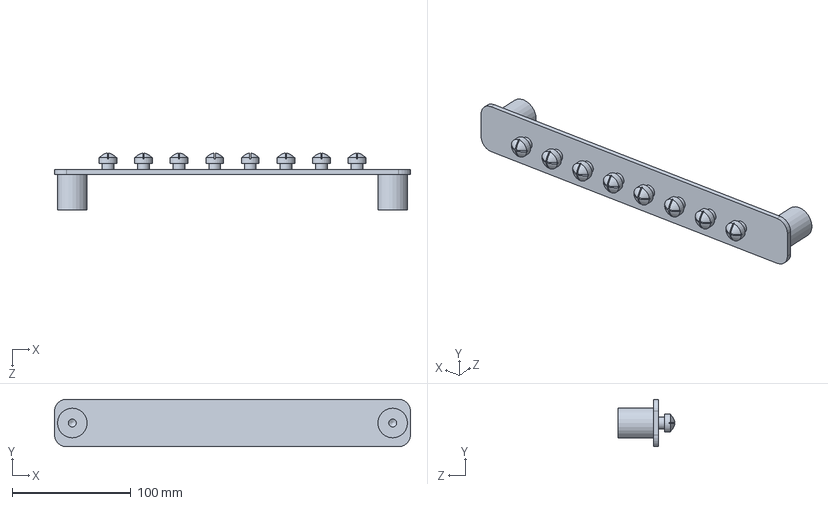
[picture p95: CAD file, 2026-10-06]
hardware/mechanical/腿部/腿部负载测试平台/cad/solidworks/接地铜排.SLDPRT
300.0 x 40.0 x 48.0 mm
