Roboparty/RP1_test/hardware/mechanical/腿部/腿部负载测试平台/cad/solidworks/铜轴套3-测试.SLDPRT

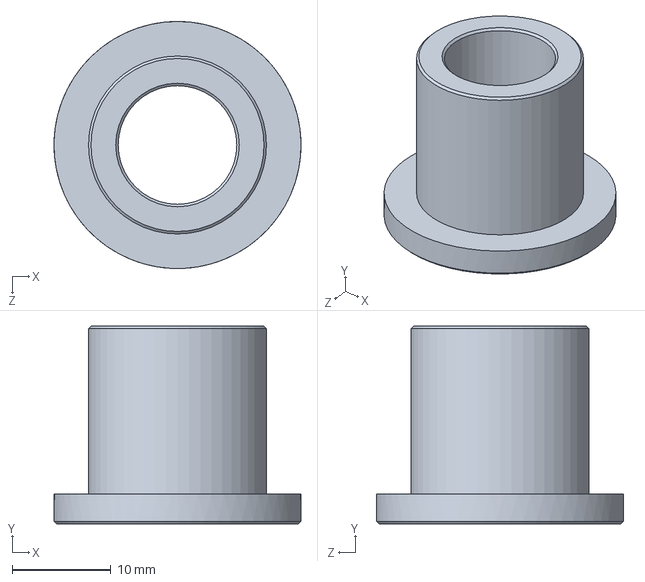
[picture p96: CAD file, 2026-10-06]
hardware/mechanical/腿部/腿部负载测试平台/cad/solidworks/铜轴套3-测试.SLDPRT
25.0 x 20.0 x 25.0 mm
