Roboparty/RP1_test/hardware/mechanical/腿部/腿部负载测试平台/cad/solidworks/假人.SLDPRT

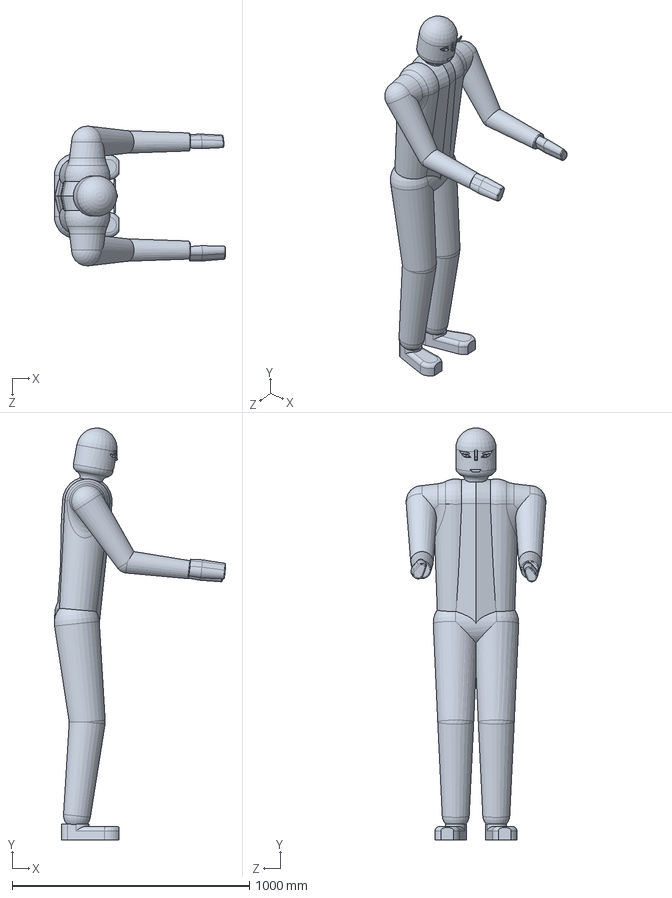
[picture p97: CAD file, 2026-10-06]
hardware/mechanical/腿部/腿部负载测试平台/cad/solidworks/假人.SLDPRT
722.9 x 1737.7 x 589.7 mm
