Roboparty/RP1_test/hardware/mechanical/腿部/腿部负载测试平台/cad/solidworks/接地铜排支架.SLDPRT

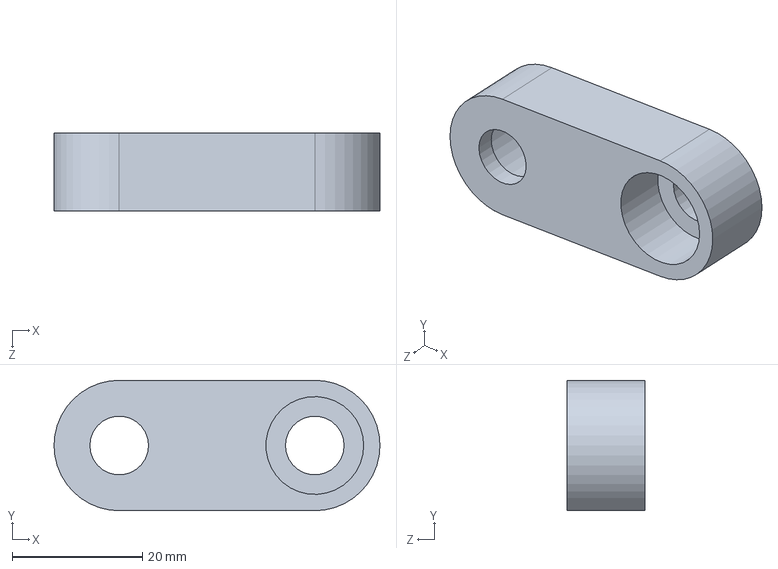
[picture p99: CAD file, 2026-10-06]
hardware/mechanical/腿部/腿部负载测试平台/cad/solidworks/接地铜排支架.SLDPRT
50.0 x 20.0 x 12.0 mm
