Roboparty/RP1_test/hardware/mechanical/腿部/腿部负载测试平台/cad/solidworks/直线导轨安装板.SLDPRT

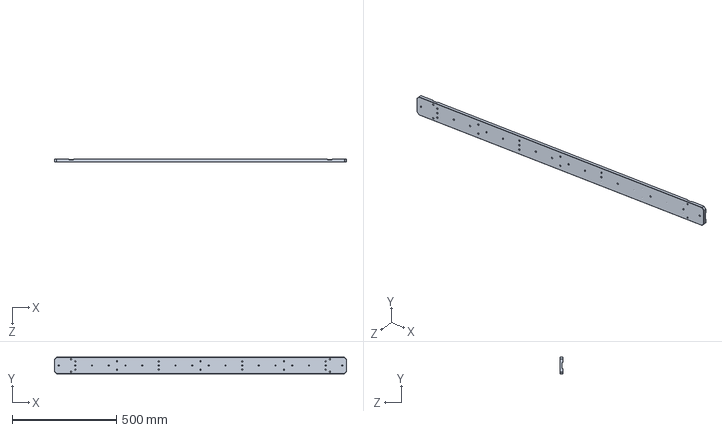
[picture p100: CAD file, 2026-10-06]
hardware/mechanical/腿部/腿部负载测试平台/cad/solidworks/直线导轨安装板.SLDPRT
1400.0 x 80.0 x 14.0 mm
