Roboparty/RP1_test/hardware/mechanical/腿部/腿部负载测试平台/cad/solidworks/E-LHAT12-M6-D25-L25.SLDPRT

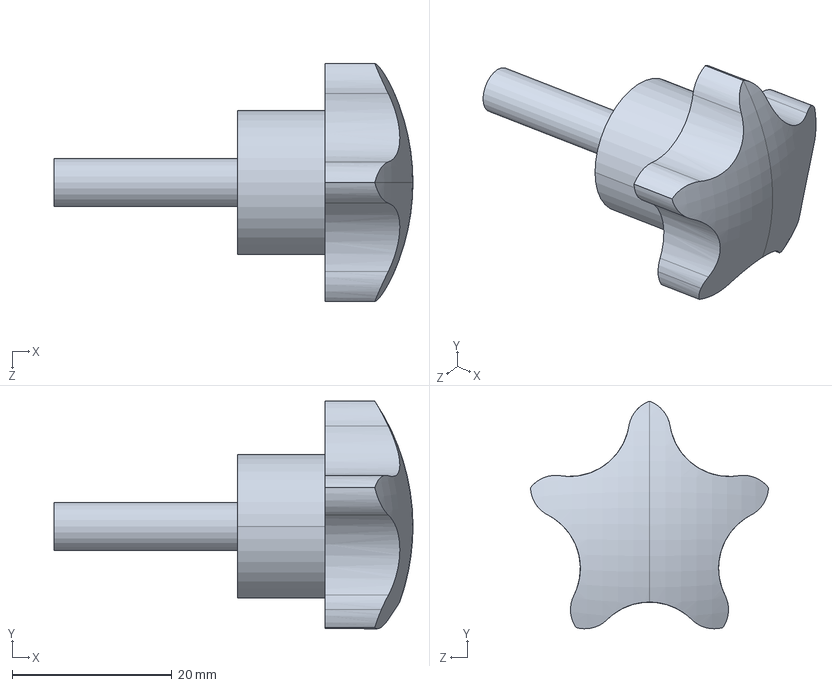
[picture p101: CAD file, 2026-10-06]
hardware/mechanical/腿部/腿部负载测试平台/cad/solidworks/E-LHAT12-M6-D25-L25.SLDPRT
45.0 x 28.5 x 29.8 mm
