Roboparty/RP1_test/hardware/mechanical/腿部/腿部负载测试平台/cad/solidworks/M10螺杆.SLDPRT

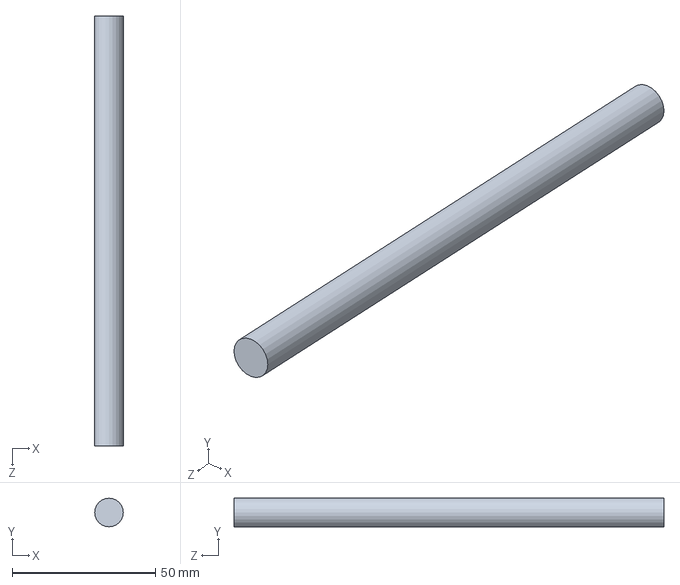
[picture p102: CAD file, 2026-10-06]
hardware/mechanical/腿部/腿部负载测试平台/cad/solidworks/M10螺杆.SLDPRT
10.0 x 10.0 x 150.0 mm
