Roboparty/RP1_test/hardware/mechanical/腿部/腿部负载测试平台/cad/solidworks/风扇降压3.step

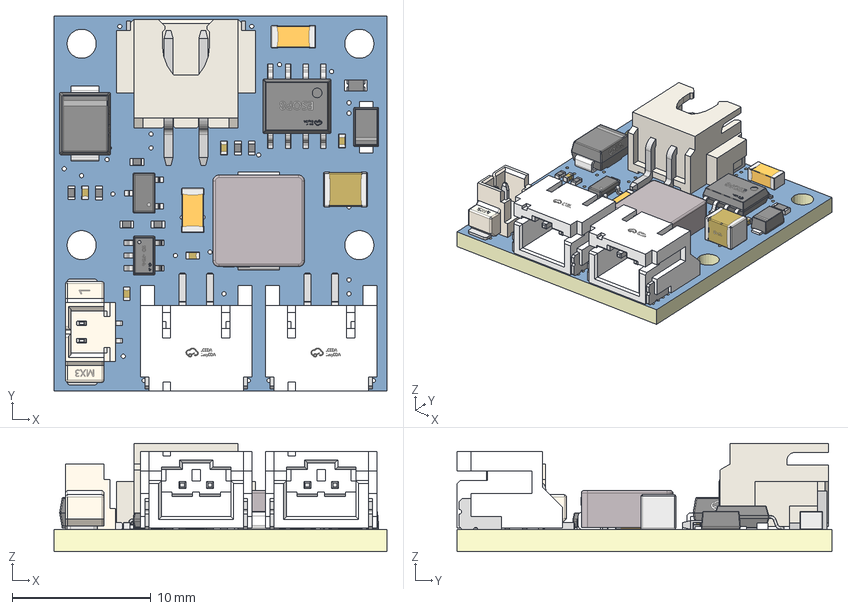
[picture p103: CAD file, 2026-10-06]
hardware/mechanical/腿部/腿部负载测试平台/cad/solidworks/风扇降压3.step
24.0 x 27.0 x 7.80 mm
Board~Y3p6
TopCopper~Y3p6
BottomCopper~Y3p6
TopFpcStiffener~Y3p6
BottomFpcStiffener~Y3p6
R0402~R0402_L1.0-W0.5-H0.4~SuB3 x 7
IND-SMD_L7.2-W6.6_GPSR07X0~IND-SMD_L7.2-W6.6-H3.0_GPSR07X0~QDXO
CONN-SMD_ZX-PH2.0-WT2P~CONN-SMD_ZX-PH2.0-WT2P~X2Mh x 2
SOT-23-3_L2.9-W1.6-P1.90-LS2.8-BR~SOT-23-3L_L2.9-W1.6-H1.1-LS2.8-P0.95~a38G
SOD-123F_L2.8-W1.8-LS3.7-RD~SOD-123FL_L2.8-W1.8-LS3.7-RD-1~419c
C0402~C0402~ivV2 x 5
C1210~C1210_L3.2-W2.5-H2.5~wg7a
C1206~C1206_L3.2-W1.6-H1.3~xPCB x 2
SOT-23-5_L3.0-W1.7-P0.95-LS2.8-BR~SOT-23-5_L2.9-W1.6-H1.1-LS2.8-P0.95~ziwL
SMB_L4.5-W3.7-LS5.4-RD~SMB_L4.5-W3.7-LS5.4-RD~Cegx
CONN-SMD_1.25-2P~CONN-SMD_1.25-2P~Oyuz
ESOP-8_L4.9-W3.9-P1.27-LS6.0-BL-EP~ESOP-8_L4.9-W3.9-H1.6-LS6.0-P1.27~Vqw6
CONN-SMD_2P-L10.0-W7.8-P2.5~CONN-SMD_2P-L10.0-W7.8-P2.5~0epL
R0603~R0603~TcXq
