Roboparty/RP1_test/hardware/mechanical/腿部/腿部负载测试平台/cad/solidworks/M_CAP_V1.0.SLDPRT

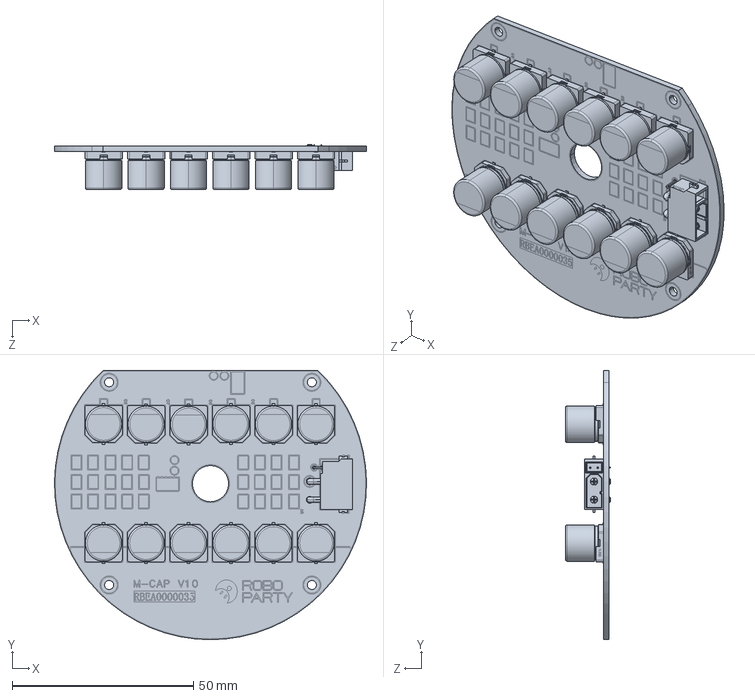
[picture p104: CAD file, 2026-10-06]
hardware/mechanical/腿部/腿部负载测试平台/cad/solidworks/M_CAP_V1.0.SLDPRT
86.0 x 74.2 x 12.5 mm
