Roboparty/RP1_test/hardware/mechanical/腿部/腿部负载测试平台/cad/solidworks/大腿3下-测试.SLDPRT

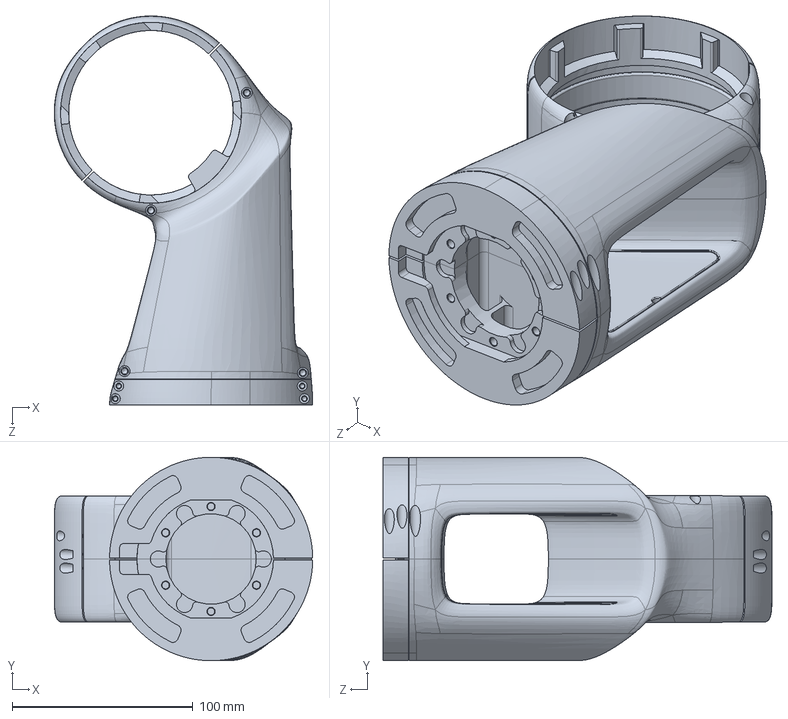
[picture p105: CAD file, 2026-10-06]
hardware/mechanical/腿部/腿部负载测试平台/cad/solidworks/大腿3下-测试.SLDPRT
142.9 x 112.4 x 215.1 mm
