Roboparty/RP1_test/hardware/mechanical/腿部/腿部负载测试平台/cad/solidworks/铜轴套2-测试.SLDPRT

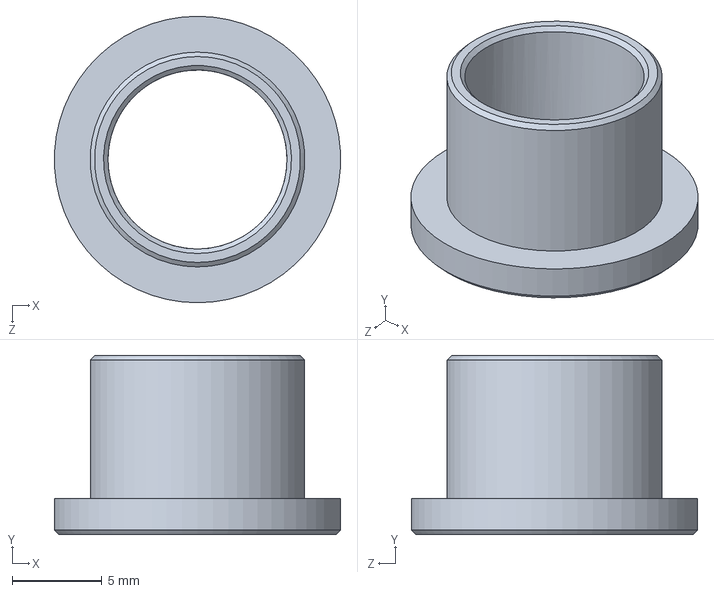
[picture p106: CAD file, 2026-10-06]
hardware/mechanical/腿部/腿部负载测试平台/cad/solidworks/铜轴套2-测试.SLDPRT
16.0 x 10.0 x 16.0 mm
