Roboparty/RP1_test/hardware/mechanical/腿部/腿部负载测试平台/cad/solidworks/旋转主板1.SLDPRT

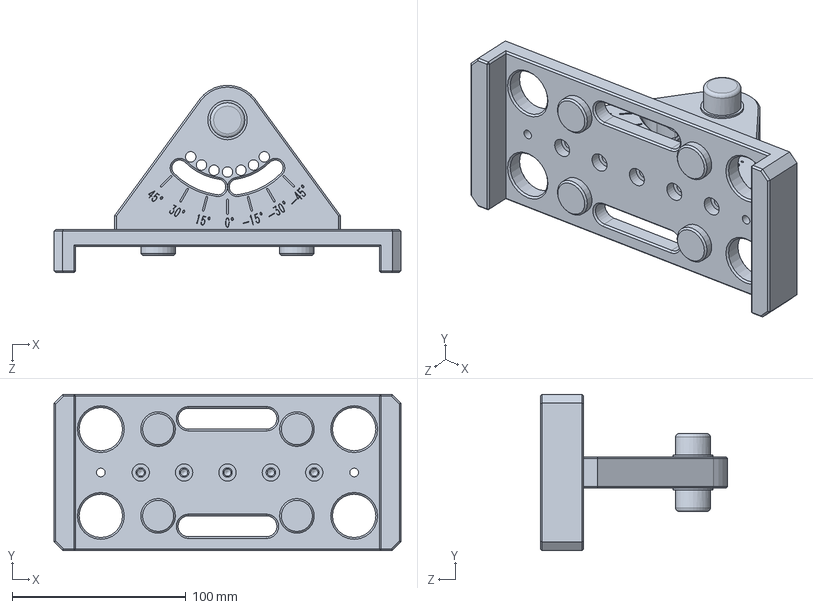
[picture p107: CAD file, 2026-10-06]
hardware/mechanical/腿部/腿部负载测试平台/cad/solidworks/旋转主板1.SLDPRT
200.0 x 90.0 x 108.0 mm
