Roboparty/RP1_test/hardware/mechanical/腿部/腿部负载测试平台/cad/solidworks/60型材.SLDPRT

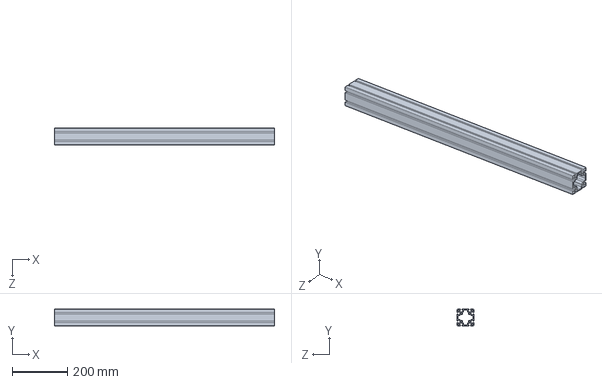
[picture p108: CAD file, 2026-10-06]
hardware/mechanical/腿部/腿部负载测试平台/cad/solidworks/60型材.SLDPRT
800.0 x 60.0 x 60.0 mm
