Roboparty/RP1_test/hardware/mechanical/腿部/腿部负载测试平台/cad/solidworks/E-CLHS75-N.SLDPRT

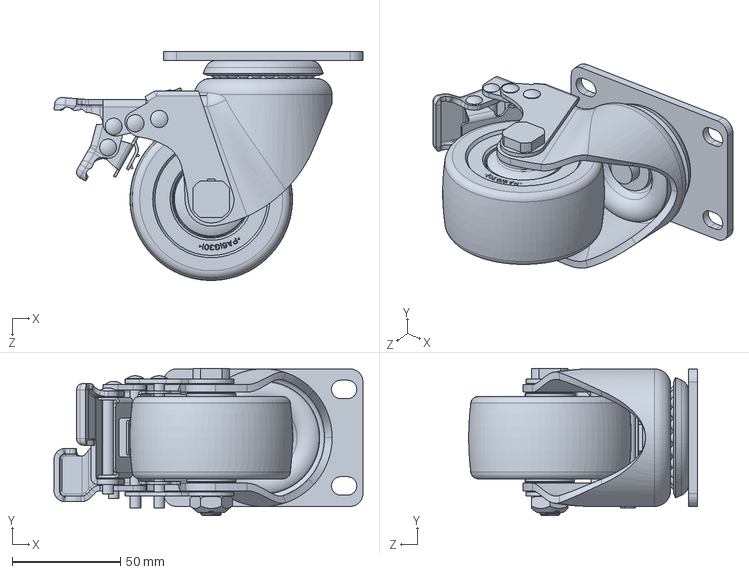
[picture p109: CAD file, 2026-10-06]
hardware/mechanical/腿部/腿部负载测试平台/cad/solidworks/E-CLHS75-N.SLDPRT
142.5 x 68.0 x 105.5 mm
