Roboparty/RP1_test/hardware/mechanical/腿部/腿部负载测试平台/cad/solidworks/缓冲器安装座.SLDPRT

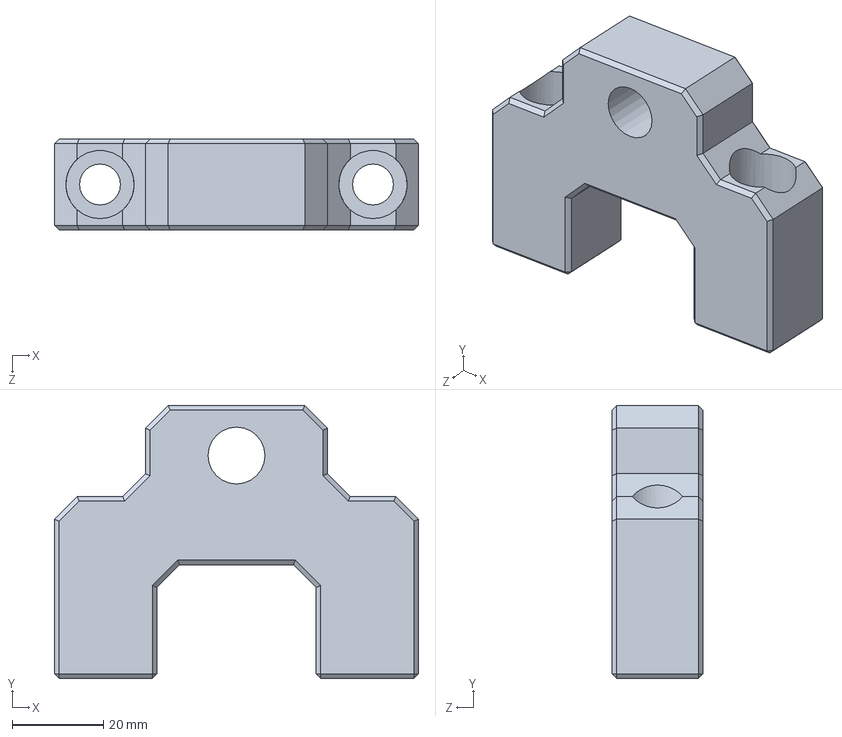
[picture p110: CAD file, 2026-10-06]
hardware/mechanical/腿部/腿部负载测试平台/cad/solidworks/缓冲器安装座.SLDPRT
80.0 x 60.0 x 20.0 mm
