Roboparty/RP1_test/hardware/mechanical/腿部/腿部负载测试平台/cad/solidworks/滑块安装板.SLDPRT

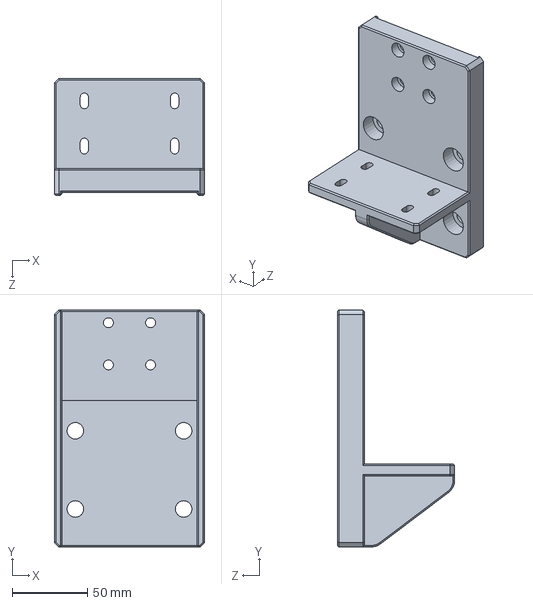
[picture p111: CAD file, 2026-10-06]
hardware/mechanical/腿部/腿部负载测试平台/cad/solidworks/滑块安装板.SLDPRT
100.0 x 157.5 x 78.0 mm
