Roboparty/RP1_test/hardware/mechanical/腿部/腿部负载测试平台/cad/solidworks/HGW30钳制器.SLDPRT

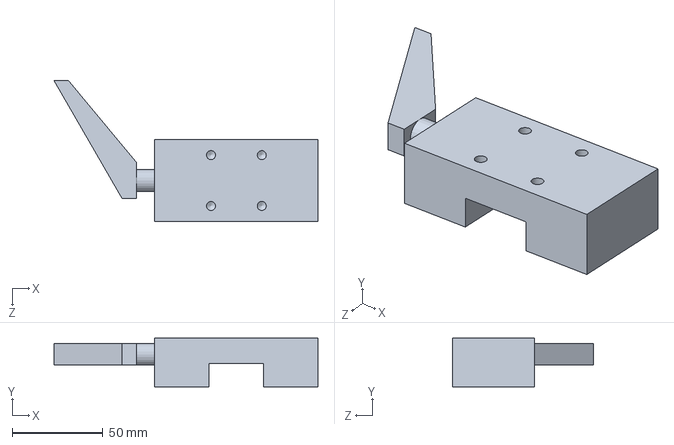
[picture p112: CAD file, 2026-10-06]
hardware/mechanical/腿部/腿部负载测试平台/cad/solidworks/HGW30钳制器.SLDPRT
145.5 x 27.0 x 77.6 mm
