Roboparty/RP1_test/hardware/mechanical/腿部/腿部负载测试平台/cad/solidworks/C-HLGW30-1400_r.sldprt

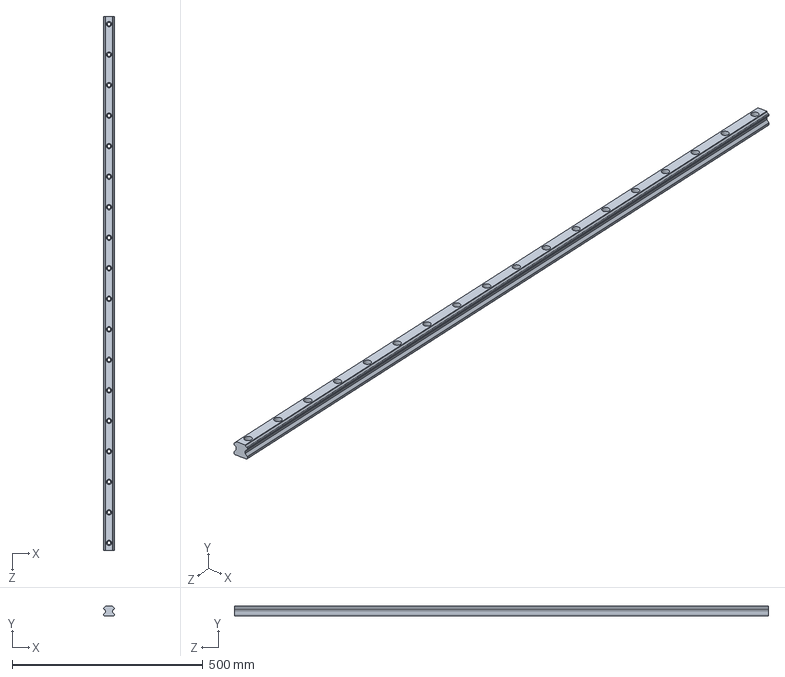
[picture p113: CAD file, 2026-10-06]
hardware/mechanical/腿部/腿部负载测试平台/cad/solidworks/C-HLGW30-1400_r.sldprt
28.0 x 26.0 x 1400.0 mm
