Roboparty/RP1_test/hardware/mechanical/腿部/腿部负载测试平台/cad/solidworks/PJ3-60-8-测试.SLDPRT

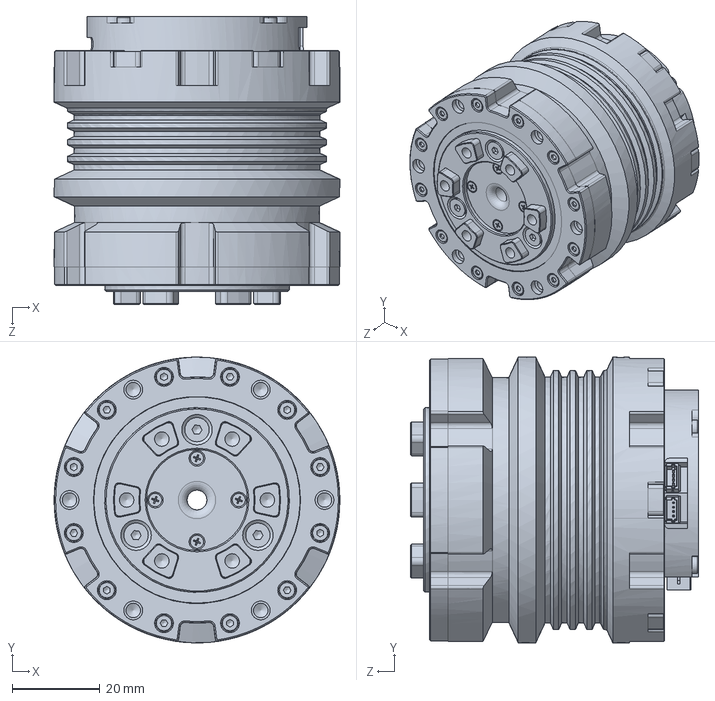
[picture p114: CAD file, 2026-10-06]
hardware/mechanical/腿部/腿部负载测试平台/cad/solidworks/PJ3-60-8-测试.SLDPRT
65.0 x 65.0 x 65.5 mm
