Roboparty/RP1_test/hardware/mechanical/腿部/腿部负载测试平台/cad/solidworks/电动葫芦.SLDPRT

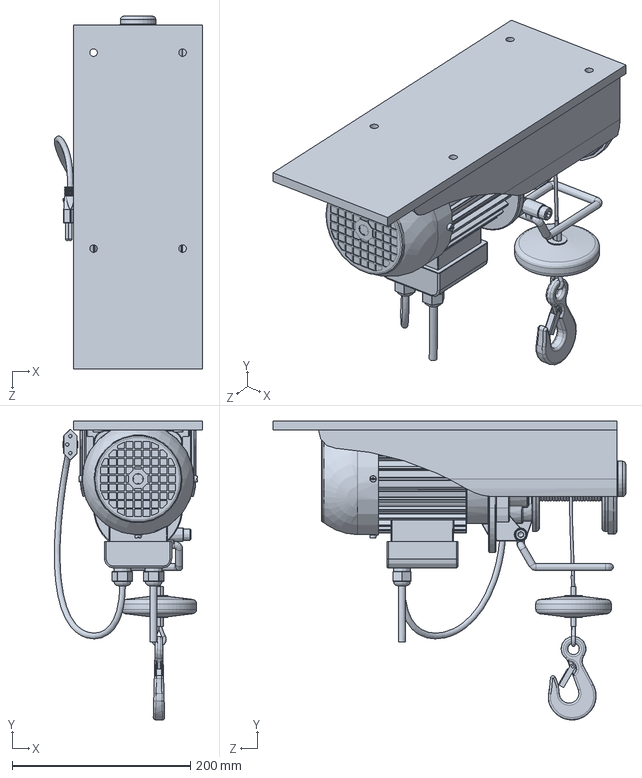
[picture p115: CAD file, 2026-10-06]
hardware/mechanical/腿部/腿部负载测试平台/cad/solidworks/电动葫芦.SLDPRT
166.5 x 335.7 x 396.0 mm
