Roboparty/RP1_test/hardware/mechanical/腿部/腿部负载测试平台/cad/solidworks/六角螺母 M10.SLDPRT

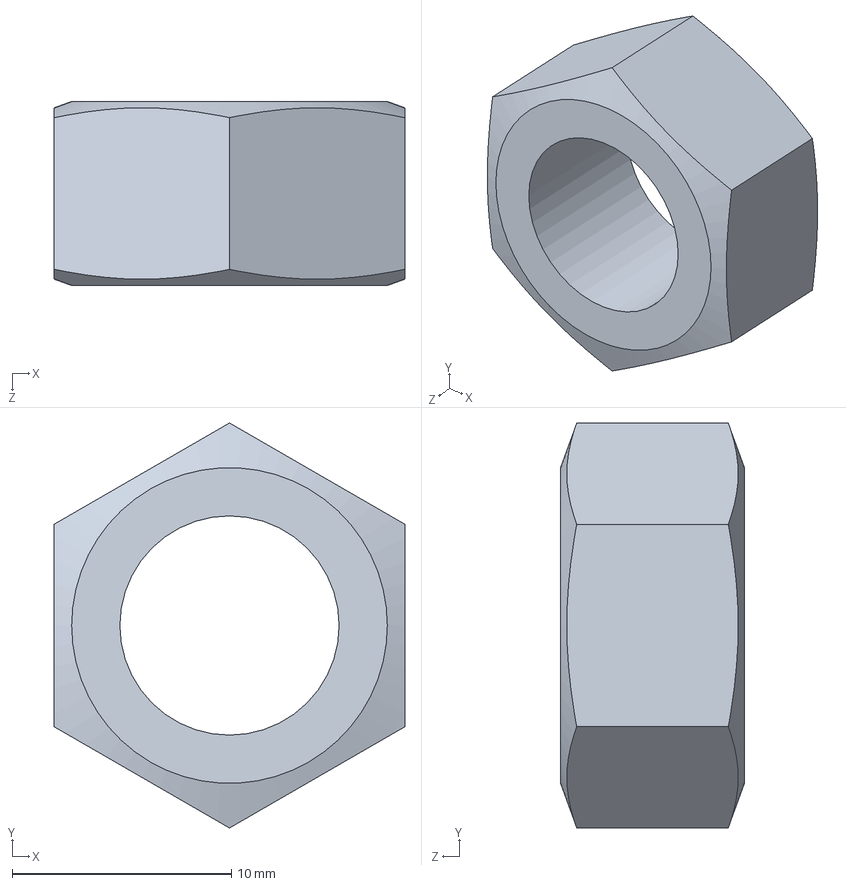
[picture p116: CAD file, 2026-10-06]
hardware/mechanical/腿部/腿部负载测试平台/cad/solidworks/六角螺母 M10.SLDPRT
16.0 x 18.5 x 8.40 mm
