Roboparty/RP1_test/hardware/mechanical/腿部/腿部负载测试平台/cad/solidworks/BRACKET_LBLUS8080B-70.SLDPRT

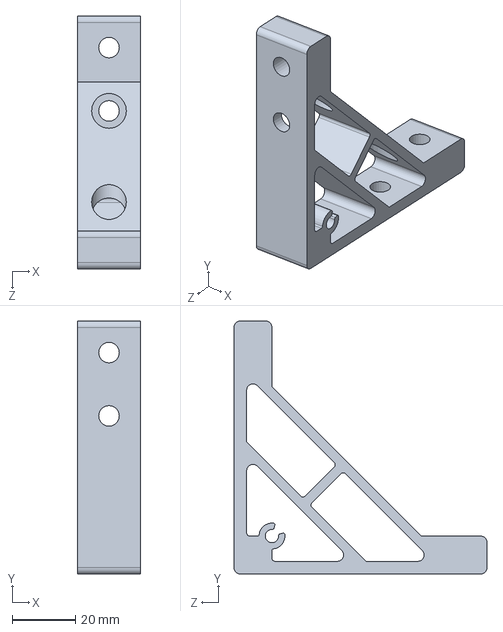
[picture p117: CAD file, 2026-10-06]
hardware/mechanical/腿部/腿部负载测试平台/cad/solidworks/BRACKET_LBLUS8080B-70.SLDPRT
20.0 x 80.0 x 80.0 mm
