Roboparty/RP1_test/hardware/mechanical/腿部/腿部负载测试平台/cad/solidworks/旋转主板2.SLDPRT

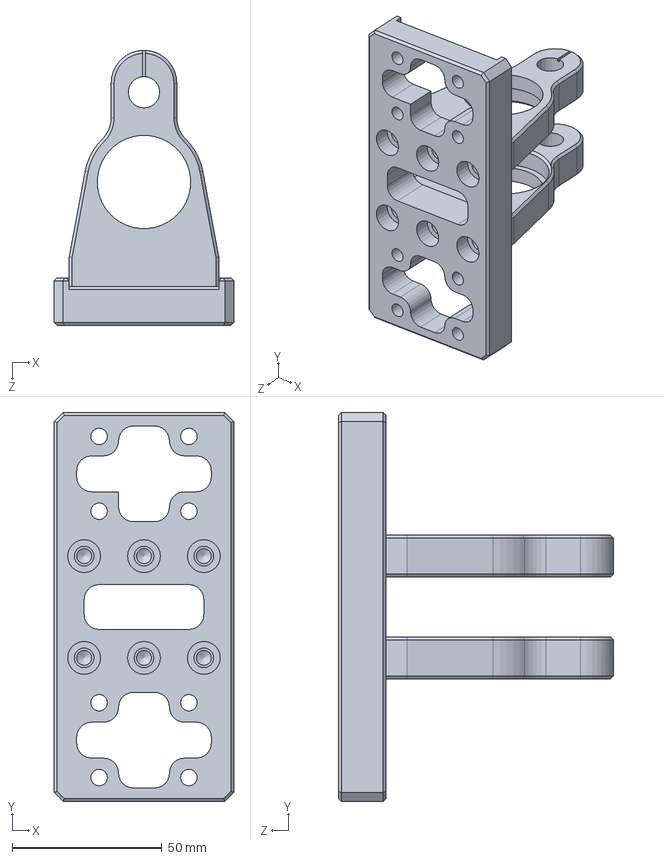
[picture p118: CAD file, 2026-10-06]
hardware/mechanical/腿部/腿部负载测试平台/cad/solidworks/旋转主板2.SLDPRT
60.0 x 130.0 x 92.0 mm
