Roboparty/RP1_test/hardware/mechanical/腿部/腿部负载测试平台/cad/solidworks/J-WJG12-1425-001.SLDPRT

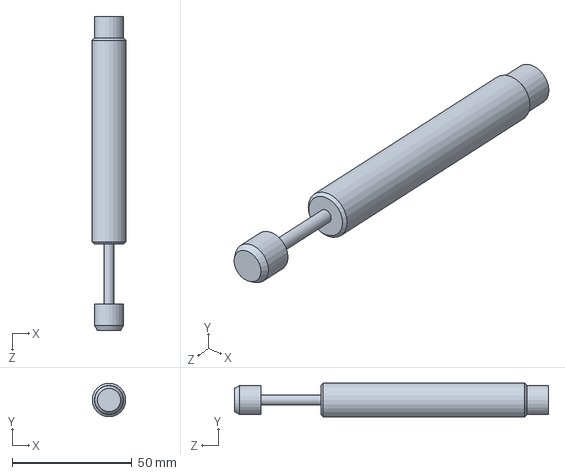
[picture p119: CAD file, 2026-10-06]
hardware/mechanical/腿部/腿部负载测试平台/cad/solidworks/J-WJG12-1425-001.SLDPRT
14.0 x 14.0 x 131.0 mm
