Roboparty/RP1_test/hardware/mechanical/腿部/腿部负载测试平台/cad/solidworks/大腿装配体-测试.SLDASM

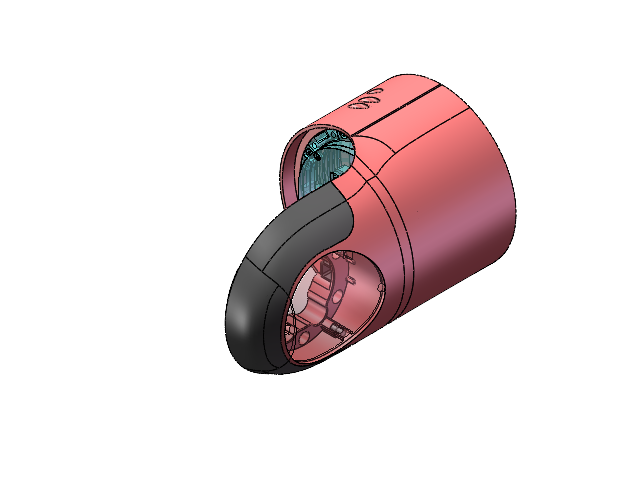
[picture p120: CAD file, 2026-10-06]
hardware/mechanical/腿部/腿部负载测试平台/cad/solidworks/大腿装配体-测试.SLDASM
RB000244 大腿盖子-测试
RB000245 大腿橡胶垫-测试
RB000246 大腿本体-测试
RB000247 大腿抱箍-测试
PJ3-97-8-测试 x 2
RB000248 Roll限位-测试
RB000249 Yaw限位3-测试
RB000250 压线块1-测试
钕磁铁4×4-测试 x 6
