Roboparty/RP1_test/hardware/mechanical/腿部/腿部负载测试平台/cad/solidworks/脚部装配体-测试.SLDASM

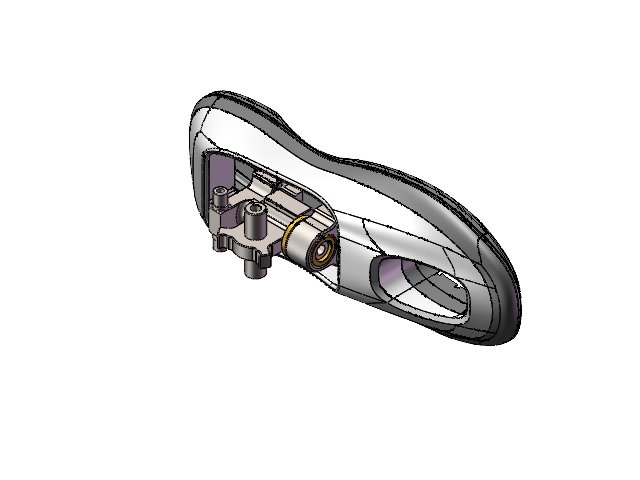
[picture p121: CAD file, 2026-10-06]
hardware/mechanical/腿部/腿部负载测试平台/cad/solidworks/脚部装配体-测试.SLDASM
RB000272 脚底十字轴-测试
RB000273 脚底固定一号-测试
RB000274 脚底固定二号-测试
铜轴套2-测试
铜轴套3-测试
RB000275 脚板-测试
RB000276 脚面-测试
RB000277 鞋垫-测试
