Roboparty/RP1_test/hardware/mechanical/腿部/腿部负载测试平台/cad/solidworks/小腿装配体-测试.SLDASM

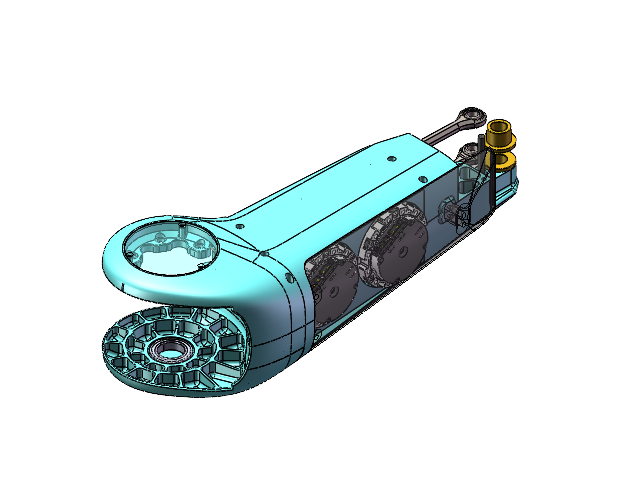
[picture p122: CAD file, 2026-10-06]
hardware/mechanical/腿部/腿部负载测试平台/cad/solidworks/小腿装配体-测试.SLDASM
RB000260 小腿电机分离块-测试
RB000261 小腿本体右-测试
RB000262 小腿本体左-测试
RB000263 小腿前盖板-测试
RB000264 小腿盖板-测试
PJ3-60-8-测试 x 2
RB000267 脚踝输出法兰-测试 x 2
RB000268 长连杆-测试
球轴承GE8C-测试 x 4
RB000269 短连杆-测试
圆柱销 5×45-测试
铜轴套（65）-测试 x 2
两面带密封圈（接触式）的深沟球轴承[60000-2RS]61804-2RS]_0224-测试
RB000270 小腿压线块2-测试
孔用钢丝挡圈16-测试 x 2
RB000271 Pitch限位-测试
