Roboparty/RP1_test/(list of files, cad)

Other CAD files:
hardware/mechanical/手臂胸腔/共用资料/cad/solidworks/手部腿部胸部支架总装.SLDASM
hardware/mechanical/腿部/腿部负载测试平台/cad/solidworks/ZAU40-M12-d6-S9.sldasm
hardware/mechanical/腿部/腿部负载测试平台/cad/solidworks/C-HLGW30-1400（右）.SLDASM
hardware/mechanical/腿部/腿部负载测试平台/cad/solidworks/VBW21-2850-R55-N70-VEW21-001.sldprt
hardware/mechanical/手臂胸腔/共用资料/cad/solidworks/YCL.M000701 罩壳.SLDPRT
hardware/mechanical/手臂胸腔/共用资料/manufacturing/cnc/YCL.M000698 接线盒安装板.STEP
hardware/mechanical/手臂胸腔/共用资料/cad/solidworks/YCL.M000699 LOGO板（胸腔）.SLDPRT
hardware/mechanical/手臂胸腔/共用资料/cad/solidworks/YCL.M000689 测试底座支架.SLDPRT
hardware/mechanical/手臂胸腔/共用资料/cad/solidworks/YCL.M000695 航插安装板.SLDPRT
hardware/mechanical/手臂胸腔/共用资料/cad/solidworks/YCL.M000694 LOGO板.SLDPRT
hardware/mechanical/手臂胸腔/共用资料/cad/solidworks/YCL.M000691 80立柱.SLDPRT
hardware/mechanical/手臂胸腔/共用资料/cad/solidworks/YCL.M000692 支架L件.SLDPRT
hardware/mechanical/手臂胸腔/共用资料/cad/solidworks/YCL.M000696 胸腔立柱.SLDPRT
hardware/mechanical/腿部/腿部负载测试平台/cad/solidworks/ZAU40-M12-d6-S9-001.sldprt
hardware/mechanical/手臂胸腔/共用资料/cad/solidworks/YCL.M000700 航插安装板（胸腔）.SLDPRT
hardware/mechanical/手臂胸腔/共用资料/cad/solidworks/RP1.3下肢-测试（左腿）.SLDPRT
hardware/mechanical/手臂胸腔/共用资料/cad/solidworks/RP1.3.1整机URDF版-胸腔.SLDPRT
hardware/mechanical/手臂胸腔/共用资料/cad/solidworks/YCL.M000690 手腿底板.SLDPRT
hardware/mechanical/手臂胸腔/共用资料/cad/solidworks/YCL.M000697 胸腔底板.SLDPRT
hardware/mechanical/腿部/腿部负载测试平台/cad/solidworks/J-WJG12-1425-003.SLDPRT
hardware/mechanical/腿部/腿部负载测试平台/cad/solidworks/E-LWAD32-D148-M30-L200.SLDPRT
hardware/mechanical/腿部/腿部负载测试平台/cad/solidworks/TCC16-0_7T.sldprt
hardware/mechanical/腿部/腿部负载测试平台/cad/solidworks/AFT15-TY-80260.sldprt
hardware/mechanical/腿部/腿部负载测试平台/cad/solidworks/VBW21-2850-R55-N70-VEW21-003.sldprt
hardware/mechanical/腿部/腿部负载测试平台/cad/solidworks/J-WJG12-1425-002.SLDPRT
hardware/mechanical/腿部/腿部负载测试平台/cad/solidworks/VBW21-2850-R55-N70-VEW21-007.sldprt
hardware/mechanical/腿部/腿部负载测试平台/cad/solidworks/ZAU40-12-6-9-002.sldprt
hardware/mechanical/手臂胸腔/共用资料/cad/solidworks/YCL.M000365 LS97腿部工装.SLDDRW
hardware/mechanical/手臂胸腔/共用资料/cad/solidworks/YCL.M000421 工装底板.SLDDRW
hardware/mechanical/手臂胸腔/共用资料/cad/solidworks/YCL.M000426 LS-97-Waist工装.SLDDRW
hardware/mechanical/手臂胸腔/共用资料/cad/solidworks/YCL.M000438 LS75手臂工装.SLDDRW
hardware/mechanical/手臂胸腔/共用资料/cad/solidworks/YCL.M000689 测试底座支架.SLDDRW
hardware/mechanical/手臂胸腔/共用资料/cad/solidworks/YCL.M000690 手腿底板.SLDDRW
hardware/mechanical/手臂胸腔/共用资料/cad/solidworks/YCL.M000691 80立柱.SLDDRW
hardware/mechanical/手臂胸腔/共用资料/cad/solidworks/YCL.M000692 支架L件.SLDDRW
hardware/mechanical/手臂胸腔/共用资料/cad/solidworks/YCL.M000693 上工装.SLDDRW
hardware/mechanical/手臂胸腔/共用资料/cad/solidworks/YCL.M000694 LOGO板.SLDDRW
hardware/mechanical/手臂胸腔/共用资料/cad/solidworks/YCL.M000695 航插安装板.SLDDRW
hardware/mechanical/手臂胸腔/共用资料/cad/solidworks/YCL.M000696 胸腔立柱.SLDDRW
hardware/mechanical/手臂胸腔/共用资料/cad/solidworks/YCL.M000697 胸腔底板.SLDDRW
hardware/mechanical/手臂胸腔/共用资料/cad/solidworks/YCL.M000698 接线盒安装板.SLDDRW
hardware/mechanical/手臂胸腔/共用资料/cad/solidworks/YCL.M000699 LOGO板（胸腔）.SLDDRW
hardware/mechanical/手臂胸腔/共用资料/cad/solidworks/YCL.M000700 航插安装板（胸腔）.SLDDRW
hardware/mechanical/手臂胸腔/共用资料/cad/solidworks/YCL.M000701 罩壳.SLDDRW
hardware/mechanical/腿部/腿部负载测试平台/cad/solidworks/RB000231_02_髋关节左（LS版）.SLDPRT
hardware/mechanical/腿部/腿部负载测试平台/cad/solidworks/RB000234_02_髋关节限位环（LS版）.SLDPRT
hardware/mechanical/腿部/腿部负载测试平台/cad/solidworks/RB000237_02_髋关节电机盖板.SLDPRT
hardware/mechanical/腿部/腿部负载测试平台/cad/solidworks/RB000239_01_髋关节左抱箍.SLDPRT
hardware/mechanical/腿部/腿部负载测试平台/cad/solidworks/RB000244 大腿盖子-测试.SLDPRT
hardware/mechanical/腿部/腿部负载测试平台/cad/solidworks/RB000245 大腿橡胶垫-测试.SLDPRT
hardware/mechanical/腿部/腿部负载测试平台/cad/solidworks/RB000246 大腿本体-测试.SLDPRT
hardware/mechanical/腿部/腿部负载测试平台/cad/solidworks/RB000247 大腿抱箍-测试.SLDPRT
hardware/mechanical/腿部/腿部负载测试平台/cad/solidworks/RB000248 Roll限位-测试.SLDPRT
hardware/mechanical/腿部/腿部负载测试平台/cad/solidworks/RB000249 Yaw限位3-测试.SLDPRT
hardware/mechanical/腿部/腿部负载测试平台/cad/solidworks/RB000250 压线块1-测试.SLDPRT
hardware/mechanical/腿部/腿部负载测试平台/cad/solidworks/RB000251 大腿下本体右-测试.SLDPRT
hardware/mechanical/腿部/腿部负载测试平台/cad/solidworks/RB000252 大腿卡箍右-测试.SLDPRT
hardware/mechanical/腿部/腿部负载测试平台/cad/solidworks/RB000253 大腿下电机抱箍-测试.SLDPRT
hardware/mechanical/腿部/腿部负载测试平台/cad/solidworks/RB000254 大腿卡箍左-测试.SLDPRT
hardware/mechanical/腿部/腿部负载测试平台/cad/solidworks/RB000255 大腿下盖板左-测试.SLDPRT
hardware/mechanical/腿部/腿部负载测试平台/cad/solidworks/RB000256 大腿下盖板右-测试.SLDPRT
hardware/mechanical/腿部/腿部负载测试平台/cad/solidworks/RB000257 大腿下本体左-测试.SLDPRT
hardware/mechanical/腿部/腿部负载测试平台/cad/solidworks/RB000258 大腿法兰-测试.SLDPRT
hardware/mechanical/腿部/腿部负载测试平台/cad/solidworks/RB000259 Yaw限位4-测试.SLDPRT
hardware/mechanical/腿部/腿部负载测试平台/cad/solidworks/RB000260 小腿电机分离块-测试.SLDPRT
hardware/mechanical/腿部/腿部负载测试平台/cad/solidworks/RB000261 小腿本体右-测试.SLDPRT
hardware/mechanical/腿部/腿部负载测试平台/cad/solidworks/RB000262 小腿本体左-测试.SLDPRT
hardware/mechanical/腿部/腿部负载测试平台/cad/solidworks/RB000263 小腿前盖板-测试.SLDPRT
hardware/mechanical/腿部/腿部负载测试平台/cad/solidworks/RB000264 小腿盖板-测试.SLDPRT
hardware/mechanical/腿部/腿部负载测试平台/cad/solidworks/RB000265 小腿脚踝分离块-测试.SLDPRT
hardware/mechanical/腿部/腿部负载测试平台/cad/solidworks/RB000266 小腿后盖板-测试.SLDPRT
hardware/mechanical/腿部/腿部负载测试平台/cad/solidworks/RB000267 脚踝输出法兰-测试.SLDPRT
hardware/mechanical/腿部/腿部负载测试平台/cad/solidworks/RB000268 长连杆-测试.SLDPRT
hardware/mechanical/腿部/腿部负载测试平台/cad/solidworks/RB000269 短连杆-测试.SLDPRT
hardware/mechanical/腿部/腿部负载测试平台/cad/solidworks/RB000270 小腿压线块2-测试.SLDPRT
hardware/mechanical/腿部/腿部负载测试平台/cad/solidworks/RB000271 Pitch限位-测试.SLDPRT
hardware/mechanical/腿部/腿部负载测试平台/cad/solidworks/RB000272 脚底十字轴-测试.SLDPRT
hardware/mechanical/腿部/腿部负载测试平台/cad/solidworks/RB000273 脚底固定一号-测试.SLDPRT
hardware/mechanical/腿部/腿部负载测试平台/cad/solidworks/RB000274 脚底固定二号-测试.SLDPRT
hardware/mechanical/腿部/腿部负载测试平台/cad/solidworks/RB000275 脚板-测试.SLDPRT
hardware/mechanical/腿部/腿部负载测试平台/cad/solidworks/RB000276 脚面-测试.SLDPRT
hardware/mechanical/腿部/腿部负载测试平台/cad/solidworks/RB000277 鞋垫-测试.SLDPRT
hardware/mechanical/腿部/腿部负载测试平台/cad/solidworks/RB000278 镜向小腿电机分离块-测试.SLDPRT
hardware/mechanical/腿部/腿部负载测试平台/cad/solidworks/RB000279 镜向小腿本体右-测试.SLDPRT
hardware/mechanical/腿部/腿部负载测试平台/cad/solidworks/RB000280 镜向小腿本体左-测试.SLDPRT
hardware/mechanical/腿部/腿部负载测试平台/cad/solidworks/RB000281 镜向小腿脚踝分离块-测试.SLDPRT
hardware/mechanical/腿部/腿部负载测试平台/cad/solidworks/RB000282 镜向长连杆-测试.SLDPRT
hardware/mechanical/腿部/腿部负载测试平台/cad/solidworks/RB000283 镜向短连杆-测试.SLDPRT
hardware/mechanical/腿部/腿部负载测试平台/cad/solidworks/RB000284 镜向Pitch限位-测试.SLDPRT
hardware/mechanical/腿部/腿部负载测试平台/cad/solidworks/RB000285 镜向大腿下本体右-测试.SLDPRT
hardware/mechanical/腿部/腿部负载测试平台/cad/solidworks/RB000286 镜向大腿卡箍右-测试.SLDPRT
hardware/mechanical/腿部/腿部负载测试平台/cad/solidworks/RB000287 镜向大腿下本体左-测试.SLDPRT
hardware/mechanical/腿部/腿部负载测试平台/cad/solidworks/RB000288 镜向大腿卡箍左-测试.SLDPRT
hardware/mechanical/腿部/腿部负载测试平台/cad/solidworks/RB000289 镜向大腿下电机抱箍-测试.SLDPRT
hardware/mechanical/腿部/腿部负载测试平台/cad/solidworks/RB000290_01_髋关节橡胶盖板.SLDPRT
hardware/mechanical/腿部/腿部负载测试平台/cad/solidworks/RB000292 膝盖轴承座-测试.SLDPRT
hardware/mechanical/腿部/腿部负载测试平台/cad/solidworks/RB000365 LS97腿部工装.SLDPRT
hardware/mechanical/腿部/腿部负载测试平台/cad/solidworks/RB000377 铁平台.SLDPRT
