Roboparty/RP1_test/test-cases/whole-body/SYS-REL-004-high-temperature-operation.md

# SYS-REL-004 整机高温运行

阶段：DVT。执行时同时遵循 [公共规则](../common.md)。

## 目的

验证高温下持续运动、头部功能、降额策略与电池边界。

## 条件与设备

- ≥3台，含30自由度交互头热最坏配置，覆盖两种头部；核对电芯、BMS、关节及头部器件允许温度；完成23 ℃ F2热基线，温度传感器校准、硬件保护有效。
- 设备：步入式环境箱、不承重吊挂、热电偶/热像、采集及烟雾/气体监测。

## 步骤

1. 断电升至40±2 ℃，升降温≤1 ℃/min；关键内部测点变化连续1 h≤2 ℃后，保持至高温总暴露≥2 h。
2. 使用SOC≥95%且温度合规的电池，带电运行2 h；每30 min覆盖额定速度及额定负载片段，期间不充电、不换电。
3. 交互头持续高亮显示、摄像与音频；运控头施加等效通信负载。
4. 降至23±5 ℃，恢复2 h，执行F0～F2。通过后可另做45±2 ℃、2 h工程摸底，结果单列。

## 记录

关键温度、单体压差/SOC、功耗、风扇、降频/扭矩降额、保护触发及运动/音像性能。

## 通过与中止

- 40 ℃连续运行2 h，无安全事件、不可恢复故障或非预期保护停机；允许降额须符合冻结策略，试后符合冻结性能判据。
- 电池/器件越限、异常气体、失稳或温升失控立即停机；不得屏蔽BMS、温度传感器或降额保护。
