Roboparty/RP1_test/software/host/docs/LOCAL_CONTROL_BUILD.md

# 桌面源码与本地 PLC 控制构建

本目录是本地源码和新 deb 的统一输入。`tools/build_local_deb.py` 从其所在
`host/` 读取源码、配置、启动器和许可文件，不读取旧安装目录的源码，不从网络拉取代码。
版本 `packaging/LOCAL_VERSION` 为 `2.0.9+ubuntu24.04`。
平台前后端、数据库及历史记录独立保留。

## PLC 能力与配置

`factory_hmi/config/plc_cabinet.yaml` 使用现场已确认的
`driver: modbus_tcp`、`access_mode: control`、`192.168.137.10:502`、Unit ID 1。
本版控制要求 LFD835 Host Protocol V1.2（0x0102），V1.0（0x0100）与 V1.1（0x0101）仅可监控；未知版本拒绝。
界面提供总使能/停止、通道控制、PS1 设定值、故障复位和 AllStop。
协议身份/版本校验、控制键、心跳、事务序号确认、物理许可和原启停联锁均保留。
连接控制模式会发送控制心跳及全部输出请求关闭的安全初始化，随后等待操作员启动。
连接不是只读动作；实物负载控制需在现场确认安全状态后验收。
`access_mode: monitor` 仍受底层只读保护，禁止所有写入。
实机入口使用物理 SocketCAN；离线入口仍禁用 CAN。PLC 的 Modbus TCP 控制不依赖 CAN。

## 相对 YAML

主配置引用为 `config/plc_cabinet.yaml`，模块引用例如 `left_arm_motors.yaml`，
导入文件为 `uploaded/文件名.yaml`。网关预览、配置列表和当前生效状态显示相对引用。
内部解析保留根目录边界检查；不存在的 YAML 返回 404，越界路径被拒绝。
启动器以其文件位置确定源码根目录，以用户状态目录为工作目录，不依赖启动时所在目录。
首次启动将模板复制到 `~/.local/state/rp1-test-hmi/config/`；以后保留用户配置。
运行后修改配置应编辑此用户目录的 `plc_cabinet.yaml`，再正常重启自己的 HMI。
旧只读安装的 `rp1-test-hmi-readonly` 状态目录不被覆盖。

## Host Protocol V1.2

协议版本以 PLC 实际返回的 HR1 为准，整帧读取 HR0～31 共 32 Word。
新增 HR28～31 的反馈有效位、真实状态序号、供电周期和反馈年龄；TCP 轮询成功
不能替代真实 PS1 状态推进。人工锁、恢复耗尽或反馈过期时拒绝输出请求。
HR21/22 继续提供复位序号与最终结果，复位只清除 PLC 控制故障，
PS1 通信及设备故障独立保留。控制连接在第一次写入前检查版本，旧 PLC 不降级控制。

CH1～CH4 电压 HR12～15 为 0.001 V/计数，50000=50.000 V；
VS1～VS4 实测电压 0～50 V 对应变送器输出 0～10 V。电流为 0.001 A/计数、0～50 A。
旧用户 YAML 的 100 V 上限不再放宽 VS 有效范围。
顶部故障横幅汇总电机与柜内故障，FaultCode=0 不抵消 PS1 故障。
详细契约见随包提供的 `HOST_MODBUS_TCP_PROTOCOL_V1.2.md`。

配套 PLC V1.5 尚无 TIA 编译及现场联调证据。通信阶段默认 10.4 秒预算与 PLC
离线替身 11.4 秒反例仍待两端统一；恢复和人工锁解除契约尚未闭合。
安装此包不会解决这些 PLC 端卡点，不放宽期限或互锁，也不下载 PLC 程序。

## 实时趋势自动缩放

电压/电流图按最近 300 个样本中已勾选通道的有效值自动计算纵轴，不固定为全量程。
范围留出余量，最小显示跨度为 1 V / 0.2 A；小幅变化时保持刻度稳定，数值越界立即扩展，
历史峰值退出显示窗口后缩小。标题显示当前自动范围。只看某路波动时可取消其它 CH 图例的勾选。
通道筛选仅影响图形，不修改 PLC 请求。无效、非有限及超出 0～50 V/A 工程范围的样本断线显示，
不画成零、不参与缩放。各通道合法的零值仍计入范围，不隐藏关断通道的真实变化。

## 从桌面源码构建

在项目根目录运行：

```bash
python3 host/tools/build_local_deb.py --runtime-dir host/.local-runtime
```

`.local-runtime` 是已验证的 Python 3.12 离线发布运行库，不是应用源码；需事先准备，
或通过 `--runtime-dir` 指向本机已有运行库。运行库和 `dist/` 均被 Git 忽略。
输出在 `host/dist/`，包含 deb、SHA256SUMS、build-report.json 和包内 source-manifest.json。
固定输入时间戳由 SOURCE_DATE_EPOCH 控制；构建不启动应用或设备，无安装后自动运行脚本、
systemd 服务、免密提权规则、账号密码、私钥或现场采集 CSV。
包内包含受限 CAN 助手和需管理员认证的 polkit 动作，安装不会启动硬件。

## 启动桌面源码

在项目根目录运行 `./host/start-hmi.sh`；它使用本目录源码及 `.local-runtime` 离线依赖。
依赖已安装时：`python3 host/launch.py`。
使用离线运行库时：`python3 host/launch.py --runtime-dir host/.local-runtime`。
该命令读取实机控制配置；退出会执行原有受控停止流程。
默认网关为 `127.0.0.1:8766`，不要与旧安装同时占用同一端口。
可用 `python3 host/launch.py status` 查看本入口状态，用 `python3 host/launch.py stop` 停止本入口。

仅软件验证请运行：

```bash
python3 host/launch.py --runtime-dir host/.local-runtime --offline-check --gateway-only --duration 2 --port 18769
PYTHONPATH=hmi QT_QPA_PLATFORM=offscreen python3 -m pytest host/tests -q
```

离线模式使用专用 mock 配置与状态目录，平台连接为空，不访问实物 PLC；默认验证控制模式。
支持 `--offline-access monitor` 验证只读拒绝写入。回归测试需在已安装 pytest、Qt 等
测试依赖的 Python 3.12 环境运行；发布运行库不包含完整测试工具。
本次同步及构建验证只使用 mock/fake transport，未启动现场控制、使能、启停或 CAN 操作。
真实负载的动作效果、急停回路和失联停止需由现场人员完成验收。

## PS1 键盘输入修复

电压、电流输入草稿在状态轮询时保留；范围或步长只有变化时才重新设置。
点击应用会在界面线程提交文本并捕获数值，再交给后台请求；编辑本身不写 PLC。
旧设定确认不能清除之后的编辑；只读、断线、运行中及命令待确认的禁用条件保留。
离线验证：`python3 host/tools/verify_setpoint_input.py --runtime-dir host/.local-runtime`。

## 物理 CAN 连接

图标名称统一为 `rp1-test-hmi`。实机入口调用 root 所有的
`/usr/lib/rp1-test-hmi/factory-hmi-can-helper`；助手以隔离 Python 模式运行，
固定读取 `/etc/rp1-test-hmi/can-policy.yaml`，拒绝用户环境替换策略文件。
策略允许 can0–can3 和原有安全速率集合，排除 lin0/lin1 和其它接口。
配置接口需正常管理员认证，不安装免密 polkit 规则或 sudoers 项。
当前左臂模板为 can0 / CAN FD，默认仲裁速率 1 Mbit/s、数据速率 5 Mbit/s。
“连接 CAN”只配置接口；扫描、使能及运动仍是独立操作。
离线回归：`python3 host/tools/verify_can_support.py --runtime-dir host/.local-runtime`。
已运行的网关需正常重启才会加载新入口；有 PLC 供电或测试时先由现场完成正常停止。

## 电机 SDK 依赖修复

本版电机 SDK 按桌面 `host/motors/` C++ 源码重新编译，配套
Ubuntu Noble 的 spdlog 1.12 / fmt 9 库，避免旧运行库中的 fmt 8 ABI 混用。
来源、输入源码摘要与运行库摘要记录在 `packaging/native-sdk-runtime.json`。
`tools/build_local_deb.py` 在组装包前必须通过真实 `motors_py` 加载检查；
该检查按网关导入顺序加载 NumPy、后台模块和 SDK，校验驱动 API 与实际加载的依赖，
不创建电机驱动、不打开 CAN 总线、不执行扫描、使能或运动。
离线验证：`python3 host/tools/verify_native_sdk.py --runtime-dir host/.local-runtime`。
修复 SDK 加载不等于电机硬件扫描或反馈验收完成，实物反馈需现场独立核验。

## 故障提示

全局故障同时显示实际停机异常和最高严重度诊断。共享总线的 critical 诊断
优先于单个电机的位置跟踪 warning，原反馈超时与联锁阈值保持不变。

## 跨模块标零并发

标零等阻塞式原生维护调用在 C++ 执行期间释放 Python GIL，让其它模块的控制及刷新线程继续调度。
每个模块已有的后端锁、租约及 CAN 接口独占规则保留；标零仍等待原硬件反馈，不缩短等待时间。
原生测试目标 `motors_py_testing` 复用生产绑定，创建不含任何 CAN socket 的 C++ fake motor，
验证一台 fake 标零等待 1 秒期间另一台 fake 的命令与反馈读取持续进行；测试模块不随安装包分发。
构建验证参数为 `tools/rebuild_native_sdk.py --verify-concurrency`。

## 两个窗口共同控制 PLC

所有窗口连接同一个网关，共享一个 PLC 客户端、完整指令映像和状态机。
CAN 工位仍按各自接口控制电机；主回路和 PS1 共用，总停止/全部停止会影响全部工位。
两个窗口都保留总控、CH1～CH4、PS1 设定和故障复位操作，没有固定主控窗口。

普通指令按后端取得锁的顺序接受。请求必须携带窗口标识、唯一请求标识、
页面已观察到的网关实例与控制版本；版本过期或共享指令尚未完成时返回 HTTP 409，
同时附带最新共享状态。请求不会排队，也不会在刷新后自动补发。
因此两个窗口同时发相反指令时，只执行先接受的合法操作，另一个窗口核对最新状态后再操作。
请求标识相同且内容相同的重复提交返回原请求结果，不再次写入；内容不同会被拒绝。
正常总停止遵守共享指令确认联锁；需要打断正在执行的操作时使用“全部停止”。
全部停止不受旧版本或本窗口待处理请求阻挡，取消原指令，并保持所有输出请求关闭。
软件请求仍需等待网关线程和 PLC 通信处理，不能代替物理急停。

每张页面显示操作来源、请求执行状态，并轮询同一份 PLC 状态。
状态响应带单调序号，晚到的旧响应不能覆盖新画面；网关重启前的普通指令被拒绝。
“提交成功”和“PLC 已确认”分开表达；通道切换等待实际 ChannelPermit，全部停止等待输出关闭反馈。
冲突请求的拒绝状态不会覆盖另一条指令的 pending/confirmed 反馈。
本窗口尚未提交或被拒绝的电源草稿保留；另一窗口的确认不能清除这些草稿。

相关代码：`plc/coordination.py`（原子协调、幂等、回执），`plc/service.py`（共享锁、确认检查），
`gateway/app.py` 与 `gateway/schemas.py`（全部 PLC 写接口统一入口），`client.py`（请求版本），
`desktop/plc_page.py`（旧响应过滤与共享回执），`plc/state_machine.py`（待确认联锁与通道反馈）。
操作与请求审计分别只保存在本机 `data/plc/operations.jsonl`、`data/plc/requests.jsonl`。
幂等记录在当前网关实例内保留最近 256 个请求，普通旧请求还受实例/版本校验保护。
所有窗口必须使用同一个网关；本机制不协调两台独立网关同时写同一台 PLC。
旧客户端缺少请求上下文会被拒绝，升级需要同时更新客户端和网关。

离线回归：`tests/test_plc_multiwindow*.py` 覆盖同时发令、过期状态、重复请求、
跨窗口停止、实际反馈确认、写入回复丢失、确认超时和两个实际 Qt 页面的状态同步。
这些测试使用 mock PLC，未执行现场负载验收。

## 默认位回位与指令检查（2026-10-09）

- 回默认位：第 1 秒用 `kp_scale=0.5` 从实测位置平滑接近 YAML 默认位；随后用 `kp_scale=1.0` 保持默认位 2 秒。两个阶段 `kd_scale=1.0`，总时长 3 秒，结束后恢复位置保持。健康连接不重复使能。
- 回位期间每 50 ms 检查反馈错误、非有限位置和反馈超时；故障时中止并执行失能，不能把失败回位标为完成。
- 已通过认证与租约检查的软件失能/断开请求，先向本窗口回位发出取消信号，再按原队列执行失能/断开。取消信号不会启动电机或清错。
- 失能/断开会让此前排队的电机指令失效，返回 HTTP 409；不会在停机后继续执行旧回位、使能或启动请求。
- 回位失败时界面明确显示未完成，取消时显示由失能/断开中止。
- 2026-10-12 后续修正：故障复位已拆成独立的保持失能流程，清错后必须取得新反馈；回默认位不再隐式清错或使能。操作顺序、接口、验证和现场边界见 [电机故障恢复](MOTOR_FAULT_RECOVERY.md)。
- 软件验证采用 FakeMotorBackend 与内存 ASGI 网关。未执行真实 PLC/CAN 启停、清错或运动验证；配置与 SDK 未修改。

## 勾选记录与平台身份

开始测试必须选择测试用例；没有正式用例时选择“其他”，并填写测试名称、实际对象和工位。
采集 CSV 保留在本机 records 目录，结束后生成本地报告、汇总和历史记录，不自动上传。
提交前必须核实测试人、实际工位、人工结论与本次备注；测量数据不可编辑。
用户显式提交后，通过 `reliability_v1` 专用归档接口集中保存 CSV，失败或中断可继续上传。
核实修正、归类与重新分析追加版本。“其他”可以先归档查看曲线，补齐正式用例与执行上下文
并获批准后才进入正式统计。账号权限审批与测试数据审批相互独立，允许按现有权限自审。
不虚构 MP-01 等现场工位编号。

选择平台测试档案时，桌面显式发送 `recording_scope=platform` 和档案的 `bench_id`。
此时必须提供完整、有效 UUID 格式的 campaign/cycle/segment/asset/configuration/
测试用例版本/station 上下文，以及合法样机编号和 bench_id；上下文数据库一致性仍由平台校验。
档案不完整时即使未登录也阻止开始，不会静默降级为本地记录。平台记录仍须独立提交和审批，
本地完成不表示进入正式统计。顶部固定栏第一行是平台登录；其中“工位 ID”对应 station_id，与 bench_id 不是同一字段。

未传 recording_scope 的旧客户端：有平台关联 UUID 时按平台记录校验，无平台关联 UUID 时按本地记录处理。
record=false 保持原来的不记录行为。只运行 fake 电机、内存网关和 Qt offscreen 测试，未操作实物。

## 桌面名称、图标与反馈显示（2.0.5）

Qt 的应用名、显示名、桌面文件标识及 X11 WM_CLASS 统一为 `rp1-test-hmi`，
与包内 `.desktop` 文件及系统图标名称一致，使用现有 RP1 蓝色图标。
应用菜单及运行中的任务栏图标不再显示为 Python 解释器；窗口仍保留模块和 CAN 信息。
安装后可在应用菜单搜索 `rp1-test-hmi`，右键固定到任务栏。

电机尚未收到反馈（反馈时间戳为零或无效）时，监控显示“未收到电机反馈”，
反馈延迟显示“—”；未证实的零故障码不显示为驱动器健康证据。
已收到过反馈但超过原有 200 ms 门限时显示“通信反馈超时”。
已有电机报警和软件诊断保留，扫描、使能、通信和安全联锁逻辑不变。
此显示修复不能恢复 USB/CAN 链路，也不能清除 PLC↔PS1 通信故障。

## 2.0.6 安装范围

本地包包含本工作区 HMI 源码、离线运行库、PLC V1.2 契约和电机故障恢复说明。
电机清错使用独立的“复位电机故障”入口，确认新反馈后仍保持失能；使能和回默认位
须显式执行。详见 `MOTOR_FAULT_RECOVERY.md`。

此段记录 2.0.6 的安装范围。当前候选包不部署平台前后端或数据库；当前归档、曲线和审批
需要平台迁移至 0040，并启动 API 与归档 Worker。服务端未升级时不能把提交失败视作审批完成。
原始 CSV 保留本地副本，核实并显式提交后允许集中归档。
安装不会重启已有 HMI/网关，已有进程仍运行原版本；现场完成正常停止后再退出并重开，
客户端与网关应一起更新。用户配置和本地记录保留，不以模板覆盖。
