Roboparty/RP1_test/test-cases/whole-body/SYS-REL-002-walking-aging.md

# SYS-REL-002 整机行走循环老化

阶段：DVT。执行时同时遵循 [公共规则](../common.md)。

## 目的

在长距离与反复转向中暴露步态失稳、关节磨损、线束问题和热累积。

## 条件与设备

- 参考样本为24运控×2、30交互×1；最终覆盖见[执行前参数清单](../open-items.md)。完成空载F2及紧固/磨损标记。
- 跑道含直线、左右转弯、启停、小坡度或不同摩擦面；吊挂不承重、不干扰步态。
- 设备：闭环跑道、吊挂/软限位、距离计、高速视频与采集。

## 步骤

1. 累计50 km，单电池连续段≤1.5 h；覆盖0.35/0.7 m/s及能力范围内的前行、后退/侧移、转弯和受控停止。
2. 每5 km执行30次原地转向，累计≥300次姿态循环；每10 km执行F1与磨损、间隙、零位检查。
3. 换电按[013](SYS-REL-013-battery-hot-swap.md)的安全姿态续接；温度接近上限时停机并按批准方式冷却，暂停单独记录。
4. 试后在相同工况复测速度、动态稳定、零位、重复性、功耗和噪声。

## 记录

距离、速度、步数、滑移、跌倒/吊挂接触、IMU、能耗、脚底磨损；关节温度/误差/零漂及通信与保护事件。

## 通过与中止

- 达到里程与次数，无不可控倒地、裂纹、松脱或关键功能丧失；试后速度和动态稳定能力≥基线90%，其他项满足冻结判据。
- 连续3次同类步态失败、吊挂承重、温度持续上升、保护越限或碰撞时暂停；闭环前不得以降速或放宽保护继续。
