Roboparty/RP1_test/test-cases/whole-body/SYS-REL-013-battery-hot-swap.md

# SYS-REL-013 双电池与热插拔耐久

阶段：DVT。执行时同时遵循 [公共规则](../common.md)。

## 目的

验证主/备电接管与反复换电，区分整机任务耐久、连接器机械寿命及电池循环寿命。

## 条件与设备

- 24运控×2、主电池12包、备电12包、充电器6套；冻结电池/连接器/BMS版本，电芯覆盖≥2批次。
- 冻结N_live＝目标寿命换电次数×覆盖系数及电气判据。设备：循环架、插拔夹具、母线采集、热像、充放电与防火隔离。

## 步骤

1. 在批准的安全站立/空闲姿态换电，覆盖低/中/高SOC，执行N_live次；验证备电接管、母线波动、重启与恢复。
2. 在20/50/80/100%进度检查磨损、锁止、温升、接触电阻并执行F1。
3. 按批准方法验证过流、欠压、防反接及高/低温充电联锁；短路用限能、远程装置，不在机器人内无控制短接。
4. 连接器额定机械插拔寿命、电池循环寿命独立测试；整机任务次数不能代替部件寿命。结束后安装复测。

## 记录

母线1 kHz波形、备电电流/SOC、单体压差、接触电阻/温升、插拔力、锁止、异常重启和保护事件。

## 通过与中止

- 达N_live，无非计划重启、危险姿态、电弧损伤或锁止失效；错误电池或未锁止不得正常运行，BMS/充电联锁及母线、部件性能达到冻结判据。
- 端子变色/熔化、异常温升、鼓胀、泄漏、烟雾或保护失效时立即停测隔离；不得在未批准动态行走中人工换电。
