Roboparty/RP1_test/test-cases/whole-body/SYS-REL-016-loaded-walking.md

# SYS-REL-016 整机负载行走循环老化

阶段：DVT。执行时同时遵循 [公共规则](../common.md)。

## 目的

在相同路线叠加持续负载，验证步态裕量、夹具、关节温升与磨损。

## 条件与设备

- ≥3台，优先24运控、28运控、30交互；额定负载F2基线，固定质量、位置、重心、夹具及二次防坠。
- 沿用[002](SYS-REL-002-walking-aging.md)跑道与不承重吊挂；增加负载夹具、防坠，配距离计、视频及采集。

## 步骤

1. 全程批准负载，累计50 km；单电池连续段≤1.5 h，覆盖0.35/0.7 m/s及批准的方向、转弯、启停动作。
2. 每5 km执行30次原地转向＋10次批准姿态动作；50 km累计300次转向＋100次附加动作，目标≥400次姿态循环。试前固定附加动作及计数定义。
3. 每10 km执行F1并检查夹具、防坠、脚底、间隙、零位、异响和线束。
4. 按[013](SYS-REL-013-battery-hot-swap.md)安全姿态换电；接近温度上限时暂停冷却，记录连续运行时间；试后在相同负载复测。

## 记录

负载/夹具、距离、速度、步数、滑移、跌倒/吊挂接触、IMU、磨损、能耗；温度、误差、零漂、通信及保护。

## 通过与中止

- 达冻结里程及循环，无倒地、掉载、松动、裂纹或关键功能丧失；带载试后速度/动态稳定≥基线90%，其他项满足冻结判据。
- 连续3次同类步态失败、负载移位、吊挂承重、保护越限、持续温升或碰撞时暂停；闭环前不得减载、降速或放宽保护继续。
