Roboparty/RP1_test/test-cases/whole-body/README.md

# 整机测试方法

18 项 RP1 整机方法草案的条件和实施方式见 [用例索引](../README.md)。

文件名为 `SYS-REL-编号-英文名称.md`，用例 ID 不因排序变化而改号。各文件保留目的、条件与设备、步骤、记录，以及通过与中止要求。

执行时配套使用 [公共规则](../common.md)、[检查与执行记录](../checklist.md) 和 [执行前参数清单](../open-items.md)。批准的检查分级、测法和判据随执行版本保存。

[返回测试方法](../README.md) · [项目首页](../../README_CN.md)
