Roboparty/RP1_test/test-cases/checklist.md

# 检查与执行记录

本表用于保存试前基线、阶段检查、试后复测及改进复测。复制一份到本次运行资料目录填写，照片、日志和校准记录与该运行一同保存。

**F0～F3 的具体分级、测法及阈值尚待项目负责人批准。** 下表提供记录字段和测量说明，不为现有用例补造批准判据。等级、判据或必要测法未确定时，结论填写“待确认”，不据此给出通过结果。

## 运行信息

| 字段 | 本次填写 |
| --- | --- |
| 用例 ID、方法版本或 Git 提交 |  |
| 执行编号、样机匿名编号、检查阶段 |  |
| 日期、执行人、复核人 |  |
| 自由度、头部、硬件/BOM 及固件/软件版本 |  |
| 负载质量/位置/重心、地面/路线、夹具 |  |
| 电池/BMS 版本、SOC、环境温湿度 |  |
| 本次使用的 F0～F3 定义、判据文件及批准记录 |  |
| 参数依据：文件/标准编号、版本、条款或项目试验依据 |  |
| 测量仪器、测点、校准记录与采样设置 |  |
| 试前基线记录、原始数据、照片/视频目录 |  |

参数为项目自定时写明依据；引用标准时记录准确版本和条款。数值相似不能作为符合标准的证明。

## 检查与复测

每行填写实际测点、方法和单位；同一项目需要多个测点时复制该行。试前与试后使用相同配置、负载、姿态和测法，偏差另行记录。以下测法说明是填写指引，具体实施方法需纳入本次批准的检查方案。

| 检查项/测点 | 等级/阶段 | 测法、工具与条件 | 单位 | 试前基线 | 本次实际值/观察 | 批准判据及来源 | 结论 | 证据/异常编号 |
| --- | --- | --- | --- | --- | --- | --- | --- | --- |
| 配置与版本 |  | 读取并比对配置、BOM、固件和软件版本 | — |  |  |  |  |  |
| 外观、紧固标记、线束与连接器 |  | 记录检查位置，目视/照片对比及采用的检查方法 | — |  |  |  |  |  |
| 关节零位/重复定位 |  | 引用设备批准的零位或定位测法，填写姿态、参考及次数 | rad / ° / mm，选定一种 |  |  |  |  |  |
| 指令/反馈误差 |  | 同时间基准计算反馈减指令，注明动作段与统计范围 | rad 或 ° |  |  |  |  |  |
| 关节/电池/器件温度 |  | 记录测点、环境温度及采样；有环境温度时计算温升 | ℃ |  |  |  |  |  |
| 供电电压/电流 |  | 注明仪表、测点及持续/峰值统计范围，区分支路与关节量 | V / A |  |  |  |  |  |
| 启动、通信、保护及恢复 |  | 按批准步骤操作，保存时序、错误码与恢复日志 | s / 次 / — |  |  |  |  |  |
| 噪声、间隙或其他退化项 |  | 填写批准测法、仪器、测点及背景条件 | 按采用测法填写 |  |  |  |  |  |
| 用例特有任务/功能 |  | 引用用例步骤与计数定义，记录目标和完成量 | h / km / 次等 |  |  |  |  |  |

结论使用“符合批准判据 / 不符合 / 待确认 / 不适用”。不适用项说明原因，缺失读数保持缺失，不能填为 0。

## 任务区间与异常

| 区间起止/时间基准 | 状态/工况 | 有效时长、里程或次数 | 异常/人工干预及处置 | 证据与复测关联 |
| --- | --- | --- | --- | --- |
|  | 主动运行、换电、冷却、检查或非计划停机 |  |  |  |

有效计数遵循 [公共规则](common.md) 和对应方法。整次结论同时考虑目标完成量、安全项、批准判据及异常闭环；软件命令结束或合成示例完成不代替测试结论。尚未冻结的项目记录到 [执行前参数清单](open-items.md)。
