Roboparty/RP1_test/test-cases/whole-body/SYS-REL-001-standing-aging.md

# SYS-REL-001 整机站立老化

阶段：DVT。执行时同时遵循 [公共规则](../common.md)。

## 目的

暴露主动站立中的热积累、电池续航、控制漂移与连接退化。

## 条件与设备

- ≥3台，优先24运控、28运控、30交互；23±5 ℃，交付配置与额定地面。
- F0/F1/F2基线；安全吊挂不承重。设备：吊挂、围栏、采集、测温、声级计及充电设施。

## 步骤

1. 每周期从SOC≥95%开始，每小时55 min主动双脚站立＋5 min小幅重心转移及空载上肢动作。
2. 到3 h、SOC 10%或BMS低电量保护，三者先到即结束；完成3个独立周期，目标有效站立9 h。
3. 周期间下电检查、自然冷却≥30 min，使用已充满且温度合格的电池；暂停不计有效时间。
4. 每周期0.5/1/2/3 h固定姿态测噪声、功耗和热变化；试后F0～F2复测。

## 记录

电压、温度、跟随误差、通信与保护事件；放电曲线、有效时长、紧固标记、脚底/线束磨损。

## 通过与中止

- 每周期均达到3 h、累计9 h；无安全事件、不可恢复故障或异常磨损，试后满足冻结判据。低电提前结束不等于完成3 h。
- 不可控姿态、重复热保护、烟雾/异味、鼓胀、温度越限或急停失效时立即安全断电；保留故障前后各≥60 s高频数据，隔离样本，根因评审后再恢复。
