Roboparty/RP1_test/test-cases/whole-body/SYS-REL-003-loaded-standing.md

# SYS-REL-003 整机带载站立与姿态保持

阶段：DVT。执行时同时遵循 [公共规则](../common.md)。

## 目的

观察持续带载对关节热、姿态裕量、负载夹具和整机续航的影响。

## 条件与设备

- ≥3台，优先24运控、28运控、30交互；23±5 ℃。
- 完成空载及额定负载F0/F1/F2；固定批准负载的质量、位置、重心与姿态。
- 设备：不承重吊挂、围栏、负载夹具及二次防坠、采集、测温与声级计。

## 步骤

1. 沿用[001](SYS-REL-001-standing-aging.md)：3 h×3周期，SOC≥95%起，3 h/SOC 10%/BMS低电保护先到即停。
2. 全程保持批准负载；每小时55 min站立＋5 min小幅重心转移、小幅屈膝等批准姿态保持动作。
3. 周期间下电检查、自然冷却≥30 min；换电、冷却和检查不计入9 h有效时间。
4. 0.5/1/2/3 h固定姿态检查噪声、功耗、热变化与夹具位移；试后带载复测。

## 记录

负载质量/位置、姿态误差、温度、电压、通信、吊挂接触与夹具状态。

## 通过与中止

- 每周期3 h、累计9 h；无负载掉落、夹具松动、安全事件或不可恢复故障，试后达到冻结判据。
- 负载移位、姿态失控、温度越限或电池异常立即安全停机；保留前后各≥60 s数据。不得卸载或减载换取通过。
