Roboparty/RP1_test/test-cases/whole-body/SYS-REL-005-cold-start.md

# SYS-REL-005 整机低温启动

阶段：DVT。执行时同时遵循 [公共规则](../common.md)。

## 目的

验证低温启动、供电、关节响应及充电联锁，观察恢复后的永久退化。

## 条件与设备

- ≥3台，含30自由度交互头，覆盖两种头部；主/备电SOC 80±5%，温度传感器正常。
- 设备：低温箱、不承重吊挂、多点测温、绝缘工具与采集。

## 步骤

1. −10±2 ℃断电放置；关键内部测点变化连续1 h≤2 ℃后，保持至低温总暴露≥2 h。
2. 箱内完成5次冷启动，每次记录自检、站立就绪及通信可用时间；前4次完成F1后受控关机。
3. 第5次启动并完成F1后，由减载渐进至额定负载，运行60 min；全程禁止低温充电。
4. 验证未达允许温度时充电被禁止；回到23±5 ℃、无凝露且干燥稳定后，执行F0～F2及正常充电验证。

## 记录

启动电压/电流、备电切换、BMS告警、启动时间、关节延迟/零位/异响、头部结霜与音像响应。

## 通过与中止

- 5次均安全启动并完成F1，末次60 min无不可恢复故障或润滑卡滞；充电联锁正确，恢复后达冻结判据。
- 电池达到放电下限、保护后无法安全站立、关节卡滞或异常机械声时停机；失败后先保存波形，不连续高频重试。
