Roboparty/RP1_test/test-cases/whole-body/SYS-REL-006-temperature-cycling.md

# SYS-REL-006 整机高低温循环

阶段：DVT。执行时同时遵循 [公共规则](../common.md)。

## 目的

通过反复温变暴露连接、密封、材料和校准稳定性问题。

## 条件与设备

- ≥3台，含30自由度交互头，覆盖两种头部；已通过单点高/低温资格或工程摸底，保护有效。
- 箱体均匀度、转换速率及样本热滞后已验证；接口、线束保持交付状态。
- 设备：可编程环境箱、不承重吊挂、多点测温与远程采集。

## 步骤

1. −10～40 ℃循环，转换≤1 ℃/min，端点各保持2 h，共5循环。
2. 每个端点稳定后上电15 min执行F1，转温阶段断电；累计带电检查2.5 h，低温端不充电。
3. 第1/3/5循环执行完整F1；交互头在带电段持续显示、摄像和音频。不得擦除凝露或临时保温，安全处置须记录偏差。
4. 结束后恢复2～4 h，执行F0～F2及连接器抽检。

## 记录

内外温差、凝露、启动、保护、零位、通信、功耗；开裂/变形/松动及屏幕贴合、镜头起雾。

## 通过与中止

- 完成5循环，无裂纹、永久变形、退针、持续凝露或不可恢复故障；端点F1及试后F2合格。重复同类暂态故障进入失效闭环。
- 温度越限、凝露漏电或通信持续中断时停测；安全恢复先断电，保持箱门关闭至温度回升。
