Roboparty/RP1_test/test-cases/whole-body/SYS-REL-007-damp-heat.md

# SYS-REL-007 整机湿热

阶段：DVT。执行时同时遵循 [公共规则](../common.md)。

## 目的

验证高湿循环后的绝缘、密封、连接与头部功能，发现凝露和腐蚀风险。

## 条件与设备

- ≥3台，覆盖两种头部，优先交互头/最高自由度；主电池按交付状态安装，绝缘与接地基线合格。
- 设备：湿热箱、电池舱局部温湿度/凝露监测、绝缘与漏电检测、采集。

## 步骤

1. 25～40 ℃、≥93%RH，12 h升温高湿＋12 h降温高湿为一循环，共2循环48 h。
2. 升降温阶段断电、禁止充电。仅在40 ℃稳定段，电池舱≤75%RH、无凝露且电池温度合规时，短时上电F1；否则全程断电，功能检查延后。
3. 每循环检查头部、关节缝隙、胸腔风道、电池舱和连接器凝露。
4. 标准环境恢复2～4 h，先外观/绝缘安全检查，再上电F0～F2；24 h后复查腐蚀及残余雾化。

## 记录

箱内及电池局部温湿度、露点/漏电/绝缘、凝露照片与水迹、音像/通信；电池外观、端子、单体压差与自放电。

## 通过与中止

- 无触电、短路、异常发热、腐蚀桥接或电池异常；恢复后性能达冻结判据，无永久雾斑、分层、密封/胶粘失效。
- 漏电、电弧、烟雾、异常气体或电池异常立即断电；凝露未消除时不得开启带电舱体或充电。
