Roboparty/RP1_test/test-cases/whole-body/SYS-REL-008-high-temperature-storage.md

# SYS-REL-008 整机高温存储后复测

阶段：DVT。执行时同时遵循 [公共规则](../common.md)。

## 目的

检查存储热应力对结构、胶粘、润滑和复机性能的影响。

## 条件与设备

- 参考样本≥3台，覆盖24运控/28交互/30交互；最终覆盖见[执行前参数清单](../open-items.md)。整机断电，移除主电池及备电。
- 备份配置/校准并禁用自动升级，记录材料初态。设备：高温箱、电池安全柜、测温与F2设施。

## 步骤

1. **无电池机身**55±2 ℃存储16 h，升降温≤1 ℃/min。
2. 主电池与备电独立按供应商45 ℃上限、SOC 30%～50%测试；持续时间另行冻结，不直接套用机身16 h。
3. 回23±5 ℃恢复≥4 h，确认内外温度稳定、无软化/渗漏/异味，再装电池，执行F0～F2及一次正常充电。
4. 24 h复查材料、音像、线束及电池自放电。通过后可另做65±2 ℃工程摸底，时长与边界另定。

## 记录

箱温/内部温度、形变、胶粘位移、润滑渗漏；电池压差、容量/内阻、外观及校准保持。

## 通过与中止

- 机身完成55 ℃存储，无永久变形、开裂、胶粘失效或连接退化；复测合格，电池达到独立批准判据。
- 支撑结构软化或电池异常立即停测隔离；未确认恢复条件前不得装配或充电。
