Roboparty/RP1_test/test-cases/whole-body/SYS-REL-009-low-temperature-storage.md

# SYS-REL-009 整机低温存储后复测

阶段：DVT。执行时同时遵循 [公共规则](../common.md)。

## 目的

检查低温存储及回温后材料、润滑、供电和功能能否恢复。

## 条件与设备

- ≥3台，覆盖两种头部及最高自由度；整机断电，电池SOC 30%～50%，禁用充电及自动唤醒。
- 设备：低温箱、绝缘包装、防凝露转移袋与测温。

## 步骤

1. −20±2 ℃存储16 h，升降温≤1 ℃/min。
2. 受控、密封回温至23±5 ℃，不得立即开袋或打开舱体，观察凝露与材料恢复。
3. 电芯>5 ℃且同时满足供应商允许充电条件后，恢复上电/充电；执行F0～F2、正常充放电、备电接管与热插拔检查。
4. 24 h复查开裂、润滑、镜头、胶粘及电池状态。

## 记录

回温曲线与凝露、结构/密封、润滑和异响；电池电压/压差/保护、校准与音像功能。

## 通过与中止

- 完成16 h存储，恢复后无永久开裂、脆断、润滑卡滞或电池异常；功能与性能满足冻结判据。
- 凝露未消除或温度不合规时延长干燥/回温；不得以强局部加热加速恢复，电池异常立即隔离。
