Roboparty/RP1_test/test-cases/whole-body/SYS-REL-011-shock.md

# SYS-REL-011 整机冲击

阶段：DVT。执行时同时遵循 [公共规则](../common.md)。

## 目的

验证瞬态冲击后电池固定、结构、连接与校准的保持能力。

## 条件与设备

- 28运控、30交互，样本量待定；关机并完成F0～F2基线，固定运动部件且不改变交付结构受力。
- 设备：冲击台、刚性夹具、三轴加速度计、高速采集与电池安全设施；预检夹具、波形、速度变化和测点。

## 步骤

1. 半正弦冲击，峰值150 m/s²、脉宽11 ms。
2. 三个正交轴正/负方向各3次，共18次；每次后检查固定及电池状态。
3. 结束后静置30 min，执行F0～F2及F3重点拆检。
4. 250 m/s²、6 ms仅作另行评审的加严试验，重新定义装夹与判据，结果单列。

## 记录

输入/响应波形、峰值、脉宽、速度变化、横向运动；电池/关节/头部固定、连接器、零偏、校准与异常声。

## 通过与中止

- 合格波形下完成18次，无结构损伤、松脱、电池移位或安全事件；复测达到冻结判据。
- 夹具/电池固定失效、结构损伤或波形失控时停台。无效波形按实验室规则处理，不继续叠加不可控破坏。
