Roboparty/RP1_test/test-cases/whole-body/SYS-REL-012-thermal-protection.md

# SYS-REL-012 热保护与降额

阶段：EVT / DVT。执行时同时遵循 [公共规则](../common.md)。

## 目的

确认散热异常、受控过载及传感器故障时，机器人能及时降额或安全停机。

## 条件与设备

- 30自由度交互头，样本量待定；已建立40 ℃运行基线。
- 书面批准注入点、持续时间和硬件极限，设置独立超温断电；夹具限制危险运动、场地清人。
- 设备：环境箱、可控风道/风扇装置、关节过载夹具、传感器模拟器、热像与远程断电。授权工程师操作，禁止无人值守。

## 步骤

1. 在23 ℃及40 ℃分别逐步降低一只或两只风扇的转速、局部阻塞风道，观察告警→降额→保护停机。
2. 对代表性高负载关节短时受控堵转/过载，持续至保护动作且不超过批准时间。
3. 模拟温度传感器开路、短路和冻结，验证故障回退策略。
4. 冷却/复位后检查恢复行为及F0～F2，不允许危险动作自动重试。

## 记录

温升斜率、告警/降额/停机时间、最高温度、扭矩/风扇变化、邻近器件受热与故障日志。

## 通过与中止

- 各故障在冻结边界内正确保护，无失控、火灾或热损伤；传感器失效不能被当作低温而继续满载，恢复后复测合格。
- 接近绝对温度限值、升温失控或姿态不稳立即独立断电；不得屏蔽保护以继续注入。
