Roboparty/RP1_test/test-cases/whole-body/SYS-REL-014-power-cycling.md

# SYS-REL-014 电源循环与异常恢复

阶段：DVT。执行时同时遵循 [公共规则](../common.md)。

## 目的

验证反复开关机和供电异常后，安全状态、配置与任务能正确恢复。

## 条件与设备

- 参考样本24运控×1、30交互×1，最终覆盖见[执行前参数清单](../open-items.md)；备份文件系统/校准，启用启动日志、看门狗和掉电保护，冻结正常关机、突断电、欠压、备电接管和恢复状态。
- N_power按目标寿命开关机频度及覆盖/加速系数确定；N_estop按任务需求与器件B10d/额定机械寿命确定。
- 设备：可编程电源、电子负载、自动上电装置、高速采集与网络故障注入。电压扰动不得超过电池和驱动绝对额定值。

## 步骤

1. 在启动、站立、音像运行和升级前/后阶段执行冻结的电源循环及异常组合；禁止关键固件写入窗口未受控断电。
2. 在10/50/100%进度执行F1，检查配置、零位、日志、时钟、网络与用户数据。
3. 执行规定急停循环；每次恢复运动必须明确复位，验证上电和异常恢复均无非指令动作。
4. 结束后F0～F2及存储健康检查。

## 记录

次数/场景、启动时间、电压/电流、备电接管、复位、日志与参数保持、文件系统/存储错误及功耗漂移。

## 通过与中止

- 达冻结次数，无不可恢复启动失败、参数丢失、文件系统损坏或安全恢复错误；性能合格。
- 重复数据损坏、急停失效、上电非指令动作或器件异常发热时停止；不得格式化或清日志掩盖失败。
