Roboparty/RP1_test/test-cases/whole-body/SYS-REL-017-tip-over.md

# SYS-REL-017 倾倒与受控跌倒

阶段：EVT / DVT。执行时同时遵循 [公共规则](../common.md)。

## 目的

检查倾倒冲击后的结构、电池固定与安全功能；动态跌倒另作工程摸底。

## 条件与设备

- 24运控、28运控、30交互各1台；交付头部/电池/外壳，断电或批准安全状态，F0～F2基线。
- 设备：可控倾倒平台、可更换地面、高速视频、吊挂释放与电池隔离；二次防护不能吸收规定冲击。

## 步骤

1. 标准倾倒高度取100 mm与倾斜30°对应高度的较小值。
2. 最多4方向，每方向1次；每次检查电池、结构和外露危险，合格后再转下一方向。
3. 结束后执行F0～F2及F3重点拆检。
4. 动态跌倒须另行批准，软/硬地面、低到高分级并另设判据；改进后复测最不利方向。

## 记录

方向、高度、地面、姿态、冲击视频；电池位移、连接/结构损伤、危险边缘、校准与功能恢复。

## 通过与中止

- 标准倾倒无电池危险、危险锐边、带电部件暴露或不可恢复故障；试后满足冻结判据。
- 结构/电池损伤立即停止隔离，确认前不充电；更换安全结构件的样本不得记作“无故障通过”。动态摸底结论单列。
