Roboparty/RP1_test/test-cases/whole-body/SYS-REL-020-dynamic-motion.md

# SYS-REL-020 快速动态运动与跑步

阶段：DVT。执行时同时遵循 [公共规则](../common.md)。

## 目的

通过峰值动力、制动和反复动态动作，检查控制裕量、冲击与热负荷。

## 条件与设备

- ≥3台；最高速度、加/减速、转弯、路线、地面摩擦和停止距离已评审，先做分级预检查。
- 设备：封闭场地、不承重安全吊挂、高速视频、加速度/力采集与远程急停。

## 步骤

1. 每周期30 min：5 min热身＋20 min快速动态混合动作＋5 min恢复/受控停止。
2. 20 min动作段执行批准速度、转向及制动组合，避免用超能力动作代替冻结任务谱。
3. 冷却、检查或吊挂承重时暂停计时；恢复后续接被中断动作段。
4. 结束后检查结构、紧固、零位及F0～F2。

## 记录

目标/实际速度、加速度、停止距离、IMU、跟随误差、温度、保护事件，以及同步视频/日志。

## 通过与中止

- 完成30 min有效任务，无不可控倒地、超速、制动失效、吊挂承重或未经批准降级；试后满足冻结判据。
- 跌倒、制动/急停异常、结构损伤、过温或重复任务失败时立即暂停，闭环后再恢复。
