Roboparty/RP1_test/test-cases/whole-body/SYS-REL-021-manipulation.md

# SYS-REL-021 抓取搬运与操作循环

阶段：DVT。执行时同时遵循 [公共规则](../common.md)。

## 目的

用重复作业验证视觉定位、手臂/末端、力控、软件任务链与上肢热负荷。

## 条件与设备

- 参考配置为28自由度感知头，样本≥3台；最终样本覆盖在执行前确定。
- 固定工件质量、尺寸、材质、位姿、抓取点、料架，以及成功、重试与人工干预规则；完成手臂/视觉/力控零位及急停、防碰撞检查。
- 设备：工件集、料架/工作台、质量/位姿测量、防坠夹具、视频与采集。

## 步骤

1. 执行60 min循环：识别定位→伸手→抓取→抬升→放置→回位。
2. 每10 min切换工件或抓取位姿，覆盖冻结的作业组合。
3. 本用例记录静止抓放及工位操作；带工件行走的关联用例见[待确认项](../open-items.md)。
4. 试后复测定位、抓取、力控、动作节拍及相关F0～F2。

## 记录

尝试/成功/失败数、重试、人工接管、节拍、温度、任务状态、错误码、视频及控制日志。

## 通过与中止

- 完成60 min，成功率及人工干预达到冻结阈值；无掉物、末端失控、任务死锁或未经批准干预，试后性能合格。
- 工件掉落、防护触发、人员危险、过载/过温或不可恢复视觉/控制异常时暂停；阈值未冻结前不作通过结论。
