Roboparty/RP1_test/docs/media/test-dashboard-upper-body.jpg

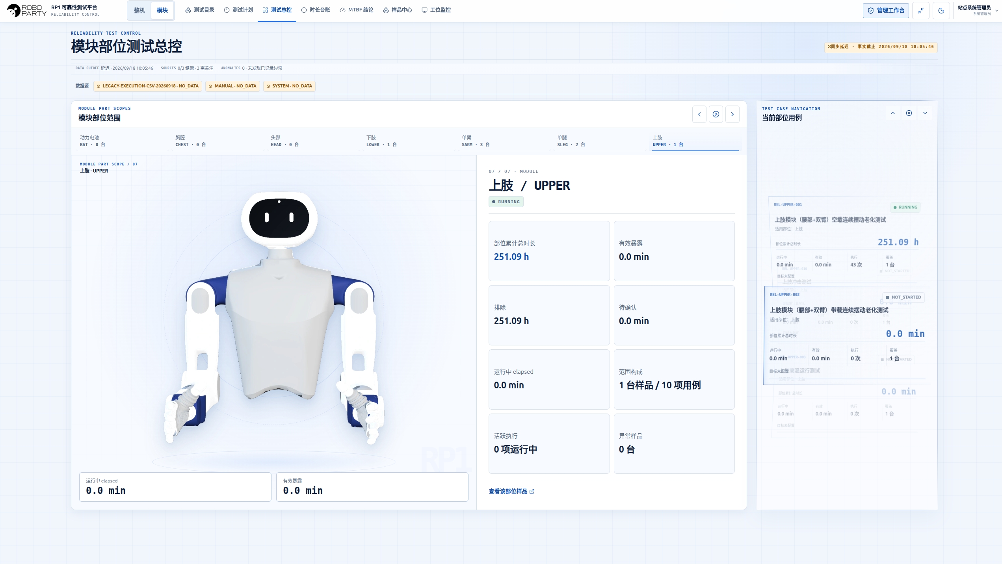
docs/media/test-dashboard-upper-body.jpg
