Roboparty/RP1_test/software/host/packaging/rp1-test-hmi.png

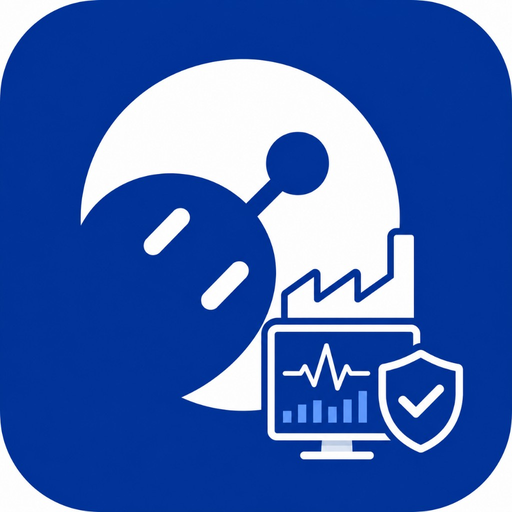
software/host/packaging/rp1-test-hmi.png
