Roboparty/RP1_test/hardware/mechanical/手臂胸腔/手臂测试平台/图纸/YCL.M000438 LS75手臂工装.PDF

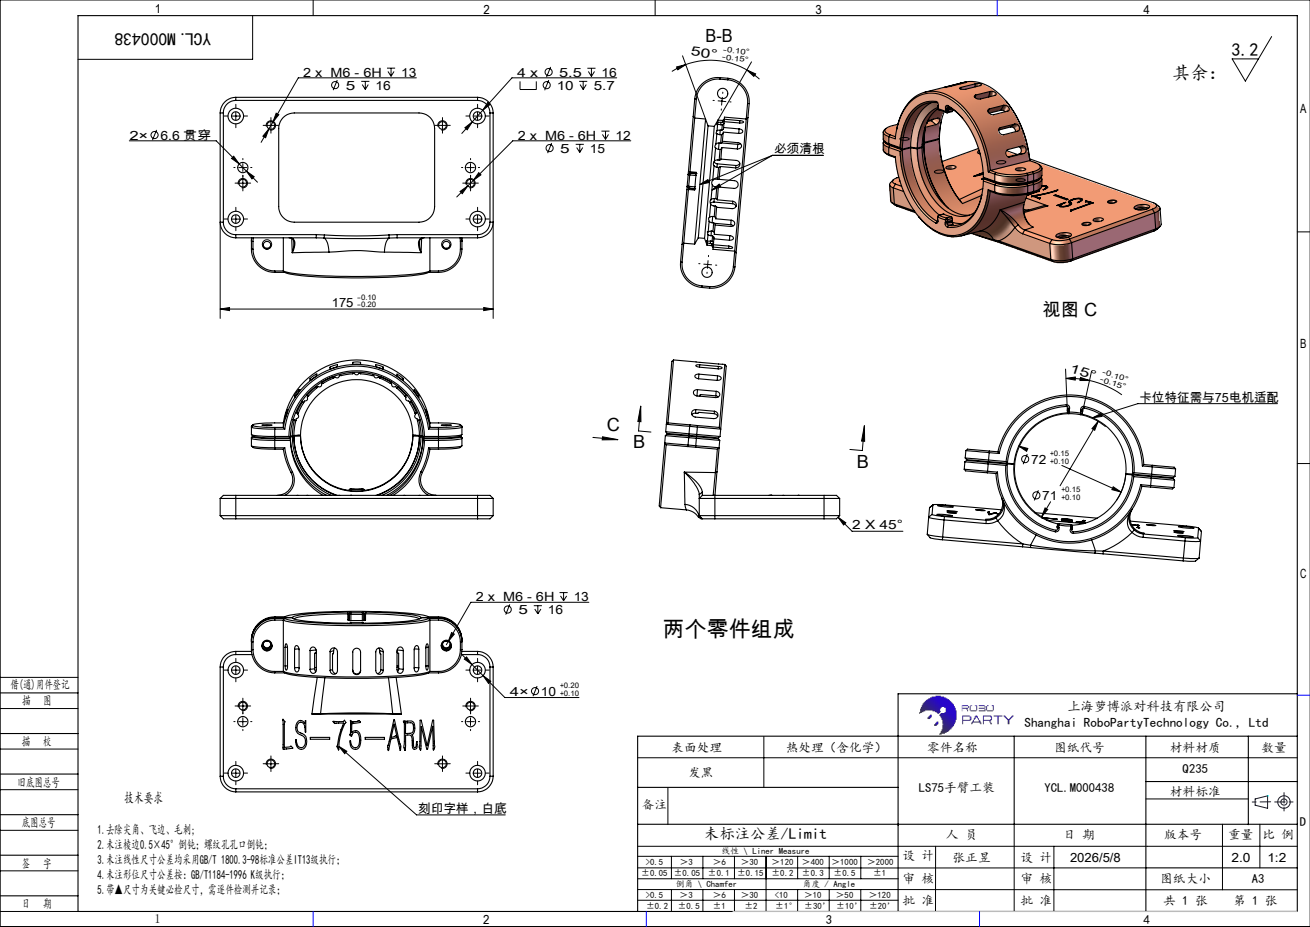
[picture p125: page 1]

Shanghai RoboPartyTechnology Co., Ltd

表面处理 | 热处理（含化学） | 零件名称 | 图纸代号 | 材料材质 | 数量
发黑 | | LS75手臂工装 | YCL.M000438 | Q235

材料标准

1.去除尖角、飞边、毛刺;
2.未注棱边0.5×45°倒钝；螺纹孔孔口倒钝；
3.未注线性尺寸公差均采用GB/T 1800.3-98标准公差IT13级执行；
4.未注形位尺寸公差按：GB/T1184-1996 K级执行；
5.带▲尺寸为关键必检尺寸，需逐件检测并记录；

未标注公差/Limit | 人 员 | 日 期 | 版本号 | 重量 | 比 例
线性 \ Liner Measure | 设 计 | 张正昱 | 设 计 | 2026/5/8 | | 2.0 | 1:2

±0.05 | ±0.05 | ±0.1 | ±0.15 | ±0.2 | ±0.3 | ±0.5 | ±1 | 审 核 | 审 核 | 图纸大小 | A3
>0.5 | ＞3 | ＞6 | ＞30 | <10 | ＞10 | ＞50 | ＞120 | 批 准 | 批 准 | 共 1 张 第 1 张
±0.2 | ±0.5 | ±1 | ±2 | ±1° | ±30’ | ±10’ ±20’

倒角 \ Chamfer | | | | 角度 / Angle
