Roboparty/RP1_test/hardware/mechanical/手臂胸腔/胸腔测试平台/图纸/YCL.M000697 胸腔底板.PDF

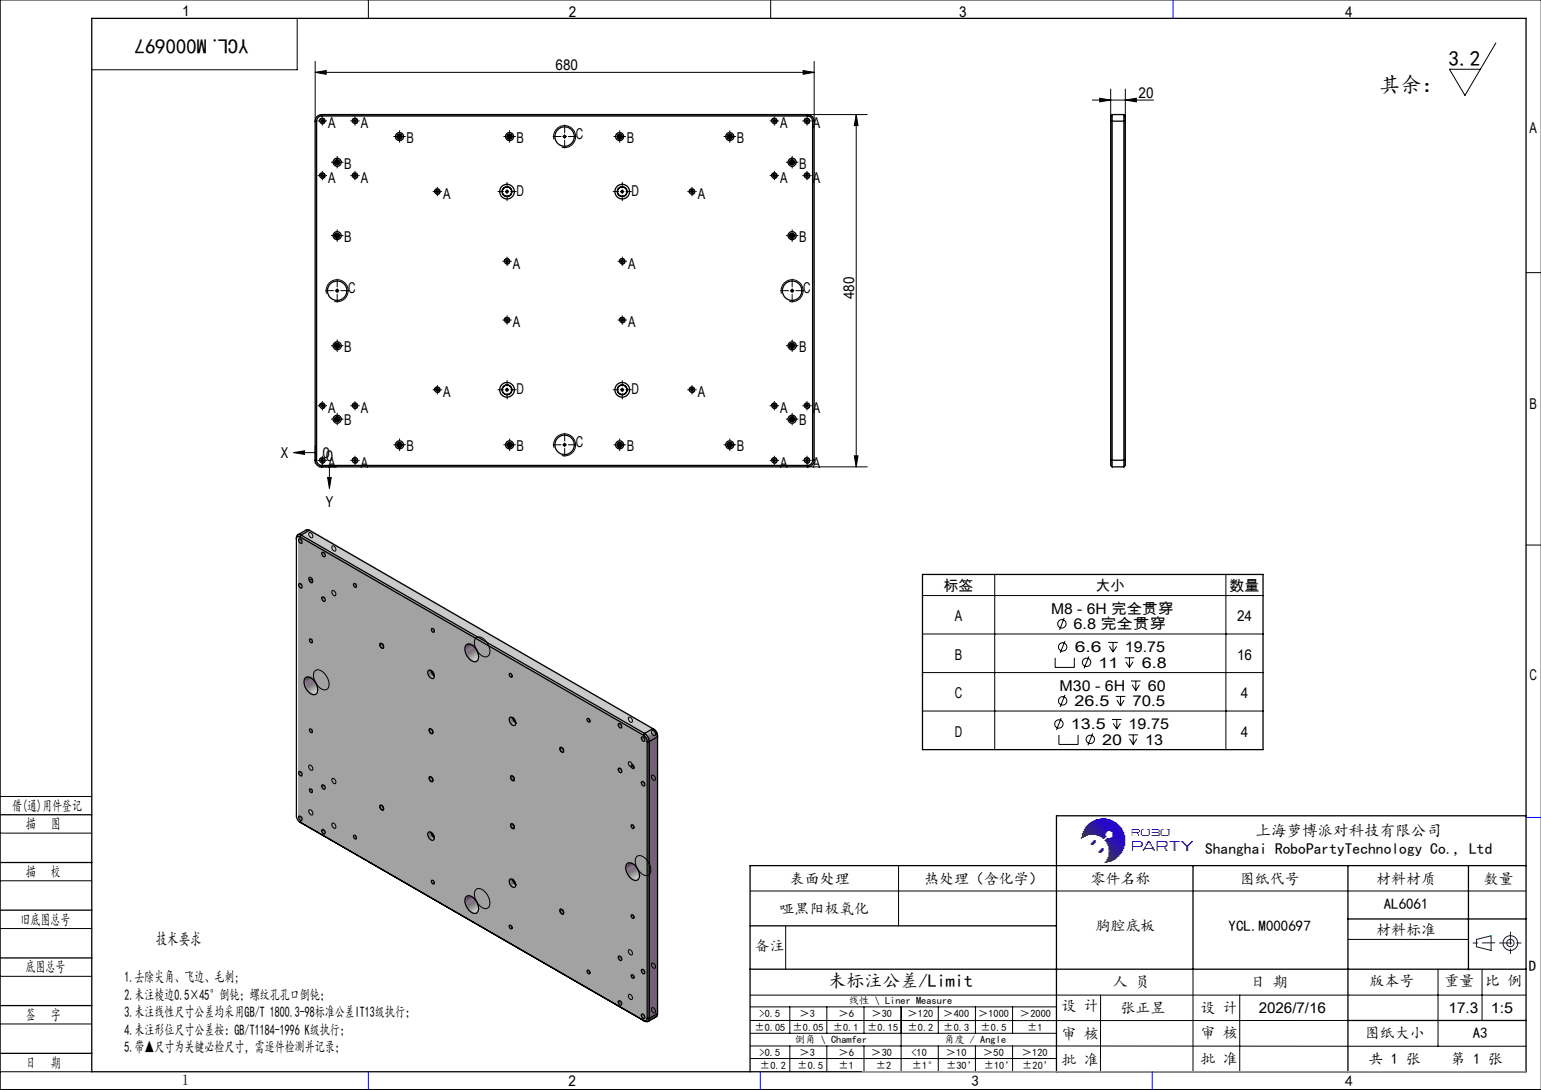
[picture p126: page 1]

标签 | 大小 | 数量
A | M8 - 6H 完全贯穿 6.8 完全贯穿 | 24
B | 6.6 19.75
C | M30 - 6H 60 26.5 70.5 | 4
D | 13.5 19.75

Shanghai RoboPartyTechnology Co., Ltd

表面处理 | 热处理（含化学） | 零件名称 | 图纸代号 | 材料材质 | 数量
哑黑阳极氧化 | | 胸腔底板 | YCL.M000697 | AL6061

材料标准

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

未标注公差/Limit | 人 员 | 日 期 | 版本号 | 重量 | 比 例
线性 \ Liner Measure | 设 计 | 张正昱 | 设 计 | 2026/7/16 | | 17.3 | 1:5

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

倒角 \ Chamfer | | | | 角度 / Angle
