Roboparty/RP1_test/software/host/factory_hmi/core/service.py

"""Session-oriented facade used by the network control gateway."""

from __future__ import annotations

import os
import json
import re
import shutil
import threading
import uuid
from datetime import datetime, timezone
from pathlib import Path
from typing import Any, Mapping, Sequence

import numpy as np

from factory_hmi.models import StationState

from ._legacy import motor_default_positions
from .backend import FakeMotorBackend, MotorsPyBackend
from .can_manager import (
    ALLOWED_ARBITRATION_BITRATES,
    ALLOWED_DATA_BITRATES,
    ARBITRATION_BITRATE,
    DATA_BITRATE,
    CanInterfaceStatus,
    CanManager,
)
from .config import load_station_config
from .controller import FactoryController
from .identity import build_execution_code, build_local_execution_code
from .report import ReportManager, ReportResult
from .zeroing import MotorZeroingSession
from factory_hmi.sync.outbox import Outbox


_SAFE_NAME = re.compile(r"[^A-Za-z0-9_.-]+")


class FactoryService:
    """Own at most one configured station and expose JSON-friendly operations."""

    def __init__(
        self,
        *,
        data_root: Path | str | None = None,
        report_root: Path | str | None = None,
        can_manager: CanManager | None = None,
        outbox: Outbox | None = None,
    ) -> None:
        root = data_root or os.environ.get(
            "RP1_FACTORY_DATA_ROOT",
            "~/.local/share/rp1-factory-hmi",
        )
        self.data_root = Path(root).expanduser().resolve()
        self.record_root = self.data_root / "records"
        self.trajectory_root = self.data_root / "trajectories"
        self.record_root.mkdir(parents=True, exist_ok=True)
        self.trajectory_root.mkdir(parents=True, exist_ok=True)
        self.report_manager = ReportManager(report_root or self.data_root)
        self.outbox = outbox or Outbox(self.data_root / "sync" / "outbox.sqlite3")
        self._lock = threading.RLock()
        self._controller: FactoryController | None = None
        self._zeroing: MotorZeroingSession | None = None
        self._backend_name: str | None = None
        self._config_path: Path | None = None
        self._last_stop_reason: str | None = None
        self._can_manager = can_manager or CanManager()
        self._can_interfaces: tuple[str, ...] = ()
        self._can_bindings: tuple[dict[str, Any], ...] = ()
        self._fake_can_connected = False
        self._report_threads: set[threading.Thread] = set()
        self._report_errors: dict[str, str] = {}
        self._record_identity: dict[str, str] = {}
        self._record_sidecar: Path | None = None
        self._live_report_context: dict[str, Any] | None = None
        recovery = threading.Thread(
            target=self._recover_existing_records,
            name="factory-report-recovery",
            daemon=True,
        )
        self._report_threads.add(recovery)
        recovery.start()

    @property
    def controller(self) -> FactoryController:
        with self._lock:
            if self._controller is None:
                raise RuntimeError("station is not configured")
            return self._controller

    def configure(
        self,
        *,
        config_path: str,
        limb: str,
        backend: str,
        bus_bindings: Sequence[Mapping[str, Any]] | None = None,
        motor_overrides: Sequence[Mapping[str, Any]] | None = None,
    ) -> dict[str, Any]:
        backend = backend.strip().lower()
        if backend not in {"motors_py", "fake"}:
            raise ValueError("backend must be motors_py or fake")
        path = Path(config_path).expanduser().resolve(strict=True)
        with self._lock:
            if self._controller is not None:
                state = self._controller.state
                if state is not StationState.DISCONNECTED:
                    raise RuntimeError(
                        f"disconnect the current station before configuring; state={state.value}"
                    )
                if self.can_status()["all_up"]:
                    raise RuntimeError(
                        "disconnect CAN interfaces before configuring another station"
                    )
            station_config = load_station_config(
                limb,
                path,
                bus_bindings=bus_bindings,
                motor_overrides=motor_overrides,
            )
            can_interfaces = tuple(
                sorted(
                    {
                        entry.interface
                        for entry in station_config.entries
                        if "can" in entry.interface_type.lower()
                    }
                )
            )
            if not can_interfaces:
                raise ValueError("station configuration has no SocketCAN interfaces")
            if bus_bindings is None:
                normalized_bindings = tuple(
                    {
                        "index": index,
                        "interface": interface,
                        "mode": "canfd",
                        "bitrate": ARBITRATION_BITRATE,
                        "dbitrate": DATA_BITRATE,
                    }
                    for index, interface in enumerate(can_interfaces)
                )
            else:
                normalized_bindings = tuple(dict(item) for item in bus_bindings)
                timing_by_interface: dict[str, tuple[object, object, object]] = {}
                for item in normalized_bindings:
                    interface = str(item.get("interface", ""))
                    timing = (
                        item.get("mode", "canfd"),
                        item.get("bitrate", ARBITRATION_BITRATE),
                        item.get("dbitrate", DATA_BITRATE),
                    )
                    previous = timing_by_interface.setdefault(interface, timing)
                    if previous != timing:
                        raise ValueError(
                            f"reused CAN interface {interface} must use identical timing"
                        )
            if backend == "fake":
                initial = motor_default_positions(
                    station_config.raw,
                    station_config.limb,
                )
                motor_backend = FakeMotorBackend(
                    station_config.entries,
                    initial_positions=initial,
                )
            else:
                motor_backend = MotorsPyBackend(station_config.entries)
            self._controller = FactoryController(
                station_config,
                motor_backend,
                enable_recording=False,
            )
            self._zeroing = None
            self._backend_name = backend
            self._config_path = path
            self._last_stop_reason = None
            self._can_interfaces = can_interfaces
            self._can_bindings = normalized_bindings
            self._fake_can_connected = False
            return self.snapshot()

    def clear_configuration(self) -> dict[str, Any]:
        """Safely stop hardware and remove the active station configuration."""

        with self._lock:
            if self._controller is not None:
                self._controller.disconnect()
            if self._backend_name == "fake":
                self._fake_can_connected = False
            elif self._can_interfaces:
                self._can_manager.disconnect(self._can_interfaces)
            self._controller = None
            self._zeroing = None
            self._backend_name = None
            self._config_path = None
            self._last_stop_reason = None
            self._can_interfaces = ()
            self._can_bindings = ()
            self._fake_can_connected = False
            return self.snapshot()

    def _can_payload(
        self,
        statuses: list[CanInterfaceStatus],
    ) -> dict[str, Any]:
        interfaces = [status.to_dict() for status in statuses]
        expected = {
            str(item["interface"]): item
            for item in self._can_bindings
            if item.get("interface")
        }

        def healthy(status: CanInterfaceStatus) -> bool:
            binding = expected.get(status.interface)
            if binding is None:
                return False
            fd = str(binding.get("mode", "canfd")).lower() == "canfd"
            timing_matches = (
                status.bitrate == int(binding.get("bitrate", ARBITRATION_BITRATE))
                and status.fd is fd
            )
            if fd:
                timing_matches = timing_matches and status.dbitrate == int(
                    binding.get("dbitrate", DATA_BITRATE)
                )
            return (
                status.exists
                and status.up
                and timing_matches
                and status.bus_state not in {"bus-off", "stopped"}
            )

        all_up = bool(statuses) and all(
            healthy(status) for status in statuses
        )
        return {
            "connected": all_up,
            "all_up": all_up,
            "bitrate": (
                self._can_bindings[0].get("bitrate")
                if len(self._can_bindings) == 1
                else None
            ),
            "dbitrate": (
                self._can_bindings[0].get("dbitrate")
                if len(self._can_bindings) == 1
                else None
            ),
            "fd": (
                self._can_bindings[0].get("mode", "canfd") == "canfd"
                if len(self._can_bindings) == 1
                else None
            ),
            "bindings": [dict(item) for item in self._can_bindings],
            "interfaces": interfaces,
        }

    def _fake_can_statuses(self) -> list[CanInterfaceStatus]:
        connected = self._fake_can_connected
        return [
            CanInterfaceStatus(
                interface=str(binding["interface"]),
                exists=True,
                up=connected,
                operstate="up" if connected else "down",
                bitrate=int(binding["bitrate"]) if connected else None,
                dbitrate=(
                    int(binding["dbitrate"])
                    if connected
                    and binding.get("mode", "canfd") == "canfd"
                    and binding.get("dbitrate") is not None
                    else None
                ),
                fd=(
                    binding.get("mode", "canfd") == "canfd"
                    if connected
                    else None
                ),
                bus_state="error-active" if connected else "stopped",
                tx_errors=0,
                rx_errors=0,
                evidence=("fake: virtual SocketCAN state",),
            )
            for binding in self._can_bindings
        ]

    def can_status(self) -> dict[str, Any]:
        with self._lock:
            if not self._can_interfaces:
                return self._can_payload([])
            if self._backend_name == "fake":
                return self._can_payload(self._fake_can_statuses())
            return self._can_payload(
                self._can_manager.status(self._can_interfaces)
            )

    def can_interfaces(self) -> dict[str, Any]:
        """Discover policy-approved CAN links independently of station YAML."""

        allowed_interfaces = tuple(f"can{index}" for index in range(5))
        policy_payload: dict[str, Any] = {
            "allowed_interfaces": list(allowed_interfaces),
            "allowed_bitrates": sorted(ALLOWED_ARBITRATION_BITRATES),
            "allowed_dbitrates": sorted(ALLOWED_DATA_BITRATES),
            "allow_classic_can": True,
            "allow_can_fd": True,
        }
        try:
            from factory_hmi.can_helper import load_policy

            policy = load_policy()
            allowed_interfaces = tuple(sorted(policy.allowed_interfaces))
            policy_payload = {
                "allowed_interfaces": list(allowed_interfaces),
                "allowed_bitrates": sorted(policy.allowed_bitrates),
                "allowed_dbitrates": sorted(policy.allowed_dbitrates),
                "allow_classic_can": policy.allow_classic_can,
                "allow_can_fd": policy.allow_can_fd,
            }
        except Exception:
            # Source-tree and fake-backend development may not have an
            # installed root-owned policy; the helper still enforces it in
            # production before performing any privileged operation.
            pass

        try:
            existing = set(self._can_manager.list_interfaces())
            names = tuple(sorted(existing | set(allowed_interfaces)))
            statuses = self._can_manager.status(names)
        except Exception:
            names = allowed_interfaces
            statuses = [
                CanInterfaceStatus(
                    interface=name,
                    exists=False,
                    up=False,
                    operstate=None,
                    bitrate=None,
                    dbitrate=None,
                    fd=None,
                    bus_state=None,
                    tx_errors=None,
                    rx_errors=None,
                    evidence=("netlink enumeration unavailable",),
                )
                for name in names
            ]
        return {
            "items": [status.to_dict() for status in statuses],
            "policy": policy_payload,
        }

    def can_connect(
        self,
        *,
        bus_bindings: Sequence[Mapping[str, Any]] | None = None,
    ) -> dict[str, Any]:
        with self._lock:
            if not self._can_interfaces:
                raise RuntimeError("configure a station before connecting CAN")
            if bus_bindings is not None:
                requested = tuple(dict(item) for item in bus_bindings)
                if requested != self._can_bindings:
                    raise ValueError(
                        "CAN bindings changed after configuration; apply configuration again"
                    )
            if self._backend_name == "fake":
                self._fake_can_connected = True
            else:
                connected: list[str] = []
                try:
                    for binding in self._can_bindings:
                        interface = str(binding["interface"])
                        if interface in connected:
                            continue
                        self._can_manager.connect(
                            [interface],
                            bitrate=int(binding["bitrate"]),
                            dbitrate=(
                                int(binding["dbitrate"])
                                if binding.get("dbitrate") is not None
                                else None
                            ),
                            fd=binding.get("mode", "canfd") == "canfd",
                        )
                        connected.append(interface)
                except Exception:
                    if connected:
                        self._can_manager.disconnect(connected)
                    raise
                statuses = self._can_manager.status(self._can_interfaces)
                payload = self._can_payload(statuses)
                if not payload["all_up"]:
                    try:
                        self._can_manager.disconnect(self._can_interfaces)
                    finally:
                        raise RuntimeError(
                            "CAN helper completed but interfaces are not healthy"
                        )
            return self.snapshot()

    def can_disconnect(self) -> dict[str, Any]:
        with self._lock:
            if self._controller is not None and self._controller.backend.connected:
                raise RuntimeError("disconnect motors before disconnecting CAN")
            if self._backend_name == "fake":
                self._fake_can_connected = False
            elif self._can_interfaces:
                self._can_manager.disconnect(self._can_interfaces)
            return self.snapshot()

    def can_recover(self) -> dict[str, Any]:
        with self._lock:
            if self._controller is not None and self._controller.backend.connected:
                raise RuntimeError("disconnect motors before recovering CAN")
            if self._backend_name == "fake":
                self._fake_can_connected = True
            else:
                for binding in self._can_bindings:
                    self._can_manager.recover(
                        [str(binding["interface"])],
                        bitrate=int(binding["bitrate"]),
                        dbitrate=(
                            int(binding["dbitrate"])
                            if binding.get("dbitrate") is not None
                            else None
                        ),
                        fd=binding.get("mode", "canfd") == "canfd",
                    )
                statuses = self._can_manager.status(self._can_interfaces)
                if not self._can_payload(statuses)["all_up"]:
                    raise RuntimeError("CAN recovery did not restore healthy interfaces")
            return self.snapshot()

    def connect(self) -> dict[str, Any]:
        """Backward-compatible discovery plus enable operation."""

        if not self.can_status()["all_up"]:
            self.can_connect()
        self.discover_motors()
        return self.enable_motors(physical_estop_confirmed=True)

    def discover_motors(self) -> dict[str, Any]:
        if not self.can_status()["all_up"]:
            raise RuntimeError("connect and validate all CAN interfaces first")
        self.controller.discover_motors()
        return self.snapshot()

    def enable_motors(
        self,
        *,
        physical_estop_confirmed: bool,
    ) -> dict[str, Any]:
        if not physical_estop_confirmed:
            raise RuntimeError(
                "physical emergency-stop and safety circuit confirmation is required"
            )
        controller = self.controller
        was_enabled = controller.backend.motors_enabled
        try:
            controller.enable_motors()
        except Exception:
            # A partially failed all-motor enable leaves the transport open and
            # makes subsequent discover/configure actions report confusing
            # state conflicts. Close the motor transport deterministically;
            # SocketCAN itself stays up so the operator can correct the hardware
            # fault and scan again. A duplicate enable request must not tear
            # down an already healthy, position-holding station.
            if not was_enabled:
                try:
                    controller.disconnect()
                except Exception:
                    pass
            raise
        return self.snapshot()

    def disable_motors(self) -> dict[str, Any]:
        controller = self.controller
        controller.disable_motors()
        return self.snapshot()

    def disconnect(self) -> dict[str, Any]:
        controller = self.controller
        controller.disconnect()
        with self._lock:
            self._zeroing = None
        return self.snapshot()

    def import_trajectory(self, path: str) -> dict[str, Any]:
        source = Path(path).expanduser().resolve(strict=True)
        if not source.is_file():
            raise ValueError("trajectory path must be a file")
        safe_name = _SAFE_NAME.sub("_", source.name).strip("._")
        if not safe_name:
            raise ValueError("trajectory filename is invalid")
        destination = (self.trajectory_root / safe_name).resolve()
        if destination.parent != self.trajectory_root.resolve():
            raise ValueError("trajectory destination escapes the data directory")
        if source != destination:
            shutil.copy2(source, destination)
        trajectory = self.controller.load_trajectory(destination)
        return trajectory.to_dict()

    load_trajectory = import_trajectory

    def arm(self) -> dict[str, Any]:
        self.controller.arm()
        return self.snapshot()

    def start(
        self,
        *,
        speed: float = 1.0,
        loop: bool = True,
        cycles: int = 0,
        duration_hours: float | None = None,
        record: bool = True,
        recording_scope: str | None = None,
        record_rate_hz: float = 20.0,
        test_id: str | None = None,
        robot_id: str | None = None,
        execution_uuid: str | None = None,
        campaign_id: str | None = None,
        cycle_id: str | None = None,
        segment_id: str | None = None,
        asset_id: str | None = None,
        configuration_id: str | None = None,
        test_case_version_id: str | None = None,
        test_case_id: str | None = None,
        test_case_version: str | None = None,
        test_name: str | None = None,
        bench_id: str | None = None,
        station_id: str | None = None,
        operator_id: str | None = None,
        stage_code: str | None = None,
        stage_name: str | None = None,
        subject_map: Mapping[str, str] | None = None,
    ) -> dict[str, Any]:
        controller = self.controller
        report_context: dict[str, Any] | None = None
        record_path: Path | None = None
        sidecar: Path | None = None
        effective_test_id = test_id
        execution_code = ""
        selected_case = str(test_case_id or "").strip().upper()
        if not selected_case:
            raise ValueError("测试用例编号必填，没有对应用例请选择 OTHER 并填写测试名称")
        if selected_case == "OTHER":
            if not str(test_name or "").strip():
                raise ValueError("其他用例必须填写临时测试名称")
            if not str(robot_id or "").strip() or not str(bench_id or "").strip():
                raise ValueError("其他用例必须填写实际测试对象和工位")
        if record:
            started_at = datetime.now(timezone.utc)
            resolved_test_case = test_case_id or controller.config.limb
            resolved_sample = robot_id or ""
            resolved_bench = bench_id or os.environ.get("RP1_FACTORY_BENCH_ID", "")
            platform_context = {
                "campaign_id": campaign_id, "cycle_id": cycle_id,
                "segment_id": segment_id, "asset_id": asset_id,
                "configuration_id": configuration_id,
                "test_case_version_id": test_case_version_id,
            }
            has_platform_context = any(platform_context.values())
            scope = recording_scope or ("platform" if has_platform_context else "local")
            if scope not in {"local", "platform"}:
                raise ValueError("recording_scope must be local or platform")
            if scope == "local" and has_platform_context:
                raise ValueError("本地记录不能同时携带平台测试上下文；请明确选择记录用途。")
            execution_id = str(execution_uuid or uuid.uuid4())
            uuid.UUID(execution_id)
            if scope == "local":
                canonical_test_id = build_local_execution_code(
                    resolved_test_case, started_at, execution_id
                )
            else:
                resolved_test_case = str(test_case_id or "").strip().upper()
                resolved_sample = resolved_sample.strip().upper()
                resolved_bench = resolved_bench.strip().upper()
                platform_context["station_id"] = station_id or os.environ.get("RP1_FACTORY_STATION_ID", "")
                missing = [key for key, value in platform_context.items() if not value]
                if missing:
                    raise ValueError("平台记录上下文不完整，缺少：" + "、".join(missing))
                for key, value in platform_context.items():
                    try:
                        uuid.UUID(str(value))
                    except ValueError as exc:
                        raise ValueError(f"平台记录 {key} 必须是真实上下文的 UUID，不能使用显示编号。") from exc
                try:
                    build_execution_code(
                        resolved_test_case, started_at, resolved_sample, resolved_bench
                    )
                except ValueError as exc:
                    raise ValueError(f"平台记录编号不符合要求：{exc}。仅本地保存请取消选择平台档案。") from exc
                canonical_test_id = build_local_execution_code(
                    resolved_test_case, started_at, execution_id
                )
                execution_code = ""
            if test_id and test_id != canonical_test_id:
                raise ValueError(
                    "test_id does not match the canonical execution identity"
                )
            safe_test_id = _SAFE_NAME.sub("_", canonical_test_id).strip("._")
            effective_test_id = safe_test_id
            if not safe_test_id:
                raise ValueError("test_id does not contain a usable filename")
            record_path = self.record_root / f"{safe_test_id}.csv"
            if record_path.exists() or record_path.with_suffix(".context.json").exists():
                raise ValueError("记录编号已存在，不能覆盖之前的记录。")
            controller.enable_recording = True
            controller.record_output = record_path
            trajectory = controller.trajectory
            now = started_at.isoformat().replace("+00:00", "Z")
            report_context = {
                "execution_uuid": execution_id,
                "test_id": safe_test_id,
                "execution_code": execution_code,
                "recording_scope": scope,
                "campaign_id": campaign_id,
                "cycle_id": cycle_id,
                "segment_id": segment_id,
                "asset_id": asset_id,
                "configuration_id": configuration_id,
                "test_case_version_id": test_case_version_id,
                "test_case_id": resolved_test_case,
                "test_case_version": test_case_version or "",
                "test_name": str(test_name or resolved_test_case).strip(),
                "actual_object": resolved_sample,
                "sample_id": resolved_sample,
                "robot_id": resolved_sample,
                "bench_id": resolved_bench,
                "station_id": station_id
                or os.environ.get("RP1_FACTORY_STATION_ID", ""),
                "operator_id": operator_id or "",
                "stage_code": stage_code or "AGING",
                "stage_name": stage_name or "老化运行",
                "subject_map": dict(subject_map or {}),
                "started_at": now,
                "record_rate_hz": float(record_rate_hz),
                "module_name": controller.config.limb,
                "limb": controller.config.limb,
                "entries": [
                    {
                        "motor_id": int(getattr(entry, "motor_id", index)),
                        "joint_name": str(
                            getattr(entry, "joint_name", f"joint_{index}")
                        ),
                        "module_name": controller.config.limb,
                    }
                    for index, entry in enumerate(controller.config.entries)
                ],
                "software": {
                    "hmi_version": os.environ.get(
                        "RP1_FACTORY_HMI_VERSION", "0.1.0"
                    )
                },
                "config": controller.config.raw,
                "acceptance": controller.config.raw.get(
                    "factory_hmi_acceptance", {}
                ),
                "trajectory": trajectory.to_dict() if trajectory else {},
            }
            sidecar = record_path.with_suffix(".context.json")
            sidecar.write_text(
                json.dumps(
                    report_context,
                    ensure_ascii=False,
                    indent=2,
                    sort_keys=True,
                )
                + "\n",
                encoding="utf-8",
            )
        else:
            controller.enable_recording = False
            controller.record_output = None
        self._record_identity = {
            "test_id": effective_test_id or "",
            "execution_uuid": str((report_context or {}).get("execution_uuid") or ""),
            "execution_code": execution_code,
            "recording_scope": report_context.get("recording_scope", "") if report_context else "",
            "campaign_id": str((report_context or {}).get("campaign_id") or ""),
            "cycle_id": str((report_context or {}).get("cycle_id") or ""),
            "asset_id": str((report_context or {}).get("asset_id") or ""),
            "configuration_id": str((report_context or {}).get("configuration_id") or ""),
            "test_case_version_id": str((report_context or {}).get("test_case_version_id") or ""),
            "test_case_id": str((report_context or {}).get("test_case_id") or ""),
            "station_id": str((report_context or {}).get("station_id") or ""),
        }
        self._record_sidecar = sidecar if record else None
        self._live_report_context = report_context
        controller.start(
            loop=loop,
            cycles=cycles,
            duration_s=(
                None
                if duration_hours is None
                else float(duration_hours) * 3600.0
            ),
            speed=speed,
            record_rate_hz=record_rate_hz,
            test_id=effective_test_id,
            robot_id=robot_id,
        )
        if report_context is not None and record_path is not None:
            thread = threading.Thread(
                target=self._finalize_after_run,
                args=(controller, record_path, report_context),
                name=f"factory-report-{report_context['test_id']}",
                daemon=True,
            )
            with self._lock:
                self._report_threads.add(thread)
            thread.start()
        return self.snapshot()

    def pause(self) -> dict[str, Any]:
        self.controller.pause()
        return self.snapshot()

    def resume(self) -> dict[str, Any]:
        self.controller.resume()
        return self.snapshot()

    def stop(self, *, reason: str | None = None) -> dict[str, Any]:
        self._last_stop_reason = reason
        self.controller.stop()
        return self.snapshot()

    def prepare_next_run(self) -> dict[str, Any]:
        self.controller.prepare_next_run()
        return self.snapshot()

    def manual_move(
        self,
        *,
        targets_deg: Sequence[float],
        speed_deg_s: float,
    ) -> dict[str, Any]:
        controller = self.controller
        if len(targets_deg) != len(controller.config.entries):
            raise ValueError(
                f"manual target requires {len(controller.config.entries)} joints, "
                f"got {len(targets_deg)}"
            )
        controller.manual_move(
            np.deg2rad(np.asarray(targets_deg, dtype=np.float64)),
            speed_rad_s=float(np.deg2rad(speed_deg_s)),
        )
        return self.snapshot()

    def manual_stop(self) -> dict[str, Any]:
        self.controller.manual_stop()
        return self.snapshot()

    def record_file(self) -> Path:
        output = self.controller.record_output
        if output is None:
            raise RuntimeError("no recorded CSV is available")
        resolved = Path(output).expanduser().resolve()
        root = self.record_root.resolve()
        if resolved.parent != root:
            raise RuntimeError("recorded CSV is outside the records directory")
        if not resolved.is_file():
            raise RuntimeError("recorded CSV has not been finalized")
        return resolved

    def execution_history(self, limit: int = 100) -> list[dict[str, Any]]:
        items = self.report_manager.history(limit=limit)
        by_test_id = {item.test_id: item for item in self.outbox.list(limit=limit)}
        for item in items:
            queued = by_test_id.get(str(item["test_id"]))
            item.update(
                {
                    "sync_state": queued.state if queued else "local_completed",
                    "sync_error": queued.last_error if queued else "",
                    "review_reason": queued.review_reason if queued else "",
                    "submission_id": queued.submission_id if queued else "",
                    "execution_code": (
                        queued.execution_code if queued and queued.execution_code
                        else item.get("execution_code", "")
                    ),
                    "execution_code_confirmed": bool(queued and queued.execution_code),
                }
            )
        return items

    def execution_summary(self, test_id: str) -> dict[str, Any]:
        summary = self.report_manager.summary(test_id)
        queued = self.outbox.get_by_test_id(test_id)
        if queued and isinstance(queued.manifest.get("central_analysis"), Mapping):
            summary["central_analysis"] = dict(queued.manifest["central_analysis"])
        return summary

    def execution_report_file(self, test_id: str) -> Path:
        return self.report_manager.report_path(test_id)

    def execution_bundle_file(self, test_id: str) -> Path:
        return self.report_manager.bundle_path(test_id)

    def rebuild_report(self, test_id: str) -> dict[str, Any]:
        result = self.report_manager.rebuild(test_id)
        return self._report_result(result)

    def submit_execution(
        self,
        test_id: str,
        reason: str = "",
        verified_status: str = "",
        operator_summary: str = "",
        review: Mapping[str, Any] | None = None,
    ) -> dict[str, Any]:
        queued = self.outbox.get_by_test_id(test_id)
        if queued and queued.state in {"approved", "uploaded", "pending_review", "archived", "awaiting_classification", "processing_failed"}:
            return queued.to_dict()
        if not review:
            raise ValueError("必须核实测试人、有效工位、人工结论和测试员记录后才能提交")
        if queued and queued.submission_payload and queued.state not in {"rejected", "needs_verification"}:
            raise ValueError("已有上传或送审请求等待确认，请先重试归档恢复回执后再修改核实信息")
        central_analysis = queued.manifest.get("central_analysis") if queued else None
        review_path = self.report_manager.write_operator_review(test_id, review, central_analysis=central_analysis)
        verified = json.loads(review_path.read_text(encoding="utf-8"))
        manifest = dict(self.report_manager.manifest(test_id))
        raw_path = self.report_manager.execution_dir(test_id) / "telemetry/raw.csv"
        expected = next((entry for entry in manifest.get("files", []) if entry.get("path") == "telemetry/raw.csv"), None)
        import hashlib
        digest = hashlib.sha256()
        with raw_path.open("rb") as handle:
            while chunk := handle.read(1024 * 1024):
                digest.update(chunk)
        if not expected or expected["sha256"] != digest.hexdigest() or expected["size_bytes"] != raw_path.stat().st_size:
            raise ValueError("原始采集文件与已冻结证据不一致，不能提交")
        actual_object = verified.get("actual_object") or manifest.get("actual_object") or manifest.get("sample_id")
        test_name = verified.get("test_name") or manifest.get("test_name")
        if not actual_object or actual_object == "unknown" or not test_name:
            raise ValueError("请补齐测试名称和实际测试对象")
        manifest.update(archive_protocol="reliability_v1_csv", csv_path=str(raw_path),
            operator_review=verified, test_name=test_name, actual_object=actual_object,
            submission_reason=str(reason or verified["submission_reason"]).strip()[:300])
        if central_analysis:
            manifest["central_analysis"] = central_analysis
        item = self.outbox.enqueue(
            manifest,
            self.report_manager.bundle_path(test_id),
        )
        if queued and queued.submission_payload:
            frozen = json.loads(queued.submission_payload)
            if "create" in frozen:
                item = self.outbox.update(item.execution_uuid, submission_payload=json.dumps(
                    {"create": frozen["create"], "review": verified}, ensure_ascii=False, sort_keys=True))
        return item.to_dict()

    def retry_submission(self, test_id: str) -> dict[str, Any]:
        item = self.outbox.get_by_test_id(test_id)
        if item is None:
            raise ValueError("尚未核实提交，请先打开核实窗口")
        if item.state in {"rejected", "needs_verification"}:
            raise ValueError("驳回后必须重新核实并提交，不能直接重试旧结论")
        return self.outbox.retry(item.execution_uuid).to_dict()

    def import_history(self, paths: Sequence[str], metadata: Mapping[str, Any]) -> list[dict[str, Any]]:
        """Explicit local selection only; never uploads or starts hardware."""
        from factory_hmi.core.report import _read_csv, _sha256
        if not paths or len(paths) > 100:
            raise ValueError("请选择 1 至 100 个历史 CSV")
        results = []
        for value in paths:
            source = Path(value).expanduser()
            if source.is_symlink() or source.suffix.lower() != ".csv":
                raise ValueError("只能选择普通 CSV 文件")
            source = source.resolve(strict=True)
            digest = _sha256(source)
            sidecar = source.with_suffix(".context.json")
            context = json.loads(sidecar.read_text(encoding="utf-8")) if sidecar.is_file() else {}
            if not isinstance(context, dict):
                raise ValueError("历史上下文文件格式无效")
            context.setdefault("actual_object", context.get("sample_id") or context.get("robot_id") or "")
            context.setdefault("test_name", context.get("test_case_id") or "")
            identity = str(context.get("execution_uuid") or uuid.uuid5(uuid.NAMESPACE_URL, "rp1-history-sha256:" + digest))
            uuid.UUID(identity)
            known = None
            for item in self.report_manager.history(limit=10000):
                existing_manifest = self.report_manager.manifest(item["test_id"])
                same_file = any(entry.get("path") == "telemetry/raw.csv" and entry.get("sha256") == digest for entry in existing_manifest.get("files", []))
                if item["execution_uuid"] == identity or same_file:
                    known = item
                    break
            if known:
                results.append({**known, "duplicate": True})
                continue
            for field in ("test_name", "actual_object", "bench_id", "operator_id"):
                explicit = str(metadata.get(field) or context.get(field) or "").strip()
                if not explicit:
                    raise ValueError("历史补录必须填写测试名称、实际对象、工位和测试人")
                context[field] = explicit
            _, _, times, _ = _read_csv(source)
            # Relative duration is measured from CSV; unknown absolute clocks stay
            # explicitly MISSING on the wire (epoch is only a local report placeholder).
            has_clock = bool(context.get("started_at") and context.get("ended_at"))
            formal_keys = ("campaign_id", "cycle_id", "segment_id", "asset_id", "configuration_id", "test_case_version_id", "station_id")
            formal_context = all(context.get(key) for key in formal_keys) and context.get("test_case_id") not in {None, "", "OTHER"}
            if formal_context:
                try:
                    for key in formal_keys:
                        uuid.UUID(str(context[key]))
                except ValueError:
                    formal_context = False
            context.update(execution_uuid=identity, test_id="HISTORY_" + identity.replace("-", ""),
                origin="HISTORY", recording_scope="platform" if formal_context else "local", test_case_id=context.get("test_case_id") or "OTHER",
                sample_id=context["actual_object"], machine_status=context.get("machine_status") or "unknown",
                timestamp_provenance="recorded" if has_clock else "missing",
                started_at=context.get("started_at") or "1970-01-01T00:00:00Z",
                ended_at=context.get("ended_at") or "1970-01-01T00:00:00Z",
                active_seconds=context.get("active_seconds", max(times, default=0.0) - min(times, default=0.0)),
                completed_cycles=context.get("completed_cycles", 0), outcome=context.get("outcome") or "interrupted")
            result = self.report_manager.finalize(source, context)
            results.append(self._report_result(result))
        return results

    def sync_status(self, test_id: str) -> dict[str, Any]:
        item = self.outbox.get_by_test_id(test_id)
        return (
            item.to_dict()
            if item is not None
            else {"test_id": test_id, "state": "local_completed"}
        )

    def recover_reports(self) -> list[dict[str, Any]]:
        return [
            self._report_result(result)
            for result in self.report_manager.recover_orphans(self.record_root)
        ]

    def _recover_existing_records(self) -> None:
        current = threading.current_thread()
        try:
            self.recover_reports()
        except Exception as exc:
            with self._lock:
                self._report_errors["startup-recovery"] = str(exc)
        finally:
            with self._lock:
                self._report_threads.discard(current)

    def _finalize_after_run(
        self,
        controller: FactoryController,
        record_path: Path,
        context: dict[str, Any],
    ) -> None:
        current = threading.current_thread()
        test_id = str(context["test_id"])
        try:
            controller.wait()
            snapshot = controller.snapshot()
            playback = snapshot.get("playback")
            progress = (
                playback.get("progress", {})
                if isinstance(playback, Mapping)
                else {}
            )
            fault = snapshot.get("fault")
            context.update(
                {
                    "ended_at": datetime.now(timezone.utc)
                    .isoformat()
                    .replace("+00:00", "Z"),
                    "active_seconds": float(progress.get("active_seconds") or 0),
                    "completed_cycles": int(
                        progress.get("completed_cycles") or 0
                    ),
                    "outcome": str(progress.get("outcome") or "interrupted"),
                    "manual_stop": progress.get("outcome") == "stopped",
                    "safety_failure": bool(fault),
                    "stop_reason": (
                        str(fault.get("message") or "")
                        if isinstance(fault, Mapping)
                        else self._last_stop_reason or ""
                    ),
                }
            )
            self.report_manager.finalize(record_path, context)
            record_path.with_suffix(".context.json").unlink(missing_ok=True)
            with self._lock:
                self._report_errors.pop(test_id, None)
        except Exception as exc:
            with self._lock:
                self._report_errors[test_id] = str(exc)
        finally:
            with self._lock:
                self._report_threads.discard(current)

    @staticmethod
    def _report_result(result: ReportResult) -> dict[str, Any]:
        return {
            "test_id": result.manifest["test_id"],
            "execution_uuid": result.manifest["execution_uuid"],
            "bundle_path": str(result.bundle_path),
            "summary_path": str(result.summary_path),
            "report_path": str(result.report_path),
            "verdict": result.summary["verdict"]["status"],
        }

    def reset(self) -> dict[str, Any]:
        controller = self.controller
        controller.reset(to_default=True)
        return self.snapshot()

    reset_to_default = reset

    def reset_motor_fault(self) -> dict[str, Any]:
        if not self.can_status()["all_up"]:
            raise RuntimeError("connect and validate CAN before resetting motor faults")
        self.controller.reset_motor_fault()
        return self.snapshot()

    def request_motion_stop(self) -> bool:
        # Do not take the controller's command lock: reset holds it while
        # returning. Signalling is cancellation-only and does not touch CAN.
        controller = self._controller
        return bool(controller and controller.request_motion_stop())

    def disable(self) -> dict[str, Any]:
        controller = self.controller
        if controller.state in {StationState.RUNNING, StationState.PAUSED}:
            controller.stop()
        controller.disconnect()
        return self.snapshot()

    emergency_disable = disable

    def zero_motor(self, motor_index: int) -> dict[str, Any]:
        result = self.controller.zero_motors([int(motor_index)])
        return {
            **result,
            "snapshot": self.snapshot(),
        }

    def zero_all_motors(self) -> dict[str, Any]:
        controller = self.controller
        result = controller.zero_motors(
            list(range(len(controller.config.entries)))
        )
        return {
            **result,
            "snapshot": self.snapshot(),
        }

    def zero_prepare(self, motor_index: int) -> dict[str, Any]:
        controller = self.controller
        with self._lock:
            if self._zeroing is not None and self._zeroing.state.value == "reading":
                if self._zeroing.current_index == int(motor_index):
                    return self._zeroing.snapshot()
                raise RuntimeError(
                    "finish or abort the current motor zeroing before selecting another"
                )
            # Each row action is an independent single-motor operation. A
            # confirmed motor must not force the operator through the remaining
            # motor list or prevent selecting the same motor again later.
            self._zeroing = controller.create_zeroing_session()
            return self._zeroing.prepare(motor_index)

    def zero_read(self) -> dict[str, Any]:
        return self._require_zeroing().read().to_dict()

    def zero_confirm(self, *, allow_on_fault: bool = False) -> dict[str, Any]:
        if allow_on_fault:
            raise ValueError("factory gateway does not permit fault-state zeroing")
        result = self._require_zeroing().confirm(force_on_error=False)
        return {"zeroed": bool(result), "zeroing": self._require_zeroing().snapshot()}

    def zero_skip(self) -> dict[str, Any]:
        skipped = self._require_zeroing().skip()
        return {"skipped_index": skipped, "zeroing": self._require_zeroing().snapshot()}

    def zero_abort(self) -> dict[str, Any]:
        zeroing = self._require_zeroing()
        zeroing.abort()
        return zeroing.snapshot()

    def adopt_platform_execution_code(self, execution_code: str) -> dict[str, str]:
        code = str(execution_code or "").strip()
        if "_E" not in code:
            raise ValueError("平台执行编号必须包含数据库分配的 _E 后缀")
        with self._lock:
            if not self._record_identity.get("test_id"):
                raise RuntimeError("没有正在记录的平台测试")
            self._record_identity["execution_code"] = code
            if self._live_report_context is not None:
                self._live_report_context["execution_code"] = code
            sidecar = self._record_sidecar
        if sidecar is not None and sidecar.is_file():
            payload = json.loads(sidecar.read_text(encoding="utf-8"))
            payload["execution_code"] = code
            sidecar.write_text(
                json.dumps(payload, ensure_ascii=False, indent=2, sort_keys=True) + "\n",
                encoding="utf-8",
            )
        return {"execution_code": code}

    def snapshot(self) -> dict[str, Any]:
        with self._lock:
            if self._controller is None:
                return {
                    "state": "disconnected",
                    "connected": False,
                    "configured": False,
                    "station": {
                        "connection_phase": "can_disconnected",
                        "can_connected": False,
                        "motors_discovered": False,
                        "motors_enabled": False,
                    },
                    "motors": [],
                    "configured_motors": [],
                    "trajectory": None,
                    "progress": None,
                    "can": self._can_payload([]),
                    "fault": None,
                    "diagnostics": [],
                }
            snapshot = self._controller.snapshot()
            playback = snapshot.get("playback")
            identity = dict(self._record_identity)
            if isinstance(playback, dict) and playback.get("test_id") == identity.get("test_id"):
                playback["execution_code"] = identity.get("execution_code", "")
                playback["execution_uuid"] = identity.get("execution_uuid", "")
            snapshot["platform"] = {
                key: identity.get(key, "")
                for key in (
                    "campaign_id", "cycle_id", "asset_id", "configuration_id",
                    "test_case_version_id", "test_case_id", "station_id", "execution_code",
                )
            }
            snapshot["platform"]["execution_uuid"] = (
                identity.get("execution_uuid", "") if isinstance(playback, dict)
                and playback.get("test_id") and playback.get("test_id") == identity.get("test_id") else ""
            )
            configured_motors = [
                {
                    "index": int(entry.index),
                    "motor_id": int(entry.motor_id),
                    "joint_name": entry.joint_name,
                    "bus": entry.interface,
                    "motor_type": entry.motor_type,
                    "motor_model": int(entry.motor_model),
                }
                for entry in self._controller.config.entries
            ]
            station = dict(snapshot.get("station") or {})
            state = str(station.get("state", self._controller.state.value))
            fault = snapshot.get("fault")
            diagnoses = fault.get("diagnoses", []) if isinstance(fault, dict) else []
            can_snapshot = self.can_status()
            motors_discovered = bool(station.get("backend_connected", False))
            motors_enabled = bool(station.get("motors_enabled", False))
            if motors_enabled:
                connection_phase = "motors_enabled"
            elif motors_discovered:
                connection_phase = "motors_discovered"
            elif can_snapshot["all_up"]:
                connection_phase = "can_connected"
            else:
                connection_phase = "can_disconnected"
            station.update(
                {
                    "connection_phase": connection_phase,
                    "can_connected": bool(can_snapshot["all_up"]),
                    "motors_discovered": motors_discovered,
                    "motors_enabled": motors_enabled,
                }
            )
            snapshot.update(
                {
                    "state": state,
                    "connected": motors_discovered,
                    "configured": True,
                    "backend": self._backend_name,
                    "config_path": str(self._config_path) if self._config_path else None,
                    "configured_motors": configured_motors,
                    "station": station,
                    "can": can_snapshot,
                    "diagnostics": diagnoses,
                    "last_stop_reason": self._last_stop_reason,
                    "report_errors": dict(self._report_errors),
                    "zeroing": (
                        self._zeroing.snapshot()
                        if self._zeroing is not None
                        else snapshot.get("zeroing")
                    ),
                }
            )
            return snapshot

    def _require_zeroing(self) -> MotorZeroingSession:
        with self._lock:
            if self._zeroing is None:
                raise RuntimeError("zeroing session has not been prepared")
            return self._zeroing


__all__ = ["FactoryService"]
