Roboparty/RP1_test/software/host/factory_hmi/core/report.py

"""Offline execution-bundle finalization for the factory aging HMI."""

from __future__ import annotations

import csv
import gzip
import hashlib
import io
import json
import math
import os
import shutil
import statistics
import tarfile
import tempfile
import threading
import uuid
from dataclasses import dataclass
from datetime import datetime, timezone
from pathlib import Path
from typing import Any, Iterable, Mapping

import yaml


SCHEMA_VERSION = "1.0"
BUNDLE_FORMAT = "rp1-execution-bundle"
SUMMARY_PATH = "analysis/summary.json"
TELEMETRY_PATH = "telemetry/raw.csv"
_FILE_ROLES = {
    TELEMETRY_PATH: "telemetry",
    SUMMARY_PATH: "summary",
    "analysis/report.md": "report",
    "logs/native.log": "log",
    "config/station.yaml": "config",
    "config/execution.json": "config",
    "trajectory/metadata.json": "trajectory_metadata",
}


@dataclass(frozen=True)
class ReportResult:
    execution_dir: Path
    manifest_path: Path
    summary_path: Path
    report_path: Path
    bundle_path: Path
    manifest: dict[str, Any]
    summary: dict[str, Any]


def _utc_iso(value: Any = None) -> str:
    if isinstance(value, str) and value.strip():
        parsed = datetime.fromisoformat(value.strip().replace("Z", "+00:00"))
    elif isinstance(value, datetime):
        parsed = value
    elif isinstance(value, (int, float)):
        parsed = datetime.fromtimestamp(float(value), tz=timezone.utc)
    else:
        parsed = datetime.now(timezone.utc)
    if parsed.tzinfo is None:
        parsed = parsed.replace(tzinfo=timezone.utc)
    return parsed.astimezone(timezone.utc).isoformat().replace("+00:00", "Z")


def _seconds_between(started_at: str, ended_at: str) -> float:
    start = datetime.fromisoformat(started_at.replace("Z", "+00:00"))
    end = datetime.fromisoformat(ended_at.replace("Z", "+00:00"))
    return max(0.0, (end - start).total_seconds())


def _safe_test_id(value: str) -> str:
    value = value.strip()
    if not value or value in {".", ".."}:
        raise ValueError("test_id must not be empty")
    if any(character not in "abcdefghijklmnopqrstuvwxyzABCDEFGHIJKLMNOPQRSTUVWXYZ0123456789._-" for character in value):
        raise ValueError("test_id may contain only letters, digits, dot, underscore, and dash")
    return value


def _json_bytes(value: Any) -> bytes:
    return (
        json.dumps(
            value,
            ensure_ascii=False,
            indent=2,
            sort_keys=True,
            allow_nan=False,
        )
        + "\n"
    ).encode("utf-8")


def _write_fsynced(path: Path, payload: bytes) -> None:
    path.parent.mkdir(parents=True, exist_ok=True)
    temporary = path.with_name(f".{path.name}.{uuid.uuid4().hex}.tmp")
    with temporary.open("wb") as handle:
        handle.write(payload)
        handle.flush()
        os.fsync(handle.fileno())
    os.replace(temporary, path)


def _fsync_directory(path: Path) -> None:
    descriptor = os.open(path, os.O_RDONLY)
    try:
        os.fsync(descriptor)
    finally:
        os.close(descriptor)


def _sha256(path: Path) -> str:
    digest = hashlib.sha256()
    with path.open("rb") as handle:
        while True:
            chunk = handle.read(1024 * 1024)
            if not chunk:
                break
            digest.update(chunk)
    return digest.hexdigest()


def _finite(value: Any) -> float | None:
    try:
        number = float(value)
    except (TypeError, ValueError):
        return None
    return number if math.isfinite(number) else None


def _quantile(values: Iterable[float], quantile: float) -> float | None:
    ordered = sorted(float(value) for value in values if math.isfinite(float(value)))
    if not ordered:
        return None
    if len(ordered) == 1:
        return ordered[0]
    position = (len(ordered) - 1) * float(quantile)
    lower = math.floor(position)
    upper = math.ceil(position)
    if lower == upper:
        return ordered[lower]
    fraction = position - lower
    return ordered[lower] * (1.0 - fraction) + ordered[upper] * fraction


def _maximum(values: Iterable[float | None]) -> float | None:
    finite = [float(value) for value in values if value is not None and math.isfinite(float(value))]
    return max(finite) if finite else None


def _metric_rule(
    name: str,
    actual: float | int | str | None,
    limit: float | int | str | None,
    unit: str,
    *,
    passed: bool | None,
    detail: str = "",
) -> dict[str, Any]:
    return {
        "name": name,
        "result": (
            "not_evaluated"
            if passed is None
            else ("passed" if passed else "failed")
        ),
        "actual": actual,
        "limit": limit,
        "unit": unit,
        "detail": detail,
    }


def _read_csv(path: Path) -> tuple[list[str], list[dict[str, str]], list[float], bool]:
    with path.open("r", encoding="utf-8-sig", newline="") as handle:
        reader = csv.DictReader(handle)
        if not reader.fieldnames:
            raise ValueError(f"{path} has no CSV header")
        fields = list(reader.fieldnames)
        rows = list(reader)
    times: list[float] = []
    non_monotonic = False
    previous: float | None = None
    for row in rows:
        value = _finite(row.get("time_s"))
        if value is None:
            continue
        if previous is not None and value <= previous:
            non_monotonic = True
        previous = value
        times.append(value)
    return fields, rows, times, non_monotonic


def _joint_names(fields: Iterable[str]) -> list[str]:
    names = [
        field[: -len("_cmd_pos_rad")]
        for field in fields
        if field.endswith("_cmd_pos_rad")
    ]
    if names:
        return names
    return [
        field[: -len("_pos_rad")]
        for field in fields
        if field.endswith("_pos_rad") and not field.endswith("_cmd_pos_rad")
    ]


def _entry_map(context: Mapping[str, Any]) -> dict[str, dict[str, Any]]:
    entries = context.get("entries")
    if not isinstance(entries, list):
        return {}
    result: dict[str, dict[str, Any]] = {}
    for index, raw in enumerate(entries):
        if not isinstance(raw, Mapping):
            continue
        name = str(raw.get("joint_name", "")).strip()
        if name:
            result[name] = {
                "motor_id": int(raw.get("motor_id", index)),
                "module_name": str(
                    raw.get("module_name")
                    or context.get("module_name")
                    or context.get("limb")
                    or "unknown"
                ),
            }
    return result


def _joint_metrics(
    fields: list[str],
    rows: list[dict[str, str]],
    times: list[float],
    context: Mapping[str, Any],
    expected_samples: int,
    max_gap: float,
) -> list[dict[str, Any]]:
    names = _joint_names(fields)
    if not names:
        raise ValueError("telemetry CSV contains no joint position columns")
    entries = _entry_map(context)
    acceptance = context.get("acceptance")
    if not isinstance(acceptance, Mapping):
        acceptance = {}
    ratings = acceptance.get("rated_torque_nm")
    if not isinstance(ratings, Mapping):
        ratings = {}
    active_seconds = max(0.0, float(context.get("active_seconds") or 0.0))
    stable_window = min(60.0, active_seconds * 0.1)
    valid_times = sorted(times)
    first_time = valid_times[0] if valid_times else 0.0
    last_time = valid_times[-1] if valid_times else first_time
    result: list[dict[str, Any]] = []
    for index, name in enumerate(names):
        samples: list[tuple[float, dict[str, str]]] = []
        for row in rows:
            timestamp = _finite(row.get("time_s"))
            if timestamp is not None:
                samples.append((timestamp, row))
        temperatures = [
            value
            for _, row in samples
            if (value := _finite(row.get(f"{name}_temp_c"))) is not None
        ]
        start_temperatures = [
            value
            for timestamp, row in samples
            if timestamp <= first_time + stable_window
            and (value := _finite(row.get(f"{name}_temp_c"))) is not None
        ]
        end_temperatures = [
            value
            for timestamp, row in samples
            if timestamp >= last_time - stable_window
            and (value := _finite(row.get(f"{name}_temp_c"))) is not None
        ]
        start_temperature = (
            float(statistics.median(start_temperatures))
            if start_temperatures
            else None
        )
        end_temperature = (
            float(statistics.median(end_temperatures))
            if end_temperatures
            else None
        )
        peak_temperature = max(temperatures) if temperatures else None
        torques = [
            abs(value)
            for _, row in samples
            if (value := _finite(row.get(f"{name}_torque_nm"))) is not None
        ]
        tracking = [
            command - position
            for _, row in samples
            if (command := _finite(row.get(f"{name}_cmd_pos_rad"))) is not None
            and (position := _finite(row.get(f"{name}_pos_rad"))) is not None
        ]
        fault_count = 0
        active_fault = False
        for _, row in samples:
            error = _finite(row.get(f"{name}_error_id"))
            fault = error is not None and int(error) != 0
            if fault and not active_fault:
                fault_count += 1
            active_fault = fault
        entry = entries.get(name, {})
        rated = _finite(ratings.get(name))
        p999 = _quantile(torques, 0.999)
        result.append(
            {
                "module_name": str(
                    entry.get("module_name")
                    or context.get("module_name")
                    or context.get("limb")
                    or "unknown"
                ),
                "joint_name": name,
                "motor_id": int(entry.get("motor_id", index)),
                "sample_count": len(samples),
                "sample_completeness": min(
                    1.0,
                    len(samples) / expected_samples if expected_samples else 0.0,
                ),
                "max_gap_seconds": max_gap,
                "temperature_start_c": start_temperature,
                "temperature_end_c": end_temperature,
                "temperature_peak_c": peak_temperature,
                "temperature_rise_c": (
                    end_temperature - start_temperature
                    if start_temperature is not None and end_temperature is not None
                    else None
                ),
                "temperature_peak_rise_c": (
                    peak_temperature - start_temperature
                    if start_temperature is not None and peak_temperature is not None
                    else None
                ),
                "torque_peak_abs_nm": max(torques) if torques else None,
                "torque_p999_abs_nm": p999,
                "torque_mean_abs_nm": (
                    sum(torques) / len(torques) if torques else None
                ),
                "rated_torque_nm": rated,
                "torque_utilization": (
                    p999 / rated
                    if p999 is not None and rated is not None and rated > 0.0
                    else None
                ),
                "tracking_rms_rad": (
                    math.sqrt(sum(value * value for value in tracking) / len(tracking))
                    if tracking
                    else None
                ),
                "tracking_max_rad": (
                    max(abs(value) for value in tracking) if tracking else None
                ),
                "fault_count": fault_count,
            }
        )
    return result


def _build_verdict(
    context: Mapping[str, Any],
    quality: Mapping[str, Any],
    joints: list[dict[str, Any]],
    *,
    non_monotonic: bool,
) -> dict[str, Any]:
    acceptance = context.get("acceptance")
    if not isinstance(acceptance, Mapping):
        acceptance = {}
    criteria_version = str(acceptance.get("criteria_version") or "UNCONFIGURED")
    rules: list[dict[str, Any]] = []
    blocked_names: set[str] = set()
    failed_names: set[str] = set()

    def minimum(name: str, actual: float | int, key: str, unit: str) -> None:
        limit = _finite(acceptance.get(key))
        passed = None if limit is None else float(actual) >= limit
        rules.append(_metric_rule(name, actual, limit, unit, passed=passed))
        if passed is False:
            blocked_names.add(name)

    def maximum(
        name: str,
        actual: float | None,
        key: str,
        unit: str,
        *,
        product_failure: bool,
    ) -> None:
        limit = _finite(acceptance.get(key))
        passed = None if actual is None or limit is None else actual <= limit
        rules.append(_metric_rule(name, actual, limit, unit, passed=passed))
        if passed is False:
            (failed_names if product_failure else blocked_names).add(name)

    minimum(
        "required_active_seconds",
        float(context.get("active_seconds") or 0.0),
        "required_active_seconds",
        "s",
    )
    minimum(
        "required_cycles",
        int(context.get("completed_cycles") or 0),
        "required_cycles",
        "cycles",
    )
    minimum(
        "sample_completeness",
        float(quality["sample_completeness"]),
        "min_sample_completeness",
        "ratio",
    )
    maximum(
        "max_gap_seconds",
        float(quality["max_gap_seconds"]),
        "max_gap_seconds",
        "s",
        product_failure=False,
    )
    monotonic_rule = _metric_rule(
        "monotonic_time",
        "non_monotonic" if non_monotonic else "monotonic",
        "monotonic",
        "",
        passed=not non_monotonic,
    )
    rules.append(monotonic_rule)
    if non_monotonic:
        blocked_names.add("monotonic_time")

    for joint in joints:
        name = str(joint["joint_name"])
        maximum(
            f"{name}.temperature_peak_rise_c",
            joint["temperature_peak_rise_c"],
            "max_temperature_rise_c",
            "°C",
            product_failure=True,
        )
        maximum(
            f"{name}.torque_p999_utilization",
            joint["torque_utilization"],
            "max_torque_p999_utilization",
            "ratio",
            product_failure=True,
        )
        maximum(
            f"{name}.tracking_rms_rad",
            joint["tracking_rms_rad"],
            "max_tracking_rms_rad",
            "rad",
            product_failure=True,
        )
        fault_name = f"{name}.fault_intervals"
        no_faults = int(joint["fault_count"]) == 0
        rules.append(
            _metric_rule(
                fault_name,
                int(joint["fault_count"]),
                0,
                "intervals",
                passed=no_faults,
                detail="non-zero drive faults are motor safety failures",
            )
        )
        if not no_faults:
            failed_names.add(fault_name)

    explicit_failure = bool(
        context.get("product_failure") or context.get("safety_failure")
    )
    rules.append(
        _metric_rule(
            "terminal_safety_or_product_failure",
            "true" if explicit_failure else "false",
            "false",
            "",
            passed=not explicit_failure,
        )
    )
    if explicit_failure:
        failed_names.add("terminal_safety_or_product_failure")

    outcome = str(context.get("outcome") or "")
    interrupted = bool(context.get("manual_stop")) or outcome in {
        "stopped",
        "fault",
        "interrupted",
    }
    if interrupted and not explicit_failure:
        blocked_names.add("execution_interrupted")
        rules.append(
            _metric_rule(
                "execution_interrupted",
                outcome or "manual_stop",
                "completed",
                "",
                passed=False,
                detail=str(context.get("stop_reason") or "execution did not complete"),
            )
        )

    if failed_names:
        status = "failed"
        reasons = [f"failed rule: {name}" for name in sorted(failed_names)]
    elif blocked_names:
        status = "blocked"
        reasons = [f"blocked rule: {name}" for name in sorted(blocked_names)]
    elif criteria_version == "UNCONFIGURED" or any(rule["result"] == "not_evaluated" for rule in rules):
        status = "unconfigured"
        reasons = [f"unconfigured rule: {rule['name']}" for rule in rules if rule["result"] == "not_evaluated"]
        if not reasons:
            reasons = ["acceptance criteria not configured"]
    else:
        status = "passed"
        reasons = []
    return {
        "status": status,
        "criteria_version": criteria_version,
        "reasons": reasons,
        "rules": rules,
    }
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
