Roboparty/RP1_test/(commit log)

2026-10-09 Improve test tooling, documentation, licensing and CAD delivery
2026-10-15 Add Parasolid assembly model release downloads
2026-10-19 Clean up current documentation and isolate optional tooling
2026-10-19 Retire legacy tooling and simplify current docs and UI
